alex1324575/snake-pcb-business-card/fabrication/drill_report.txt

Drill report for SnakeBusinessCard.kicad_pcb
Created on 2026-10-12T01:39:45

Copper Layer Stackup:
    =============================================================
    L1 :  F.Cu                      front
    L2 :  B.Cu                      back

Drill file 'SnakeBusinessCard-PTH.drl' contains
    plated through holes:
    =============================================================
    T1  0.300mm  0.0118"  (175 holes))
    T2  0.300mm  0.0118"  (2 holes))
    T3  0.500mm  0.0197"  (4 holes)  (with 4 slots)

    Total plated holes count 181

Drill file 'SnakeBusinessCard-NPTH.drl' contains
    unplated through holes:
    =============================================================

    Total unplated holes count 0
