alex1324575/snake-pcb-business-card/contact/Example_QR.png

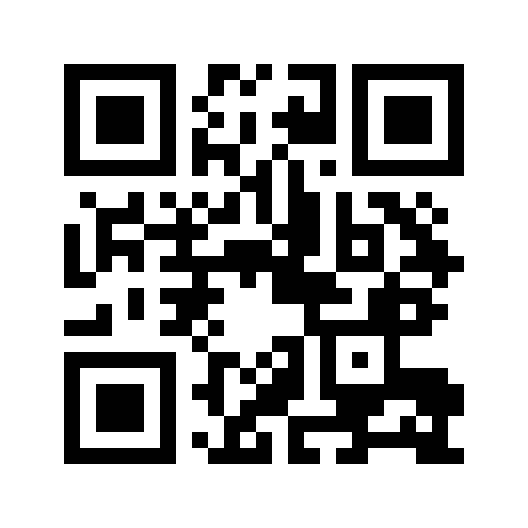
contact/Example_QR.png
