alex1324575/snake-pcb-business-card/docs/images/isometric.png

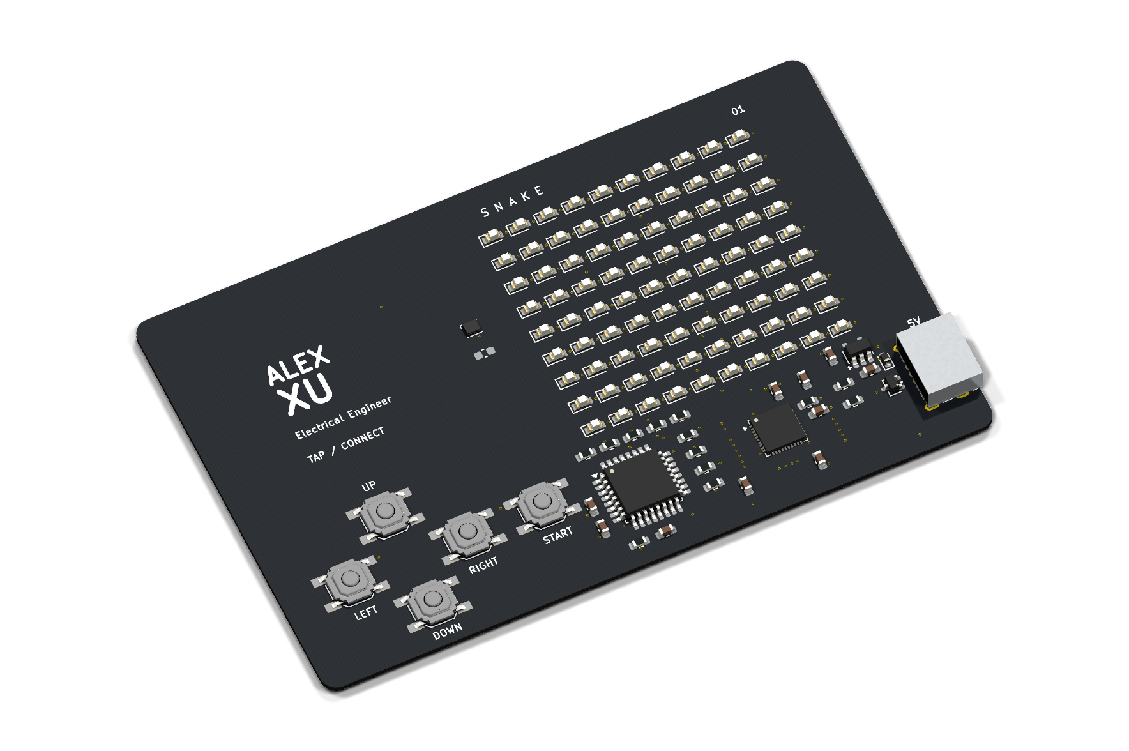
docs/images/isometric.png
