alex1324575/snake-pcb-business-card/docs/images/revc-3d-isometric.png

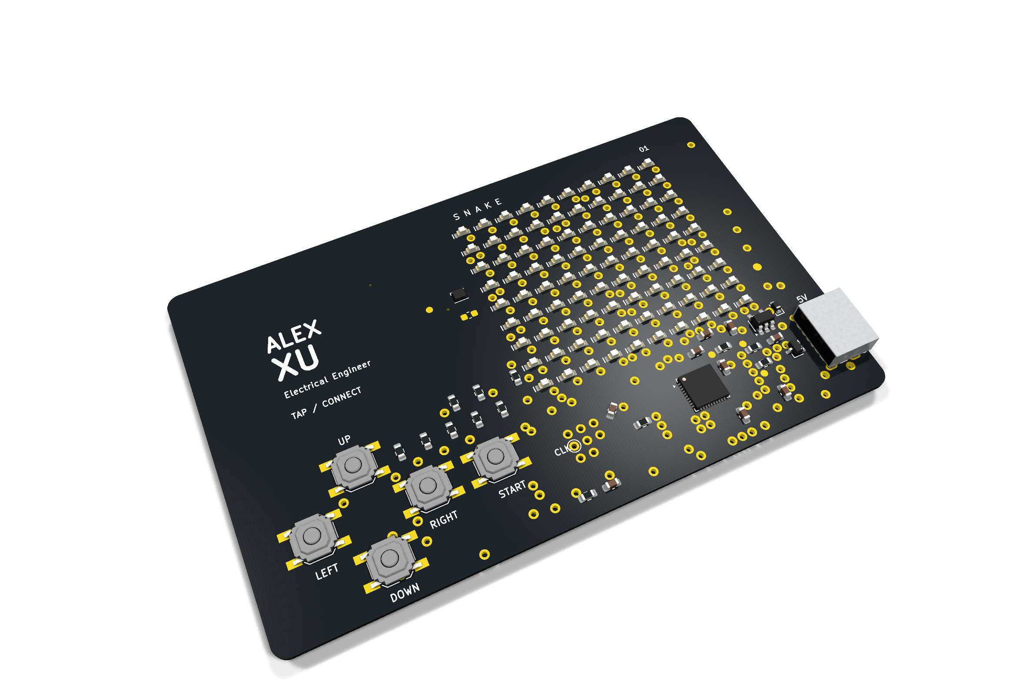
docs/images/revc-3d-isometric.png
