alex1324575/snake-pcb-business-card/docs/images/revc-3d-rotation.gif

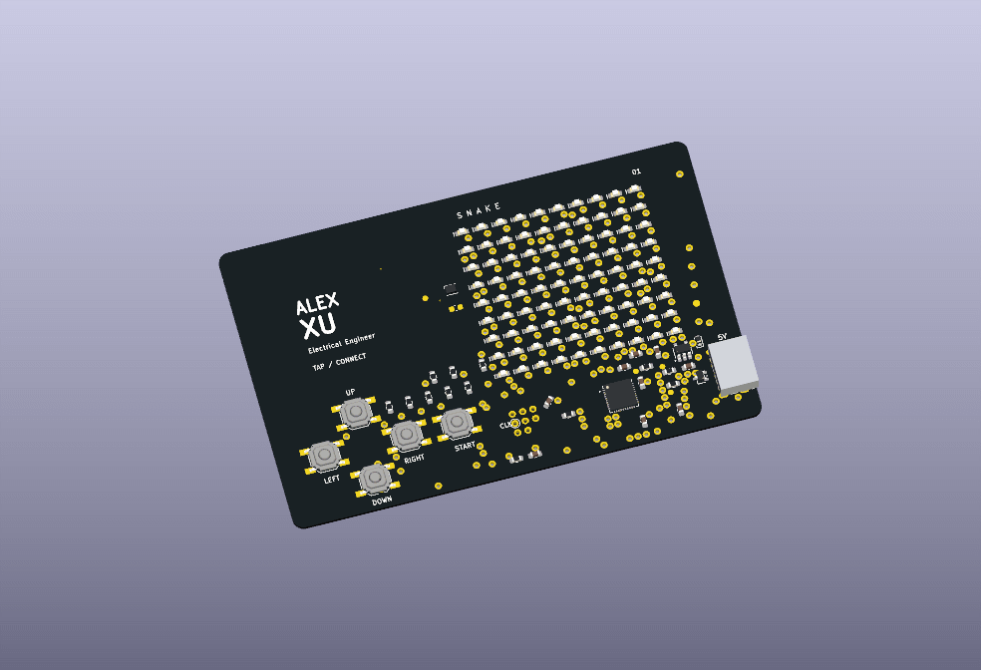
docs/images/revc-3d-rotation.gif
