alex1324575/snake-pcb-business-card/docs/images/revc-bottom.png

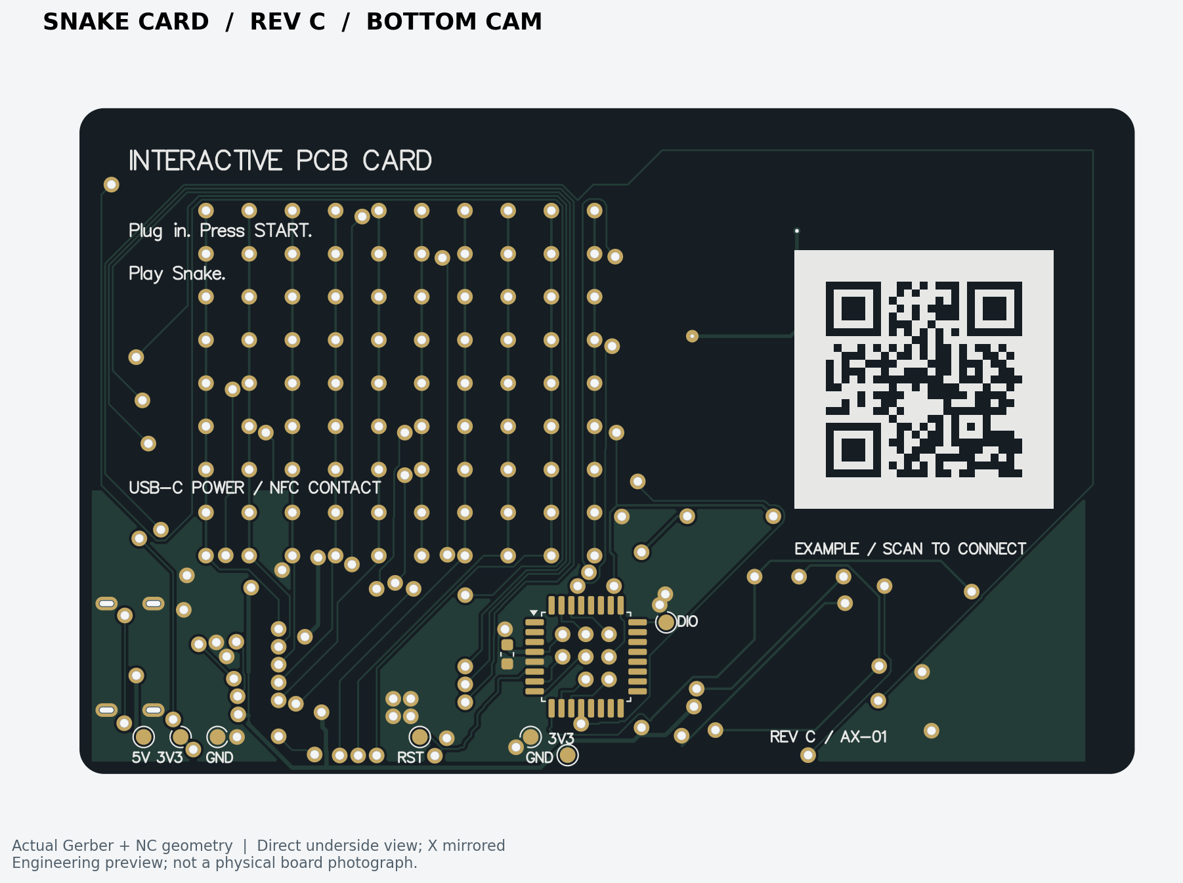
docs/images/revc-bottom.png
