alex1324575/snake-pcb-business-card/docs/images/revc-top.png

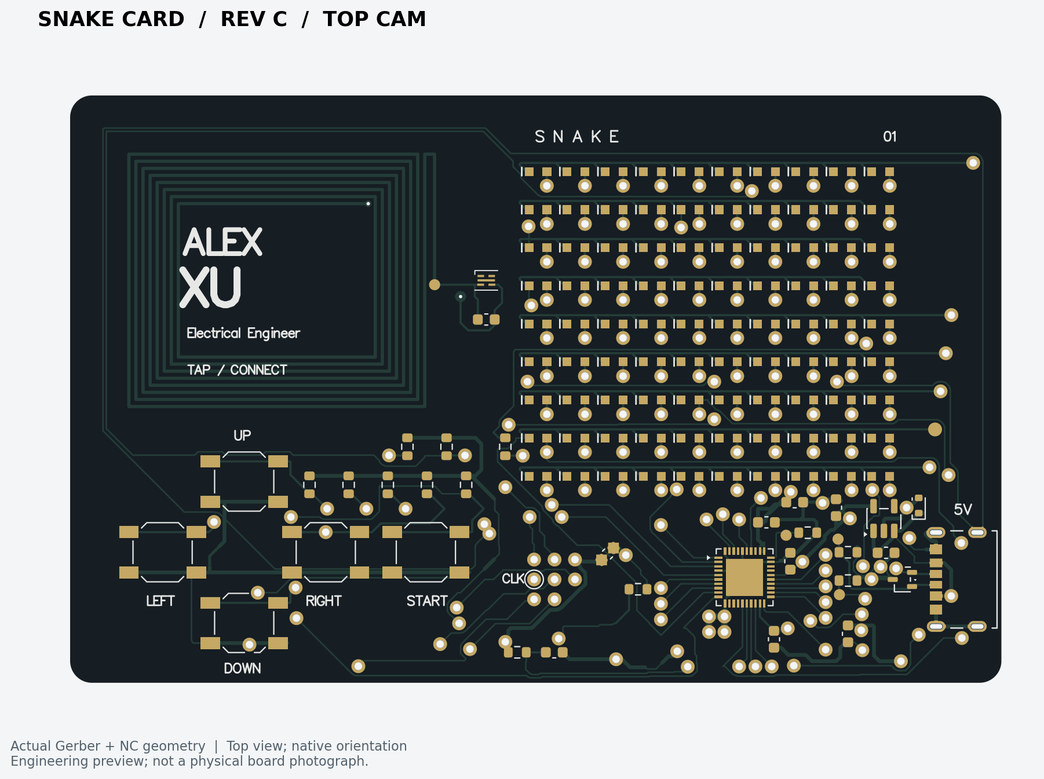
docs/images/revc-top.png
