alex1324575/snake-pcb-business-card/exports/Procurement_BOM.csv

References | Quantity per board | Manufacturer | MPN | Description | Footprint | Datasheet | Review status | Open items
U1 | 1 | STMicroelectronics | STM32G030K8T6 | Cortex-M0+ MCU, 64 KB Flash, 8 KB SRAM, LQFP32 | Package_QFP:LQFP-32_7x7mm_P0.8mm | https://www.st.com/resource/en/datasheet/stm32g030k8.pdf | Document reviewed; assembly and bench open | Assembler acceptance of KiCad lands; power-up, SWD, reset, GPIO and watchdog tests.
U2 | 1 | Lumissil Microsystems | IS31FL3737-QFLS4-TR | 144-channel matrix LED driver, QFN40 with exposed pad | SnakeCard:IS31FL3737_QFN40_5x5mm_P0.4mm_EP3.4mm | https://www.lumissil.com/assets/pdf/core/IS31FL3737_DS.pdf | Document reviewed; assembly and bench open | QFN via/paste process; LED current and thermal measurements; I2C rise/fall <=300 ns at U2.
U3 | 1 | Texas Instruments | TLV75533PDBVR | 3.3 V fixed LDO, DBV SOT-23-5 | Package_TO_SOT_SMD:SOT-23-5 | https://www.ti.com/lit/ds/symlink/tlv755p.pdf | Document reviewed; capacitor and bench open | Effective C1/C2 capacitance; stability, startup and thermal measurement; input transient qualification.
U4 | 1 | STMicroelectronics | ST25TN01K-AFH5 | Passive NFC Type 2 tag, 50 pF option, UFDFPN5 | SnakeCard:ST25TN01K_UFDFPN5_1.7x1.4mm | https://www.st.com/resource/en/datasheet/st25tn01k.pdf | Document reviewed; RF function open | Antenna measurement/tuning; physical tag write/read and phone range tests.
U5 | 1 | Texas Instruments | TPD2E2U06DCKR | Two-channel CC-line ESD protection, DCK SC70-3 | Package_TO_SOT_SMD:SOT-323_SC-70 | https://www.ti.com/lit/ds/symlink/tpd2e2u06.pdf | Document reviewed; transient qualification open | Board-level ESD and hot-plug tests; no DC overvoltage protection claim.
D91 | 1 | Texas Instruments | TPD1E10B06DYAR | Bidirectional VBUS ESD protection, DYA SOD-523 | Diode_SMD:D_SOD-523 | https://www.ti.com/lit/ds/symlink/tpd1e10b06.pdf | Document reviewed; protection coordination open | Published clamp exceeds LDO absolute maximum; measure input transient stress and revise protection if necessary.
J1 | 1 | Same Sky | UJC-HP-3-SMT-TR | USB-C power-only receptacle for 0.8 mm PCB, six contacts and four shell anchors | SnakeCard:CUI_UJC-HP-3-SMT-TR | https://www.sameskydevices.com/product/resource/ujc-hp-3-smt-tr.pdf | Drawing reviewed; mechanical fit open | Finished plated slots, shell protrusion and real plug clearance; assembler process acceptance.
SW1, SW2, SW3, SW4, SW5 | 5 | Alps Alpine | SKQGABE010 | 5.2 mm tactile switch, 1.5 mm height, 1.57 N, with stem | Button_Switch_SMD:SW_SPST_SKQG_WithStem | https://tech.alpsalpine.com/cms.media/SKQGAB_KQG_719_EN_cc4e10226e.pdf | Document reviewed; assembly issue open | Resolve switch-area through-via/flux-ingress restriction before assembly; verify contact and debounce on sample.
D1, D2, D3, D4, D5, D6, D7, D8, D9, D10, D11, D12, D13, D14, D15, D16, D17, D18, D19, D20, D21, D22, D23, D24, D25, D26, D27, D28, D29, D30, D31, D32, D33, D34, D35, D36, D37, D38, D39, D40, D41, D42, D43, D44, D45, D46, D47, D48, D49, D50, D51, D52, D53, D54, D55, D56, D57, D58, D59, D60, D61, D62, D63, D64, D65, D66, D67, D68, D69, D70, D71, D72, D73, D74, D75, D76, D77, D78, D79, D80, D81, D82, D83, D84, D85, D86, D87, D88, D89, D90 | 90 | Kingbright | APT1608SURCK | Red LED, 0603, 1.6 x 0.8 x 0.75 mm | SnakeCard:Kingbright_APT1608SURCK | https://www.kingbrightusa.com/images/catalog/SPEC/APT1608SURCK.pdf | Document reviewed; optical and thermal open | Polarity and reel orientation; MSL/reflow handling; low-rail/cold VF headroom, brightness and ghosting.
C1, C2, C23, C24 | 4 | TDK | C1608X7R1V105K080AC | 1 uF X7R ceramic capacitor, 0603 / 1608 metric, 35 V, +/-10%, paper tape on 180 mm reel | Capacitor_SMD:C_0603_1608Metric | https://product.tdk.com/system/files/dam/doc/product/capacitor/ceramic/mlcc/charasheet/c1608x7r1v105k080ac.pdf | CONDITIONAL_EFFECTIVE_CAPACITANCE | Nominal capacitance and geometry unchanged; rating raised from 10 V. C1 is on VBUS; C2/C23/C24 are on 3.3 V. Exact-part DC-bias characterization is linked but numerical values at 5 V/5.5 V and 3.3 V were not obtained. C1/C2 require more than 0.47 uF effective at regulator pins after bias, tolerance, temperature and aging. Existing IPC lands differ from manufacturer reflow recommendations; assembler process approval remains open.
C10, C12, C20, C21, C22 | 5 | TDK | C1608X7R1H104K080AA | 100 nF X7R ceramic capacitor, 0603 / 1608 metric, 50 V, +/-10%, paper tape on 180 mm reel | Capacitor_SMD:C_0603_1608Metric | https://product.tdk.com/info/en/documents/chara_sheet/C1608X7R1H104K080AA.pdf | CONDITIONAL_BOARD_VALIDATION | Nominal capacitance and geometry unchanged; rating raised from 10 V. Voltage stress is 6.6% of rating at 3.3 V. Biased capacitance not numerically qualified. Verify decoupling and NRST response on first board. Existing IPC lands differ from manufacturer reflow recommendations; assembler process approval remains open.
C11 | 1 | Murata Manufacturing | GRM188Z71C475KE21D | 4.7 uF X7R(Murata) ceramic capacitor, 0603 / 1608 metric, 16 V, +/-10%, D suffix 180 mm paper-tape reel | Capacitor_SMD:C_0603_1608Metric | https://search.murata.co.jp/Ceramy/image/img/A01X/G101/ENG/GRM188Z71C475KE21-01A.pdf | CONDITIONAL_EFFECTIVE_CAPACITANCE | Nominal capacitance and geometry unchanged; rating raised from 10 V. X7R(Murata) uses a temperature characteristic evaluated with half-rated DC bias, not the ordinary EIA X7R condition. Record exact-part effective capacitance at 3.3 V before final qualification. The compact schematic value omits the dielectric, which remains mandatory in this purchasing description.
R1, R2 | 2 | Panasonic Industry | ERJ3EKF5101V | 5.1 kohm precision thick-film resistor, 0603, +/-1%, 0.1 W at 70 C, +/-100 ppm/K, V suffix paper tape | Resistor_SMD:R_0603_1608Metric | https://industrial.panasonic.com/cdbs/www-data/pdf/RDA0000/AOA0000C304.pdf | DOCUMENT_REVIEW_COMPLETE | USB CC pull-downs. At a conservative 5.5 V across each resistor and -1% R, power is 5.99 mW versus 100 mW at 70 C. Initial resistance is 5.049 to 5.151 kohm. Temperature, aging and assembled USB attach behavior remain additional checks.
R10, R11, R12, R13, R14, R15, R23 | 7 | Panasonic Industry | ERJ3EKF1002V | 10 kohm precision thick-film resistor, 0603, +/-1%, 0.1 W at 70 C, +/-100 ppm/K, V suffix paper tape | Resistor_SMD:R_0603_1608Metric | https://industrial.panasonic.com/cdbs/www-data/pdf/RDA0000/AOA0000C304.pdf | DOCUMENT_REVIEW_COMPLETE | Nominal resistance unchanged; tolerance explicitly fixed to 1%. At 3.6 V and -1% R, power is 1.31 mW. Functional reset, button and driver configuration checks remain first-board tasks.
R20, R21 | 2 | Panasonic Industry | ERJ3EKF2201V | 2.2 kohm precision thick-film resistor, 0603, +/-1%, 0.1 W at 70 C, +/-100 ppm/K, V suffix paper tape | Resistor_SMD:R_0603_1608Metric | https://industrial.panasonic.com/cdbs/www-data/pdf/RDA0000/AOA0000C304.pdf | DOCUMENT_REVIEW_COMPLETE | I2C pull-ups. At 3.6 V and -1% R, power is 5.95 mW. Lowest DC working-voltage screening bound sqrt(0.1 W * 2178 ohm) is 14.8 V. Board bus capacitance, sink level and rise/fall timing must be measured.
R22 | 1 | Panasonic Industry | ERJ3EKF1003V | 100 kohm precision thick-film resistor, 0603, +/-1%, 0.1 W at 70 C, +/-100 ppm/K, V suffix paper tape | Resistor_SMD:R_0603_1608Metric | https://industrial.panasonic.com/cdbs/www-data/pdf/RDA0000/AOA0000C304.pdf | DOCUMENT_REVIEW_COMPLETE | LED_EN pull-down. At 3.6 V and -1% R, power is 0.131 mW. Verify the display remains off through reset and power ramps on first board.
R24 | 1 | Panasonic Industry | ERJ3EKF2002V | 20 kohm precision thick-film resistor, 0603, +/-1%, 0.1 W at 70 C, +/-100 ppm/K, V suffix paper tape | Resistor_SMD:R_0603_1608Metric | https://industrial.panasonic.com/cdbs/www-data/pdf/RDA0000/AOA0000C304.pdf | DOCUMENT_REVIEW_COMPLETE | LED-driver current-setting resistor. At a conservative 3.6 V across it and -1% R, power is 0.655 mW. Initial R range 19.8 to 20.2 kohm adds about -0.99%/+1.01% to inverse-R current variation before driver, temperature and aging tolerances. Verify channel current and supply load on first board.
