alex1324575/snake-pcb-business-card/exports/SnakeBusinessCard_BOM.csv

References | Value | Manufacturer | MPN | Footprint | Quantity | DNP | Datasheet
C1,C2,C23,C24 | 1u / 35V X7R | TDK | C1608X7R1V105K080AC | Capacitor_SMD:C_0603_1608Metric | 4 |  | https://product.tdk.com/system/files/dam/doc/product/capacitor/ceramic/mlcc/charasheet/c1608x7r1v105k080ac.pdf
C10,C12,C20-C22 | 100n / 50V X7R | TDK | C1608X7R1H104K080AA | Capacitor_SMD:C_0603_1608Metric | 5 |  | https://product.tdk.com/info/en/documents/chara_sheet/C1608X7R1H104K080AA.pdf
C11 | 4.7u / 16V | Murata Manufacturing | GRM188Z71C475KE21D | Capacitor_SMD:C_0603_1608Metric | 1 |  | https://search.murata.co.jp/Ceramy/image/img/A01X/G101/ENG/GRM188Z71C475KE21-01A.pdf
C30 | DNP / C0G TUNE |  |  | Capacitor_SMD:C_0603_1608Metric | 1 | DNP
D1-D90 | RED | Kingbright | APT1608SURCK | SnakeCard:Kingbright_APT1608SURCK | 90 |  | https://www.kingbrightusa.com/images/catalog/SPEC/APT1608SURCK.pdf
D91 | TPD1E10B06 | Texas Instruments | TPD1E10B06DYAR | Diode_SMD:D_SOD-523 | 1 |  | https://www.ti.com/lit/ds/symlink/tpd1e10b06.pdf
J1 | UJC-HP-3-SMT-TR | Same Sky | UJC-HP-3-SMT-TR | SnakeCard:CUI_UJC-HP-3-SMT-TR | 1 |  | https://www.sameskydevices.com/product/resource/ujc-hp-3-smt-tr.pdf
R1,R2 | 5.1k 1% | Panasonic Industry | ERJ3EKF5101V | Resistor_SMD:R_0603_1608Metric | 2 |  | https://industrial.panasonic.com/cdbs/www-data/pdf/RDA0000/AOA0000C304.pdf
R10-R15,R23 | 10k 1% | Panasonic Industry | ERJ3EKF1002V | Resistor_SMD:R_0603_1608Metric | 7 |  | https://industrial.panasonic.com/cdbs/www-data/pdf/RDA0000/AOA0000C304.pdf
R20,R21 | 2.2k 1% | Panasonic Industry | ERJ3EKF2201V | Resistor_SMD:R_0603_1608Metric | 2 |  | https://industrial.panasonic.com/cdbs/www-data/pdf/RDA0000/AOA0000C304.pdf
R22 | 100k 1% | Panasonic Industry | ERJ3EKF1003V | Resistor_SMD:R_0603_1608Metric | 1 |  | https://industrial.panasonic.com/cdbs/www-data/pdf/RDA0000/AOA0000C304.pdf
R24 | 20k 1% | Panasonic Industry | ERJ3EKF2002V | Resistor_SMD:R_0603_1608Metric | 1 |  | https://industrial.panasonic.com/cdbs/www-data/pdf/RDA0000/AOA0000C304.pdf
SW1 | UP | Alps Alpine | SKQGABE010 | Button_Switch_SMD:SW_SPST_SKQG_WithStem | 1 |  | https://tech.alpsalpine.com/cms.media/SKQGAB_KQG_719_EN_cc4e10226e.pdf
SW2 | DOWN | Alps Alpine | SKQGABE010 | Button_Switch_SMD:SW_SPST_SKQG_WithStem | 1 |  | https://tech.alpsalpine.com/cms.media/SKQGAB_KQG_719_EN_cc4e10226e.pdf
SW3 | LEFT | Alps Alpine | SKQGABE010 | Button_Switch_SMD:SW_SPST_SKQG_WithStem | 1 |  | https://tech.alpsalpine.com/cms.media/SKQGAB_KQG_719_EN_cc4e10226e.pdf
SW4 | RIGHT | Alps Alpine | SKQGABE010 | Button_Switch_SMD:SW_SPST_SKQG_WithStem | 1 |  | https://tech.alpsalpine.com/cms.media/SKQGAB_KQG_719_EN_cc4e10226e.pdf
SW5 | START | Alps Alpine | SKQGABE010 | Button_Switch_SMD:SW_SPST_SKQG_WithStem | 1 |  | https://tech.alpsalpine.com/cms.media/SKQGAB_KQG_719_EN_cc4e10226e.pdf
TP1 | VBUS_5V |  |  | TestPoint:TestPoint_Pad_D1.0mm | 1
TP2,TP4 | +3V3 |  |  | TestPoint:TestPoint_Pad_D1.0mm | 2
TP3,TP5 | GND |  |  | TestPoint:TestPoint_Pad_D1.0mm | 2
TP6 | SWDIO |  |  | TestPoint:TestPoint_Pad_D1.0mm | 1
TP7 | SWCLK |  |  | TestPoint:TestPoint_Pad_D1.0mm | 1
TP8 | NRST |  |  | TestPoint:TestPoint_Pad_D1.0mm | 1
U1 | STM32G030K8T6 | STMicroelectronics | STM32G030K8T6 | Package_QFP:LQFP-32_7x7mm_P0.8mm | 1 |  | https://www.st.com/resource/en/datasheet/stm32g030k8.pdf
U2 | IS31FL3737-QFLS4-TR | Lumissil Microsystems | IS31FL3737-QFLS4-TR | SnakeCard:IS31FL3737_QFN40_5x5mm_P0.4mm_EP3.4mm | 1 |  | https://www.lumissil.com/assets/pdf/core/IS31FL3737_DS.pdf
U3 | TLV75533PDBVR | Texas Instruments | TLV75533PDBVR | Package_TO_SOT_SMD:SOT-23-5 | 1 |  | https://www.ti.com/lit/ds/symlink/tlv755p.pdf
U4 | ST25TN01K-AFH5 | STMicroelectronics | ST25TN01K-AFH5 | SnakeCard:ST25TN01K_UFDFPN5_1.7x1.4mm | 1 |  | https://www.st.com/resource/en/datasheet/st25tn01k.pdf
U5 | TPD2E2U06DCK | Texas Instruments | TPD2E2U06DCKR | Package_TO_SOT_SMD:SOT-323_SC-70 | 1 |  | https://www.ti.com/lit/ds/symlink/tpd2e2u06.pdf
