alex1324575/snake-pcb-business-card/fabrication/revc/README.md

# Rev C manufacturing data

These 11 machine files are the native exports reviewed on 28 October 2026: nine Gerber layers, one plated round-hole file and one plated slot file. They are byte-identical to the verified engineering outputs. There are no NPTH holes in this revision.

Read the [fabrication specification](../../docs/revc/FABRICATION_NOTES.md) and [CAM review](../../verification/revc/CAM_VISUAL_REVIEW.md). The [publication manifest](../../verification/revc/PUBLICATION_MANIFEST.json) binds exact hashes. Upload the 11 machine files together; keep this README outside the manufacturer upload archive.

Use only the matching [Rev C BOM and assembly documents](../../docs/revc/assembly/BOM.md). Supplier acceptance of thickness, plated slots and stencil processing remains pending. Physical qualification is not complete.
