alex1324575/snake-pcb-business-card/docs/revc/assembly/PLACEMENT_REGISTER.md

# Rev C per-reference placement register

Variant SC-REVC-LCSC-P1; 125 fitted references.

**Units: mm.** XY is the native Altium component origin, not a measured package centroid. Native X increases right and Y increases up in Top view. Board-local XY = (native X - 100, native Y). Bottom drawing X is mirrored for a person looking directly at the underside; this table remains in the same unmirrored native frame. Native rotations require assembler-specific zero-angle verification before automated placement.

| Ref | Side | Native X | Native Y | Native angle | Selected MPN |
|---|---|---:|---:|---:|---|
| C1 | Top | 175.0000 | 11.9500 | 0 deg | CL10B105KA8NNNC |
| C2 | Top | 170.4000 | 16.1000 | 90 deg | CL10B105KA8NNNC |
| C10 | Bottom | 150.9000 | 9.7000 | 270 deg | CC0603KRX7R9BB104 |
| C11 | Top | 149.3984 | 11.8408 | 45 deg | GRM188Z71C475KE21D |
| C12 | Top | 144.5000 | 2.8000 | 0 deg | CC0603KRX7R9BB104 |
| C20 | Top | 164.0000 | 14.7500 | 0 deg | CC0603KRX7R9BB104 |
| C21 | Top | 166.2000 | 11.1750 | 90 deg | CC0603KRX7R9BB104 |
| C22 | Top | 164.7000 | 4.0000 | 270 deg | CC0603KRX7R9BB104 |
| C23 | Top | 171.5000 | 4.5000 | 270 deg | CL10B105KA8NNNC |
| C24 | Top | 166.6000 | 16.6000 | 0 deg | CL10B105KA8NNNC |
| D1 | Top | 143.0000 | 47.0000 | 0 deg | KT-0603R |
| D2 | Top | 146.5000 | 47.0000 | 0 deg | KT-0603R |
| D3 | Top | 150.0000 | 47.0000 | 0 deg | KT-0603R |
| D4 | Top | 153.5000 | 47.0000 | 0 deg | KT-0603R |
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
| D83 | Top | 150.0000 | 19.0000 | 0 deg | KT-0603R |
| D84 | Top | 153.5000 | 19.0000 | 0 deg | KT-0603R |
| D85 | Top | 157.0000 | 19.0000 | 0 deg | KT-0603R |
| D86 | Top | 160.5000 | 19.0000 | 0 deg | KT-0603R |
| D87 | Top | 164.0000 | 19.0000 | 0 deg | KT-0603R |
| D88 | Top | 167.5000 | 19.0000 | 0 deg | KT-0603R |
| D89 | Top | 171.0000 | 19.0000 | 0 deg | KT-0603R |
| D90 | Top | 174.5000 | 19.0000 | 0 deg | KT-0603R |
| D91 | Top | 178.0000 | 16.3000 | 90 deg | PESD5Z6.0,115 |
| J1 | Top | 179.6000 | 9.5000 | 90 deg | UJC-HP-3-SMT-TR |
| R1 | Top | 171.5000 | 12.0000 | 0 deg | ERJ3EKF5101V |
| R2 | Top | 171.5000 | 9.4000 | 0 deg | ERJ3EKF5101V |
| R10 | Top | 141.1000 | 2.8000 | 0 deg | ERJ3EKF1002V |
| R11 | Top | 122.0000 | 18.2000 | 270 deg | ERJ3EKF1002V |
| R12 | Top | 125.6000 | 18.2000 | 270 deg | ERJ3EKF1002V |
| R13 | Top | 129.2000 | 18.2000 | 270 deg | ERJ3EKF1002V |
| R14 | Top | 132.8000 | 18.2000 | 270 deg | ERJ3EKF1002V |
| R15 | Top | 136.4000 | 18.2000 | 270 deg | ERJ3EKF1002V |
| R20 | Top | 131.0000 | 21.7000 | 270 deg | ERJ3EKF2201V |
| R21 | Top | 134.6000 | 21.7000 | 270 deg | ERJ3EKF2201V |
| R22 | Top | 152.2000 | 8.6000 | 0 deg | 0603WAF1003T5E |
| R23 | Top | 140.0000 | 21.7000 | 270 deg | ERJ3EKF1002V |
| R24 | Top | 167.8000 | 13.8000 | 0 deg | ERJ3EKF2002V |
| SW1 | Top | 116.0000 | 18.5000 | 0 deg | SKQGABE010 |
| SW2 | Top | 116.0000 | 5.5000 | 0 deg | SKQGABE010 |
| SW3 | Top | 108.5000 | 12.0000 | 0 deg | SKQGABE010 |
| SW4 | Top | 123.5000 | 12.0000 | 0 deg | SKQGABE010 |
| SW5 | Top | 132.7000 | 12.0000 | 0 deg | SKQGABE010 |
| U1 | Bottom | 144.5000 | 9.5000 | 180 deg | STM32G030K8T6 |
| U2 | Top | 162.0000 | 9.7000 | 0 deg | IS31FL3737B-QFLS4-TR |
| U3 | Top | 174.8000 | 15.1000 | 90 deg | TPS7A2433DBVR |
| U4 | Top | 138.2500 | 37.0000 | 0 deg | ST25TN01K-AFH5 |
| U5 | Top | 176.5000 | 9.5000 | 180 deg | TPD2E2U06QDCKRQ1 |

## Orientation-sensitive pad locations

Pad 1 is an orientation reference. It is not a universal cathode or positive terminal. All values below use the native unmirrored frame.

| Ref | Physical side | Pad 1 X | Pad 1 Y | Pad 1 net | Placement check |
|---|---|---:|---:|---|---|
| U1 | Bottom | 148.6750 | 12.3000 | NC | Match package pin-1 mark to marked pad; read Bottom drawing |
| U2 | Top | 159.5925 | 11.5000 | LED_ROW1 | Match package pin-1 mark; exposed pad 41 to GND |
| U3 | Top | 173.8500 | 13.9625 | VBUS_5V | TPS7A2433DBVR: pin 1 IN; pin 2 GND; pin 3 EN; pin 4 NC; pin 5 OUT |
| U4 | Top | 137.7500 | 37.4000 | NC | Pins 1/2/5 NC; center pad 5 is not GND |
| U5 | Top | 177.3875 | 8.8500 | USB_CC1 | Pin 1 CC1; pin 2 CC2; pin 3 GND |
| D91 | Top | 178.0000 | 15.6000 | VBUS_5V | PESD5Z6.0,115: pin 1 cathode K to VBUS_5V; pin 2 anode A to GND; align cathode mark with pad 1 |
| D1 | Top | 142.1750 | 47.0000 | LED_ROW1 | All D1-D90 physical cathodes face left in Top view |
