alex1324575/snake-pcb-business-card/docs/revc/assembly/ASSEMBLY_REFERENCE.html

# Snake Card Rev C Assembly reference

SC-REVC-LCSC-P1 · 27 October 2026 · Public example ALEX XU

125 fitted parts: 123 Top, 2 Bottom. Use Top reflow, then manual Bottom U1/C10 and five switches. C30 remains DNP. This package describes a prototype assembly specification; manufacturing and hardware qualification require separate sign-off.

Assembly procedure · Exact BOM · Placement register · Library update controls

Saved native metadata readback passed; explicit final source hashes are recorded in assembly_validation.json.

## Top view

All 90 LEDs: physical cathode to the left. The red pad and bar identify the PCB cathode, regardless of supplier pin numbering. D91 is polarized: Nexperia PESD5Z6.0,115 pin 1 cathode to VBUS_5V; pin 2 anode to GND. Match its cathode mark to the red pad 1. U3 is TPS7A2433DBVR.

## Top detail

## Bottom view

Turn the board over left-to-right. This drawing shows the actual underside with readable text. Coordinates in the register remain in the native Top-view frame.

## Bottom and programming detail

## Find a component

Native XY is the component origin in millimeters, not a guaranteed package centroid. Native angles are not an automated assembler's rotation convention.

Ref | Side | Exact MPN | X mm | Y mm | Native angle | Process
C1 | Top | CL10B105KA8NNNC | 175.0000 | 11.9500 | 0 | Top reflow
C2 | Top | CL10B105KA8NNNC | 170.4000 | 16.1000 | 90 | Top reflow
C10 | Bottom | CC0603KRX7R9BB104 | 150.9000 | 9.7000 | 270 | Manual after Top reflow
C11 | Top | GRM188Z71C475KE21D | 149.3984 | 11.8408 | 45 | Top reflow
C12 | Top | CC0603KRX7R9BB104 | 144.5000 | 2.8000 | 0 | Top reflow
C20 | Top | CC0603KRX7R9BB104 | 164.0000 | 14.7500 | 0 | Top reflow
C21 | Top | CC0603KRX7R9BB104 | 166.2000 | 11.1750 | 90 | Top reflow
C22 | Top | CC0603KRX7R9BB104 | 164.7000 | 4.0000 | 270 | Top reflow
C23 | Top | CL10B105KA8NNNC | 171.5000 | 4.5000 | 270 | Top reflow
C24 | Top | CL10B105KA8NNNC | 166.6000 | 16.6000 | 0 | Top reflow
D1 | Top | KT-0603R | 143.0000 | 47.0000 | 0 | Top reflow
D2 | Top | KT-0603R | 146.5000 | 47.0000 | 0 | Top reflow
D3 | Top | KT-0603R | 150.0000 | 47.0000 | 0 | Top reflow
D4 | Top | KT-0603R | 153.5000 | 47.0000 | 0 | Top reflow
D5 | Top | KT-0603R | 157.0000 | 47.0000 | 0 | Top reflow
D6 | Top | KT-0603R | 160.5000 | 47.0000 | 0 | Top reflow
D7 | Top | KT-0603R | 164.0000 | 47.0000 | 0 | Top reflow
D8 | Top | KT-0603R | 167.5000 | 47.0000 | 0 | Top reflow
D9 | Top | KT-0603R | 171.0000 | 47.0000 | 0 | Top reflow
D10 | Top | KT-0603R | 174.5000 | 47.0000 | 0 | Top reflow
D11 | Top | KT-0603R | 143.0000 | 43.5000 | 0 | Top reflow
D12 | Top | KT-0603R | 146.5000 | 43.5000 | 0 | Top reflow
D13 | Top | KT-0603R | 150.0000 | 43.5000 | 0 | Top reflow
D14 | Top | KT-0603R | 153.5000 | 43.5000 | 0 | Top reflow
D15 | Top | KT-0603R | 157.0000 | 43.5000 | 0 | Top reflow
D16 | Top | KT-0603R | 160.5000 | 43.5000 | 0 | Top reflow
D17 | Top | KT-0603R | 164.0000 | 43.5000 | 0 | Top reflow
D18 | Top | KT-0603R | 167.5000 | 43.5000 | 0 | Top reflow
D19 | Top | KT-0603R | 171.0000 | 43.5000 | 0 | Top reflow
D20 | Top | KT-0603R | 174.5000 | 43.5000 | 0 | Top reflow
D21 | Top | KT-0603R | 143.0000 | 40.0000 | 0 | Top reflow
D22 | Top | KT-0603R | 146.5000 | 40.0000 | 0 | Top reflow
D23 | Top | KT-0603R | 150.0000 | 40.0000 | 0 | Top reflow
D24 | Top | KT-0603R | 153.5000 | 40.0000 | 0 | Top reflow
D25 | Top | KT-0603R | 157.0000 | 40.0000 | 0 | Top reflow
D26 | Top | KT-0603R | 160.5000 | 40.0000 | 0 | Top reflow
D27 | Top | KT-0603R | 164.0000 | 40.0000 | 0 | Top reflow
D28 | Top | KT-0603R | 167.5000 | 40.0000 | 0 | Top reflow
D29 | Top | KT-0603R | 171.0000 | 40.0000 | 0 | Top reflow
D30 | Top | KT-0603R | 174.5000 | 40.0000 | 0 | Top reflow
D31 | Top | KT-0603R | 143.0000 | 36.5000 | 0 | Top reflow
D32 | Top | KT-0603R | 146.5000 | 36.5000 | 0 | Top reflow
D33 | Top | KT-0603R | 150.0000 | 36.5000 | 0 | Top reflow
D34 | Top | KT-0603R | 153.5000 | 36.5000 | 0 | Top reflow
D35 | Top | KT-0603R | 157.0000 | 36.5000 | 0 | Top reflow
D36 | Top | KT-0603R | 160.5000 | 36.5000 | 0 | Top reflow
D37 | Top | KT-0603R | 164.0000 | 36.5000 | 0 | Top reflow
D38 | Top | KT-0603R | 167.5000 | 36.5000 | 0 | Top reflow
D39 | Top | KT-0603R | 171.0000 | 36.5000 | 0 | Top reflow
D40 | Top | KT-0603R | 174.5000 | 36.5000 | 0 | Top reflow
D41 | Top | KT-0603R | 143.0000 | 33.0000 | 0 | Top reflow
D42 | Top | KT-0603R | 146.5000 | 33.0000 | 0 | Top reflow
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
U1 | Bottom | STM32G030K8T6 | 144.5000 | 9.5000 | 180 | Manual after Top reflow
U2 | Top | IS31FL3737B-QFLS4-TR | 162.0000 | 9.7000 | 0 | Top reflow
U3 | Top | TPS7A2433DBVR | 174.8000 | 15.1000 | 90 | Top reflow
U4 | Top | ST25TN01K-AFH5 | 138.2500 | 37.0000 | 0 | Top reflow
U5 | Top | TPD2E2U06QDCKRQ1 | 176.5000 | 9.5000 | 180 | Top reflow
