alex1324575/snake-pcb-business-card/docs/images/revc-fabrication.png

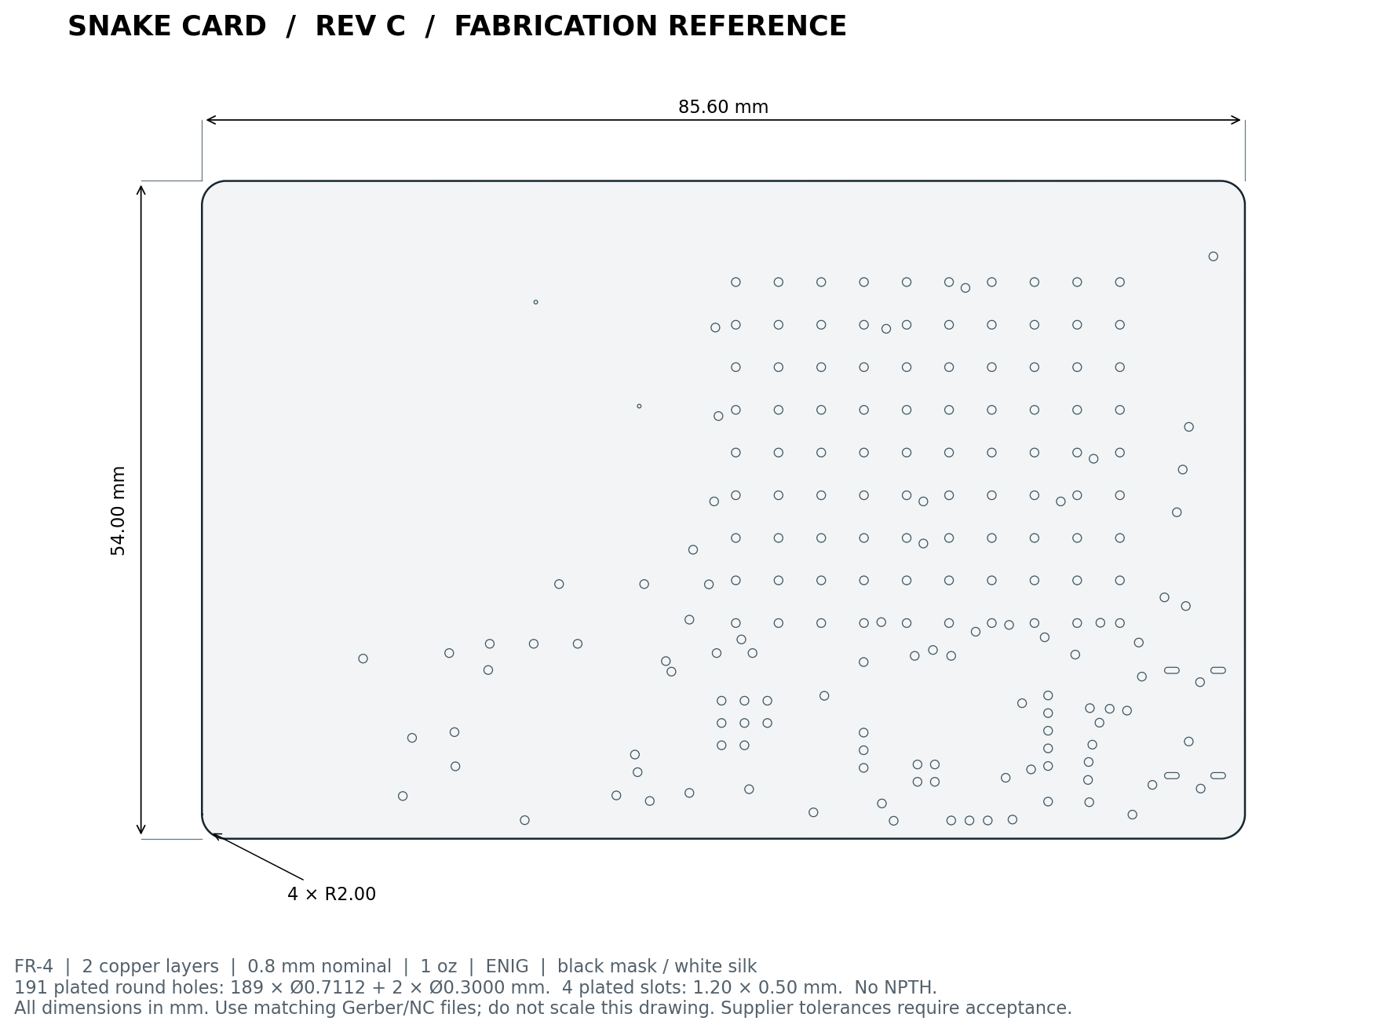
docs/images/revc-fabrication.png
