alex1324575/snake-pcb-business-card/docs/revc/assembly/assembly_bottom.png

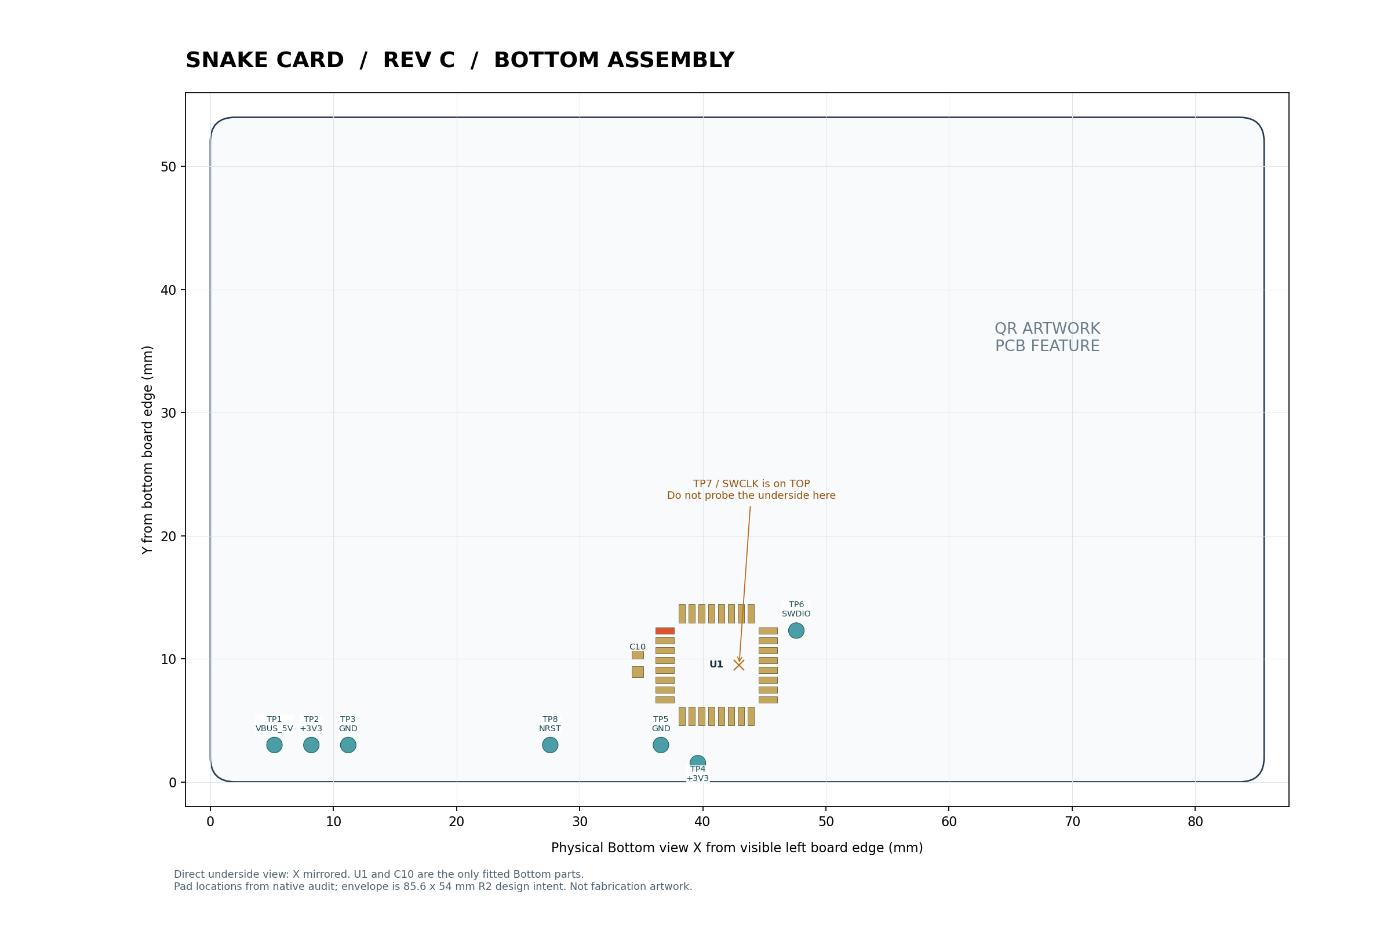
docs/revc/assembly/assembly_bottom.png
