alex1324575/snake-pcb-business-card/verification/revc/CAM_VISUAL_REVIEW.md

# Rev C CAM Visual Review

**PASS — Visual and geometry checks; Gerber and NC export freshness confirmed.**

Source PCB SHA-256: `a3c1bad7ac39c80c9fc90f9bd20d366df778fe45630cac338fb5efb860d3ac84`. All nine inspected Gerbers were exported at **2026-10-28 11:12:59 local**.

## Actual Top CAM inspected

**PASS** — ALEX XU / Electrical Engineer public artwork; NFC coil on left; 10 by 9 LED grid on right; five controls and USB power area below. CLK is readable next to the Top SWCLK test pad, near native TP7 (142.6464,9.4996 mm).

## Actual Bottom CAM inspected

**PASS** — Direct underside view mirrors X only. REV C / AX-01 is readable at lower right. DIO is readable beside Bottom SWDIO pad TP6 (137.9982,12.2936 mm), adjacent to MCU. No stale REV B marking visible.

## Public QR decoded from actual Bottom CAM image

**PASS** — OpenCV QRCodeDetector decoded https://example.com/ from ../../docs/images/revc-bottom.png. This matches the intended ALEX XU public example card; it does not expose a private contact link.

## Both board faces and outline

**PASS** — Both copper/silk faces rendered from their corresponding actual layers; 85.60 by 54.00 mm design envelope with four R2 corners. GM has eight nonzero segments, four valid arcs, closed degree-two topology and zero invalid arcs.

## Fabrication reference inspected

**PASS** — Dimensions, corner callout, 191 round holes and four horizontal USB shell plated slots agree with the independent CAM/native audit. No outlying holes or duplicated profile visible.

## Export generation consistency

**PASS** — All nine Gerbers report 2026-10-28T11:12:59 local modification time and show corrected Rev C/SWD silk. Both NC files were natively re-exported at **2026-10-28 11:14:50 local**. Their hashes are identical to the previously reviewed files, and all 195 geometries match the same final saved PCB. Final native export record, ERC and package manifest are separate evidence.

## Independent measurements

| Check | Top | Bottom |
|---|---:|---:|
| Minimum copper to design edge | 0.3822 mm | 0.33305 mm |
| Copper outside board area | 0 mm² | 0 mm² |
| Minimum paste area ratio at 0.10 mm foil | 0.76419 | 1.94585 |
| Minimum paste aperture web | 0.14998 mm | 0.30000 mm |

The drill audit matched 191 plated round holes and four 1.20 × 0.50 mm plated slots; no NPTH. Maximum matched-center error was 0.00000257 mm. The frozen 43-rule stream hash is unchanged.

## Reviewed previews

- `../../docs/images/revc-top.png`
- `../../docs/images/revc-bottom.png`
- `../../docs/images/revc-fabrication.png`

These derive from the actual Gerber/NC geometry. Full file hashes, review scope and retained limitations are in `CAM_VISUAL_REVIEW.json`. NC re-export freshness is confirmed with identical content hashes. Final native export/validation record and release manifest remain separate evidence; physical qualification remains NOT TESTED.
