alex1324575/snake-pcb-business-card/verification/revc/NATIVE_VALIDATION_REVIEW.md

# Native Rev C schematic validation

Altium project validation at **28 October 2026, 11:16:49**: **compile successful, zero errors and two reviewed warnings**. The complete native message report is [Final_Native_ERC.html](Final_Native_ERC.html); the source-bound machine record is [NATIVE_VALIDATION_REVIEW.json](NATIVE_VALIDATION_REVIEW.json).

| Net | Actual bias | Disposition |
|---|---|---|
| LED_IICRST | R23 10 kohm to GND, U2 pin 39 input | Intentional pull-down. The [driver datasheet](https://www.lumissil.com/assets/pdf/core/IS31FL3737B_DS.pdf), Rev D, requires this active-high reset input low in normal operation. |
| NRST | R10 10 kohm to +3V3, C12 filter, U1 pin 6 input and TP8 | Intentional passive pull-up and reset filter. Programming equipment may pull the reset node low. |

Neither resistor is an active output driver, so the compiler reports both nets. Pin types and connections remain unchanged. No additional No-ERC marker or rule suppression was used. This is a reviewed-warning result, not a zero-warning result.

All original isolated NC markers remain protected by the independent saved-source audit. Physical startup, reset and programming tests remain NOT TESTED.
