alex1324575/snake-pcb-business-card/verification/revc/Final_Native_ERC.html

customize

# Message List

Date: | | 10/28/2026
Time: | | 11:19:43 AM
Elapsed Time: | | 00:00:00

Class | Document | Source | Message | Time | Date | No.
[Warning] | SnakeCard_Native.SchDoc | Compiler | Net LED_IICRST has no driving source (Pin R23-1, Pin U2-39) | 11:16:49 AM | 10/28/2026 | 1
[Warning] | SnakeCard_Native.SchDoc | Compiler | Net NRST has no driving source (Pin C12-1, Pin R10-2, Pin TP8-1, Pin U1-6) | 11:16:49 AM | 10/28/2026 | 2
[Info] | SnakeCard_RevC.PrjPcb | Compiler | Compile successful, no errors found. | 11:16:49 AM | 10/28/2026 | 3

Back to top
