alex1324575/snake-pcb-business-card/verification/revc/Final_Reopened_DRC.html

# Design Rule Verification Report

Date: | | 10/28/2026
Time: | | 1:15:55 AM
Elapsed Time: | | 00:00:01
Filename: | | altium\SnakeCard_Native.PcbDoc

Warnings: | | 0
Rule Violations: | | 0

## Summary

Warnings | Count
Total | 0

Rule Violations | Count
Clearance Constraint (Gap=0mm) (IsFill And IsKeepOut And InComponent('SW1')),(IsPad And InComponent('SW1')) | 0
Clearance Constraint (Gap=0.15mm) (All),(All) | 0
Clearance Constraint (Gap=0.2mm) (InNamedPolygon('B.Cu-GND')),(All) | 0
Clearance Constraint (Gap=0mm) (IsFill And IsKeepOut And InComponent('SW2')),(IsPad And InComponent('SW2')) | 0
Clearance Constraint (Gap=0mm) (IsFill And IsKeepOut And InComponent('SW5')),(IsPad And InComponent('SW5')) | 0
Clearance Constraint (Gap=0mm) (IsFill And IsKeepOut And InComponent('SW4')),(IsPad And InComponent('SW4')) | 0
Clearance Constraint (Gap=0mm) (IsFill And IsKeepOut And InComponent('SW3')),(IsPad And InComponent('SW3')) | 0
Short-Circuit Constraint (Allowed=No) (All),(All) | 0
Un-Routed Net Constraint ( (All) ) | 0
Modified Polygon (Allow modified: No), (Allow shelved: No) | 0
Width Constraint (Min=0.15mm) (Max=10mm) (Preferred=0.2mm) (All) | 0
Routing Topology Rule(Topology=Shortest) (All) | 0
Routing Layers(All) | 0
Routing Via (MinHoleWidth=0.711mm) (MaxHoleWidth=0.711mm) (PreferredHoleWidth=0.711mm) (MinWidth=1.27mm) (MaxWidth=1.27mm) (PreferedWidth=1.27mm) (All) | 0
Differential Pairs Uncoupled Length using the Gap Constraints (Min=0.254mm) (Max=0.254mm) (Prefered=0.254mm) and Width Constraints (Min=0.381mm) (Max=0.381mm) (Prefered=0.381mm) (All) | 0
Power Plane Connect Rule(Relief Connect )(Expansion=0.508mm) (Conductor Width=0.254mm) (Air Gap=0.254mm) (Entries=4) (All) | 0
Fabrication Testpoint Style (Under Component=Yes) (All) | 0
Fabrication Testpoint Usage (Valid =One Required, Allow multiple per net=No) (All) | 0
Assembly Testpoint Style (Under Component=Yes) (All) | 0
Assembly Testpoint Usage (Valid =One Required, Allow multiple per net=No) (All) | 0
Minimum Annular Ring (Minimum=0.1mm) (All) | 0
Hole Size Constraint (Min=0.3mm) (Max=2.54mm) (All) | 0
Pads and Vias to follow the Drill pairs settings | 0
Hole To Hole Clearance (Gap=0.254mm) (All),(All) | 0
Minimum Solder Mask Sliver (Gap=0.13mm) (All),(All) | 0
Silk To Solder Mask (Clearance=0.15mm) (All),(All) | 0
Silk to Silk (Clearance=0mm) (All),(All) | 0
Net Antennae (Tolerance=0mm) (All) | 0
Board Clearance Constraint (Gap=0mm) (All) | 0
Component Clearance Constraint ( Horizontal Gap = 0.254mm, Vertical Gap = 0.254mm ) (All),(All) | 0
Height Constraint (Min=0mm) (Max=25.4mm) (Prefered=12.7mm) (All) | 0
Total | 0
