alex1324575/snake-pcb-business-card/docs/revc/native-plan/revc-swd-silk-stage-result.tsv

Path | altium\SnakeCard_Native.PcbDoc
After | CLK | 33 | 55039370 | 3622047
After | DIO | 34 | 53937008 | 4724409
Errors | 0
NoAutomaticSave | True
