alex1324575/snake-pcb-business-card/docs/revc/native-plan/revc-pcb-metadata-stage-result.tsv

Path | altium\SnakeCard_Native.PcbDoc
ComponentBefore | C1 | C_0603_1608Metric | 1u / 35V X7R | ALWPYDYZ | QHMLXCWI
ComponentBefore | C2 | C_0603_1608Metric | 1u / 35V X7R | ULNUXRKB | GUUAVPPO
ComponentBefore | C10 | C_0603_1608Metric | 100n / 50V X7R | KNQJWXWA | OVWBNCKK
ComponentBefore | C11 | C_0603_1608Metric | 4.7u / 16V | HLVBZTEV | DOTFPVLB
ComponentBefore | C12 | C_0603_1608Metric | 100n / 50V X7R | TRSMTTSR | RJPSLQQJ
ComponentBefore | C20 | C_0603_1608Metric | 100n / 50V X7R | FUBANWEU | BCCKOXFX
ComponentBefore | C21 | C_0603_1608Metric | 100n / 50V X7R | KLTUDAZD | WCJUERCB
ComponentBefore | C22 | C_0603_1608Metric | 100n / 50V X7R | PORABWAB | INIAKVWM
ComponentBefore | C23 | C_0603_1608Metric | 1u / 35V X7R | AMEBRHTV | ROFLCUKA
ComponentBefore | C24 | C_0603_1608Metric | 1u / 35V X7R | IGXEXKPS | OWVIUQXH
ComponentBefore | D1 | Kingbright_APT1608SURCK | RED | ZRFAWLMA | MASVTPTT
ComponentBefore | D2 | Kingbright_APT1608SURCK | RED | HVKLPLIO | XMYWDNGT
ComponentBefore | D3 | Kingbright_APT1608SURCK | RED | NDXIKLJU | PISHBPHS
ComponentBefore | D4 | Kingbright_APT1608SURCK | RED | FNBEEYRK | XGCGSJRP
ComponentBefore | D5 | Kingbright_APT1608SURCK | RED | EOYYSKMI | DCJUOYGC
ComponentBefore | D6 | Kingbright_APT1608SURCK | RED | EOLXAZZD | BQFITBGJ
ComponentBefore | D7 | Kingbright_APT1608SURCK | RED | CZZJRHIY | MQBGNRSH
ComponentBefore | D8 | Kingbright_APT1608SURCK | RED | JRTAZUPN | UIMCIJQH
ComponentBefore | D9 | Kingbright_APT1608SURCK | RED | RZLWLZTO | LHIQRMLU
ComponentBefore | D10 | Kingbright_APT1608SURCK | RED | QYHABMZI | XBPBPIHI
ComponentBefore | D11 | Kingbright_APT1608SURCK | RED | ZCSIDYNM | NEFABFAC
ComponentBefore | D12 | Kingbright_APT1608SURCK | RED | ALWFFNGE | FWQTWLIK
ComponentBefore | D13 | Kingbright_APT1608SURCK | RED | OPYFDJKJ | JAQBQMXT
ComponentBefore | D14 | Kingbright_APT1608SURCK | RED | PYBQNXXG | CBIQKVVO
ComponentBefore | D15 | Kingbright_APT1608SURCK | RED | EUZOVVYZ | RPGEHUAS
ComponentBefore | D16 | Kingbright_APT1608SURCK | RED | TJNRVIKD | JVSCONJO
ComponentBefore | D17 | Kingbright_APT1608SURCK | RED | MBENPWZG | DXSIQOXQ
ComponentBefore | D18 | Kingbright_APT1608SURCK | RED | ISXAHDGW | DISYATJN
ComponentBefore | D19 | Kingbright_APT1608SURCK | RED | QJGUHYOA | NCKLXDCJ
ComponentBefore | D20 | Kingbright_APT1608SURCK | RED | ZAHKWIUN | MRFDABQA
ComponentBefore | D21 | Kingbright_APT1608SURCK | RED | UMVDYPRJ | BWSERWRK
ComponentBefore | D22 | Kingbright_APT1608SURCK | RED | LVXTPGLK | DRQOKVFI
ComponentBefore | D23 | Kingbright_APT1608SURCK | RED | TQQFZPKE | SFWIXILD
ComponentBefore | D24 | Kingbright_APT1608SURCK | RED | KZPVKBTI | FPIFVAOC
ComponentBefore | D25 | Kingbright_APT1608SURCK | RED | LGLIMQMS | PNLBYPBJ
ComponentBefore | D26 | Kingbright_APT1608SURCK | RED | FUDXQGRQ | BAOOSNGD
ComponentBefore | D27 | Kingbright_APT1608SURCK | RED | KDDCULJG | UXCTIVTN
ComponentBefore | D28 | Kingbright_APT1608SURCK | RED | VPQYBOLC | LGCRMFBK
ComponentBefore | D29 | Kingbright_APT1608SURCK | RED | YMFHXWCY | VMAFBHYC
ComponentBefore | D30 | Kingbright_APT1608SURCK | RED | IEHHLEQG | AKGBITTW
ComponentBefore | D31 | Kingbright_APT1608SURCK | RED | BWYJUOTY | PIGAQTCP
ComponentBefore | D32 | Kingbright_APT1608SURCK | RED | OSFMJPAE | OVAEKBNY
ComponentBefore | D33 | Kingbright_APT1608SURCK | RED | JTIWPUVT | EFRHOXYQ
ComponentBefore | D34 | Kingbright_APT1608SURCK | RED | DWLNVMYN | KXVTNQSF
ComponentBefore | D35 | Kingbright_APT1608SURCK | RED | DMXIXQMY | FFBENJYP
ComponentBefore | D36 | Kingbright_APT1608SURCK | RED | CACOZTJU | MDPTNKYX
ComponentBefore | D37 | Kingbright_APT1608SURCK | RED | YACYIWMM | SDNUHNTF
ComponentBefore | D38 | Kingbright_APT1608SURCK | RED | ZFAENLOE | EMIRMRKX
ComponentBefore | D39 | Kingbright_APT1608SURCK | RED | YVRAAPLR | SBYXJKDK
ComponentBefore | D40 | Kingbright_APT1608SURCK | RED | ZNYTQYOE | NIMQXPYP
ComponentBefore | D41 | Kingbright_APT1608SURCK | RED | HTMOFOOB | MECINPLR
ComponentBefore | D42 | Kingbright_APT1608SURCK | RED | ZMVWEPWZ | LNTHJTUG
ComponentBefore | D43 | Kingbright_APT1608SURCK | RED | QAZALFQD | TYSIVXGC
ComponentBefore | D44 | Kingbright_APT1608SURCK | RED | IUOPIUGQ | WTDJJSDW
ComponentBefore | D45 | Kingbright_APT1608SURCK | RED | TTJUGCHO | SFVIQWLQ
ComponentBefore | D46 | Kingbright_APT1608SURCK | RED | IJFCVOAD | CAPESPDK
ComponentBefore | D47 | Kingbright_APT1608SURCK | RED | HOXKYLGW | KRUGRNBB
ComponentBefore | D48 | Kingbright_APT1608SURCK | RED | ECXNGQEF | WVFDKQNO
ComponentBefore | D49 | Kingbright_APT1608SURCK | RED | TMMYKWOP | MJLUKUBV
ComponentBefore | D50 | Kingbright_APT1608SURCK | RED | OADPHHML | RCXNBBEK
ComponentBefore | D51 | Kingbright_APT1608SURCK | RED | IVJULFRC | HPKJKAAO
ComponentBefore | D52 | Kingbright_APT1608SURCK | RED | QQRNIXRW | RKHFGLKS
ComponentBefore | D53 | Kingbright_APT1608SURCK | RED | VJJRYOZT | UQXEQPTE
ComponentBefore | D54 | Kingbright_APT1608SURCK | RED | YIDITJWT | QDGFXCFU
ComponentBefore | D55 | Kingbright_APT1608SURCK | RED | JOGKIVQJ | IKXQNBKQ
ComponentBefore | D56 | Kingbright_APT1608SURCK | RED | SEQWOQST | XEXLVKWB
ComponentBefore | D57 | Kingbright_APT1608SURCK | RED | ENISNVHA | NTMTKMVH
ComponentBefore | D58 | Kingbright_APT1608SURCK | RED | GYHRIYPE | QQXMRWVX
ComponentBefore | D59 | Kingbright_APT1608SURCK | RED | ZAOEXTEC | XKPULHWT
ComponentBefore | D60 | Kingbright_APT1608SURCK | RED | ATBJJQVZ | MHXWMUMF
ComponentBefore | D61 | Kingbright_APT1608SURCK | RED | KVFYNFNX | TLLOWWTY
ComponentBefore | D62 | Kingbright_APT1608SURCK | RED | TINNBWUO | CHRDJMWC
ComponentBefore | D63 | Kingbright_APT1608SURCK | RED | VWWTZHGC | MCJKAMRK
ComponentBefore | D64 | Kingbright_APT1608SURCK | RED | NAVAUQHF | ILNYJAWT
ComponentBefore | D65 | Kingbright_APT1608SURCK | RED | BZWIGETQ | FEIEYPYD
ComponentBefore | D66 | Kingbright_APT1608SURCK | RED | KKXIIQDW | HKCOGMFE
ComponentBefore | D67 | Kingbright_APT1608SURCK | RED | LYKJIOGZ | QYXPUVUP
ComponentBefore | D68 | Kingbright_APT1608SURCK | RED | QVGMCTQP | FLHJMXQT
ComponentBefore | D69 | Kingbright_APT1608SURCK | RED | FSDWXCDD | MDAYJFVW
ComponentBefore | D70 | Kingbright_APT1608SURCK | RED | SPIVJJWB | TVMKHBYE
ComponentBefore | D71 | Kingbright_APT1608SURCK | RED | PHOFELKD | CGOUQXLJ
ComponentBefore | D72 | Kingbright_APT1608SURCK | RED | QWPSSBKL | HFFAIHRN
ComponentBefore | D73 | Kingbright_APT1608SURCK | RED | SBOSBSOG | ICWQNBSL
ComponentBefore | D74 | Kingbright_APT1608SURCK | RED | HJSBWGVA | GFWVEEMC
ComponentBefore | D75 | Kingbright_APT1608SURCK | RED | HLENZPMX | FDGGAHLI
ComponentBefore | D76 | Kingbright_APT1608SURCK | RED | YDXXCZYA | LJWVVKLS
ComponentBefore | D77 | Kingbright_APT1608SURCK | RED | KFVDZXHP | JLTPYBPL
ComponentBefore | D78 | Kingbright_APT1608SURCK | RED | SXOMIYSD | ANXRTAMF
ComponentBefore | D79 | Kingbright_APT1608SURCK | RED | VKDRIYBT | UUGRLDVU
ComponentBefore | D80 | Kingbright_APT1608SURCK | RED | HNQVTFNW | PYUXCGUX
ComponentBefore | D81 | Kingbright_APT1608SURCK | RED | LRHIVLKU | IIBOIPQD
ComponentBefore | D82 | Kingbright_APT1608SURCK | RED | LQULVABL | HACCMROM
ComponentBefore | D83 | Kingbright_APT1608SURCK | RED | GDGOWBMC | VVQGUGOW
ComponentBefore | D84 | Kingbright_APT1608SURCK | RED | VQKAPTQF | PGXWVFUQ
ComponentBefore | D85 | Kingbright_APT1608SURCK | RED | UNYLZHFG | CJLMWJVW
ComponentBefore | D86 | Kingbright_APT1608SURCK | RED | PKVBGUWR | RXGECQRH
ComponentBefore | D87 | Kingbright_APT1608SURCK | RED | OAYNMSNB | NWQOCUGX
ComponentBefore | D88 | Kingbright_APT1608SURCK | RED | XHFNBTVM | QWDGDVFB
ComponentBefore | D89 | Kingbright_APT1608SURCK | RED | GHKYFAZO | IWJMPXOP
ComponentBefore | D90 | Kingbright_APT1608SURCK | RED | UBZHMNDK | QPDRLPCA
ComponentBefore | D91 | D_SOD-523 | TPD1E10B06 | ZPUKQNNU | LIPFANPS
ComponentBefore | J1 | CUI_UJC-HP-3-SMT-TR | UJC-HP-3-SMT-TR | HMRPJFRG | LOPDEMTD
ComponentBefore | R1 | R_0603_1608Metric | 5.1k 1% | KRARIHNB | YWQPSLPK
ComponentBefore | R2 | R_0603_1608Metric | 5.1k 1% | YUWUHCWW | CEHRLUHU
ComponentBefore | R10 | R_0603_1608Metric | 10k 1% | GHWECDCU | FACXEUIR
ComponentBefore | R11 | R_0603_1608Metric | 10k 1% | YHLGWSYB | JDQSJKAB
ComponentBefore | R12 | R_0603_1608Metric | 10k 1% | GDTEAVAV | GORVOMWR
ComponentBefore | R13 | R_0603_1608Metric | 10k 1% | ZMVDJLEH | QBTRPRGH
ComponentBefore | R14 | R_0603_1608Metric | 10k 1% | DTHDJSBP | FCQQASLW
ComponentBefore | R15 | R_0603_1608Metric | 10k 1% | UFKPAPDR | CAEXJXOO
ComponentBefore | R20 | R_0603_1608Metric | 2.2k 1% | KWUQKSAY | XEWAWSGX
ComponentBefore | R21 | R_0603_1608Metric | 2.2k 1% | DSSSJRXH | HBPQBNHQ
ComponentBefore | R22 | R_0603_1608Metric | 100k 1% | TSOOJSJD | LLDOXHOK
ComponentBefore | R23 | R_0603_1608Metric | 10k 1% | AXJZNGTR | JAMHBIGD
ComponentBefore | R24 | R_0603_1608Metric | 20k 1% | HAHXIQGN | TTMUKSMQ
ComponentBefore | SW1 | SW_SPST_SKQG_WithStem__HAND_SOLDER_NOPASTE | UP | CKVIUVGM | CDLNVNUY
ComponentBefore | SW2 | SW_SPST_SKQG_WithStem__HAND_SOLDER_NOPASTE | DOWN | GLJERXKH | FRWDLTMV
ComponentBefore | SW3 | SW_SPST_SKQG_WithStem__HAND_SOLDER_NOPASTE | LEFT | IOLGXEOR | VWOJLUYI
ComponentBefore | SW4 | SW_SPST_SKQG_WithStem__HAND_SOLDER_NOPASTE | RIGHT | VLTOFXOO | EEVPFHLX
ComponentBefore | SW5 | SW_SPST_SKQG_WithStem__HAND_SOLDER_NOPASTE | START | XPYACGDP | HXOFMJQW
ComponentBefore | U1 | LQFP-32_7x7mm_P0.8mm | STM32G030K8T6 | GYLMFYZW | TLKOJJVD
ComponentBefore | U2 | IS31FL3737_QFN40_5x5mm_P0.4mm_EP3.4mm | IS31FL3737-QFLS4-TR | UGKTIBJN | HJXRVMCO
ComponentBefore | U3 | SOT-23-5 | TLV75533PDBVR | RRVSKYJO | REHOPUYB
ComponentBefore | U4 | ST25TN01K_UFDFPN5_1.7x1.4mm | ST25TN01K-AFH5 | AOIRBZXS | BRTFIXAA
ComponentBefore | U5 | SOT-323_SC-70 | TPD2E2U06DCK | LKSJCEHV | OBFADPEK
ComponentBefore | C30 | C_0603_1608Metric__DNP_NOPASTE | DNP / C0G TUNE | GEOMNDKI | YLTVOUSX
ComponentBefore | L1 | NFC_PRINTED_COIL_8T_UNTUNED | NFC_PRINTED_COIL_8T_UNTUNED | KVXYUQSH | RTVTHECU
ComponentBefore | TP1 | TestPoint_Pad_D1.0mm | VBUS_5V | SLPMXKUF | STCOPCKL
ComponentBefore | TP2 | TestPoint_Pad_D1.0mm | +3V3 | QQILYRDD | FOWAFTPO
ComponentBefore | TP3 | TestPoint_Pad_D1.0mm | GND | XWFJFZMK | SWWXNTWO
ComponentBefore | TP4 | TestPoint_Pad_D1.0mm | +3V3 | NPXTSNUP | SCJGLMOH
ComponentBefore | TP5 | TestPoint_Pad_D1.0mm | GND | ZYNMJEOQ | WGQTRFNI
ComponentBefore | TP6 | TestPoint_Pad_D1.0mm | SWDIO | SWNNWGHF | LYICHPLY
ComponentBefore | TP7 | TestPoint_Pad_D1.0mm | SWCLK | VTTQCXTT | NSIDDYLN
ComponentBefore | TP8 | TestPoint_Pad_D1.0mm | NRST | GOQVGTHS | RWVNHNFF
SilkAfter | REV C / AX-01 | 34 | 50964568 | 1030864 | 1
SilkAfter | CLK | 33 | 55708661 | 2972441 | 0
SilkAfter | DIO | 34 | 54842520 | 5590551 | 1
Errors | 0
NoAutomaticSave | True
