alex1324575/snake-pcb-business-card/verification/altium/PublicNativeBoardQR.png

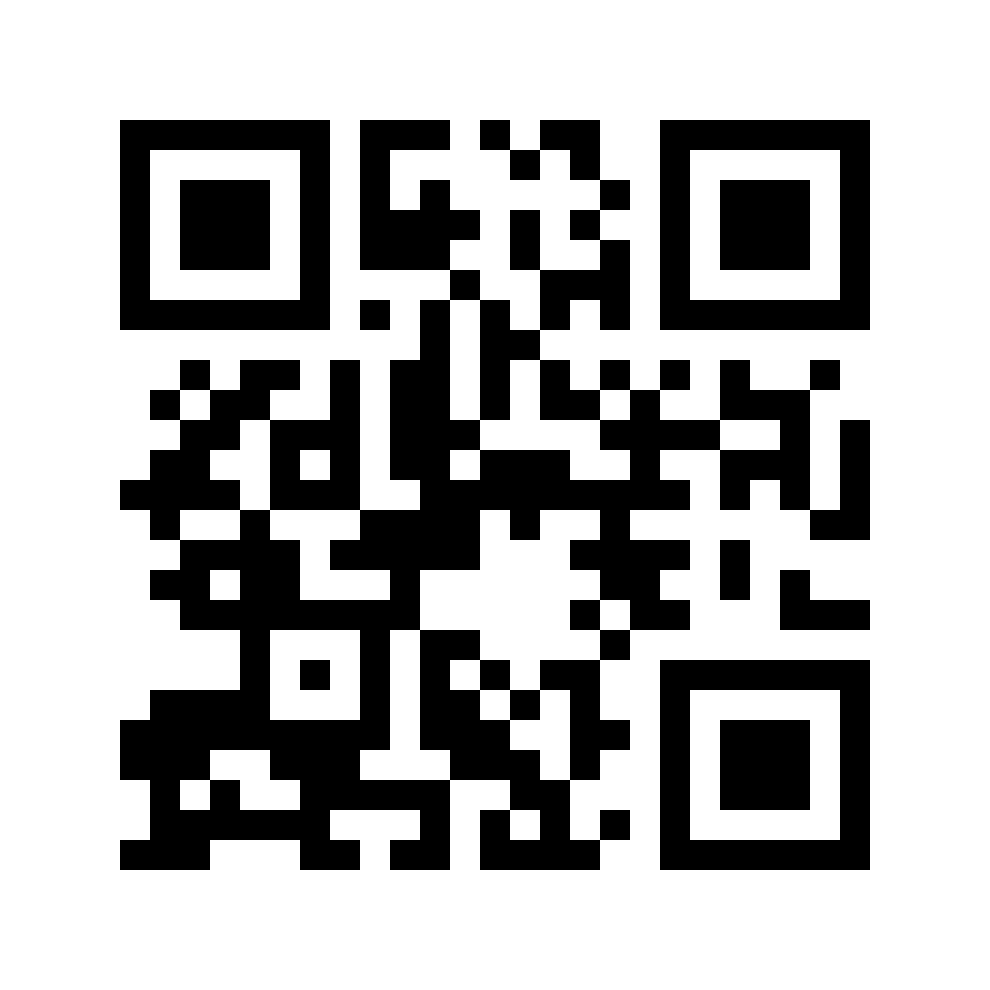
verification/altium/PublicNativeBoardQR.png
