alex1324575/snake-pcb-business-card/verification/altium/PublicNativeLibraryQR.png

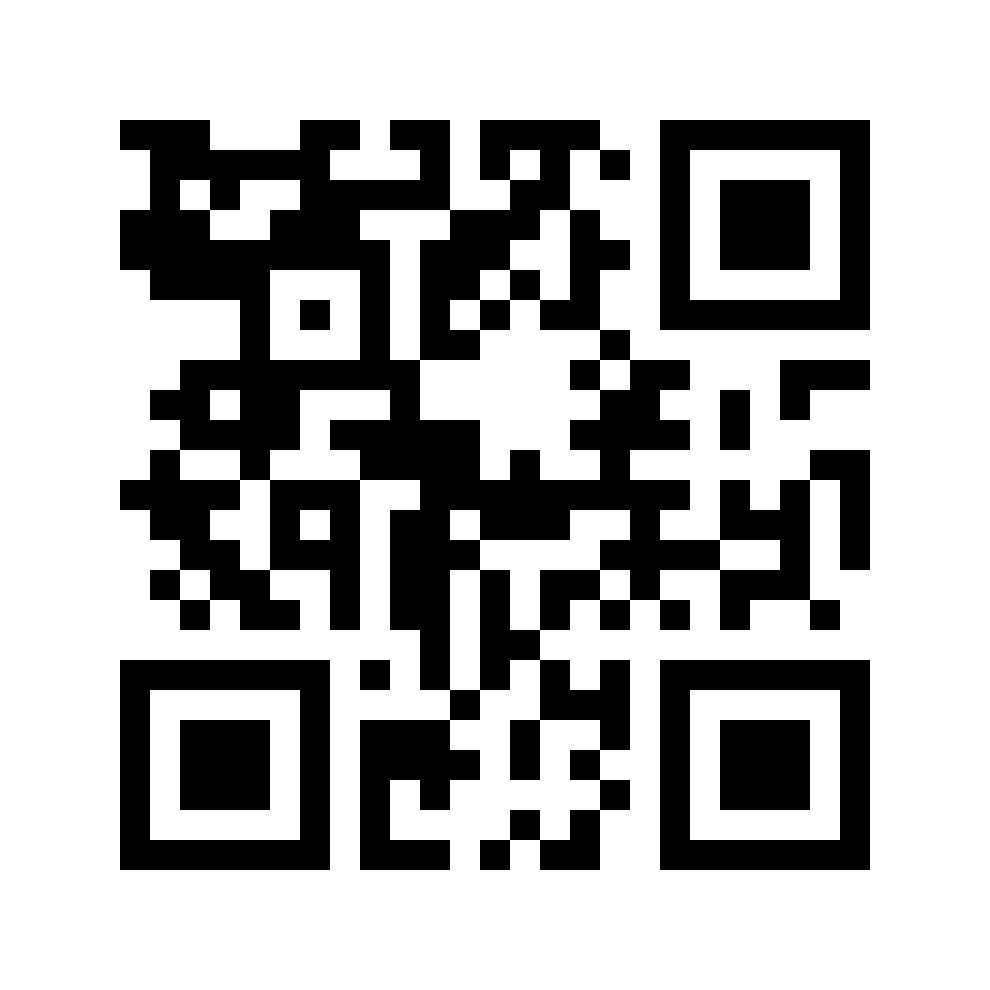
verification/altium/PublicNativeLibraryQR.png
