alex1324575/snake-pcb-business-card/exports/SnakeCard_RevC_Schematic.pdf

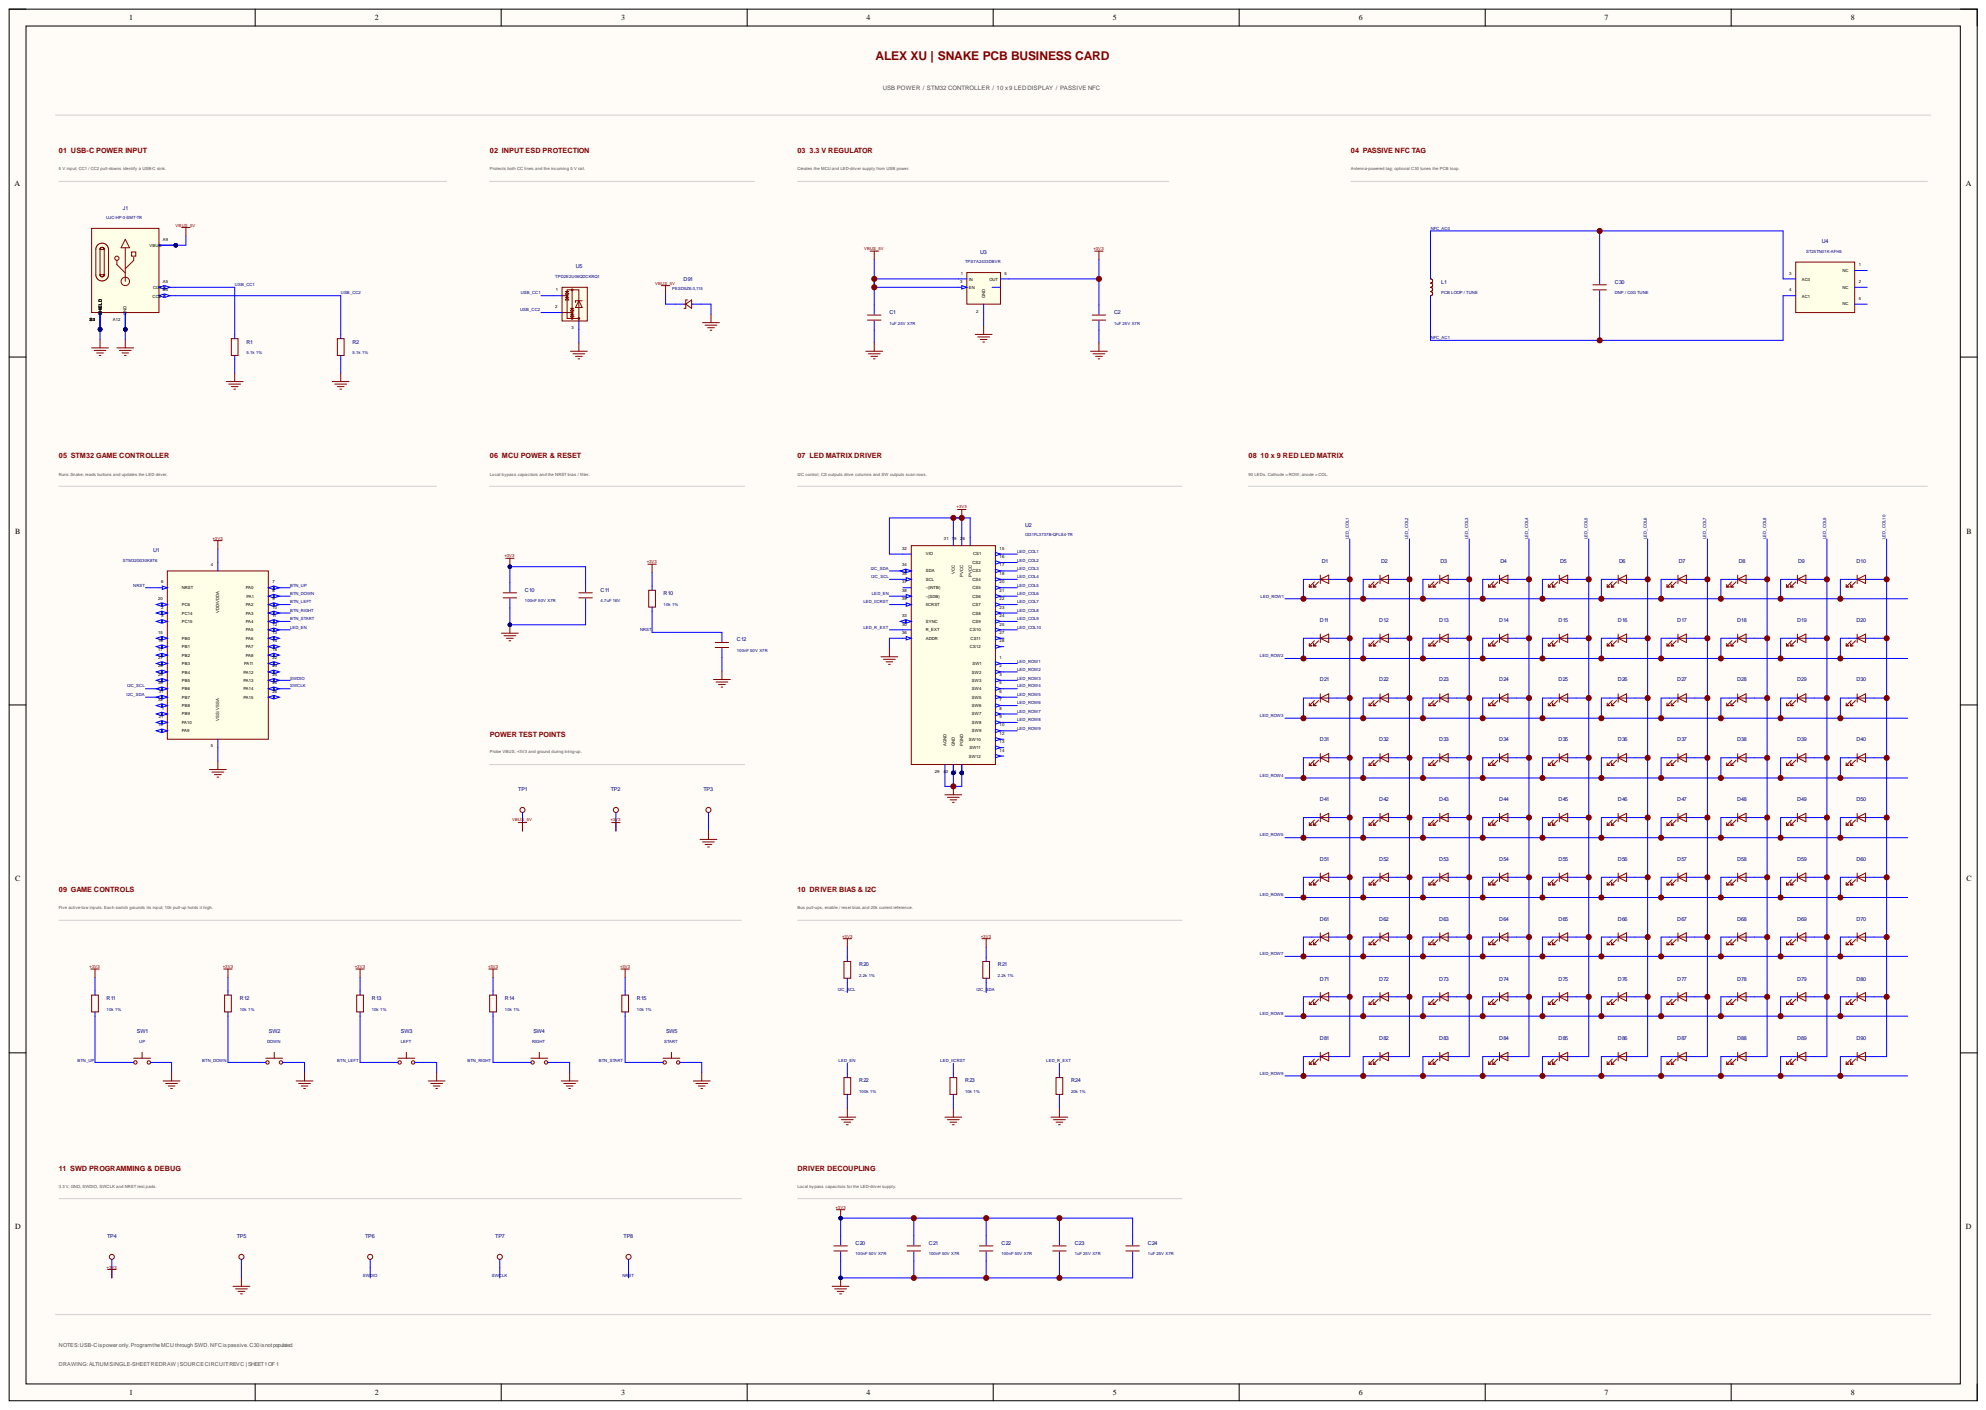
[picture p17: page 1]

ALEX XU | SNAKE PCB BUSINESS CARD

USB POWER / STM32 CONTROLLER / 10 x 9 LED DISPLAY / PASSIVE NFC

5 V input; CC1 / CC2 pull-downs identify a USB-C sink.

Protects both CC lines and the incoming 5 V rail.

Creates the MCU and LED-driver supply from USB power.

Antenna-powered tag; optional C30 tunes the PCB loop.

UJC-HP-3-SMT-TR

Runs Snake; reads buttons and updates the LED driver.

Local bypass capacitors and the NRST bias / filter.

I2C control; CS outputs drive columns and SW outputs scan rows.

90 LEDs. Cathode = ROW; anode = COL.

Probe VBUS, +3V3 and ground during bring-up.

Five active-low inputs. Each switch grounds its input; 10k pull-up holds it high.

Bus pull-ups, enable / reset bias and 20k current reference.

3.3 V, GND, SWDIO, SWCLK and NRST test pads.

Local bypass capacitors for the LED-driver supply.

NOTES:USB-Cispower only.Programthe MCU through SWD. NFC is passive.C30 is not populated.

DRAWING:ALTIUM SINGLE-SHEETREDRAW | SOURCE CIRCUIT: REV C | SHEET1 OF 1
