alex1324575/snake-pcb-business-card/exports/SnakeBusinessCard_Schematic.pdf

1 | 2 | 3 | 4 | 5 | 6 | 7 | 8

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
Size: A3 | Rev: B-PUBLIC | F Date: 2026-09-15
KiCad E.D.A. 10.0.6 | Id: 1/6

# Title: System overview and implementation notes

## File: SnakeBusinessCard.kicad_sch

## Sheet: /

## Snake Interactive PCB Business Card

## USB-C 5V | 10x9 red LED | passive NFC

## Public reference design - hardware validation pending

## 01 Power USB

File: 01_Power_USB.kicad_sch | 02 MCU Inputs Debug
File: 02_MCU_Inputs_Debug.kicad_sch | 03 LED Driver File: 03_LED_Driver.kicad_sch 04 LED Matrix

File: 04_LED_Matrix.kicad_sch 05 NFC

# File: 05_NFC.kicad_sch SNAKE / INTERACTIVE PCB CARD

## Rev B-PUBLIC | 85.6 x 54 mm | USB-C powered | 10 x 9 red LEDs

5 V input / CC resistors ESD / LDO / power test pads | MCU / 4-way + START SWD / reset / decoupling

## I2C address 0x50

10 CS sources / 9 SW scans D1-D90, row-major order Anode = COL / cathode = ROW

# INTERCONNECTS

+3V3 and GND: power, MCU and driver
I2C_SCL / I2C_SDA / LED_EN: MCU to driver LED_COL1..10 / LED_ROW1..9: driver to array NFC_AC0 / NFC_AC1: isolated passive RF circuit ST25TN01K-AFH5 No USB / MCU power connection BUILD NOTES

USB supplies power only. Program through SWD with target powered by USB. Driver firmware: R_EXT = 20k, GCC = 0x20 (32); unused channels off. NFC L1 is a printed loop; the routed antenna still requires measured tuning. C30 is DNP initially. No battery, charger, USB data or USB-PD negotiation. QR and appearance belong to PCB artwork. All circuits are native editable KiCad symbols and wires. Engineering checks accompany exports.

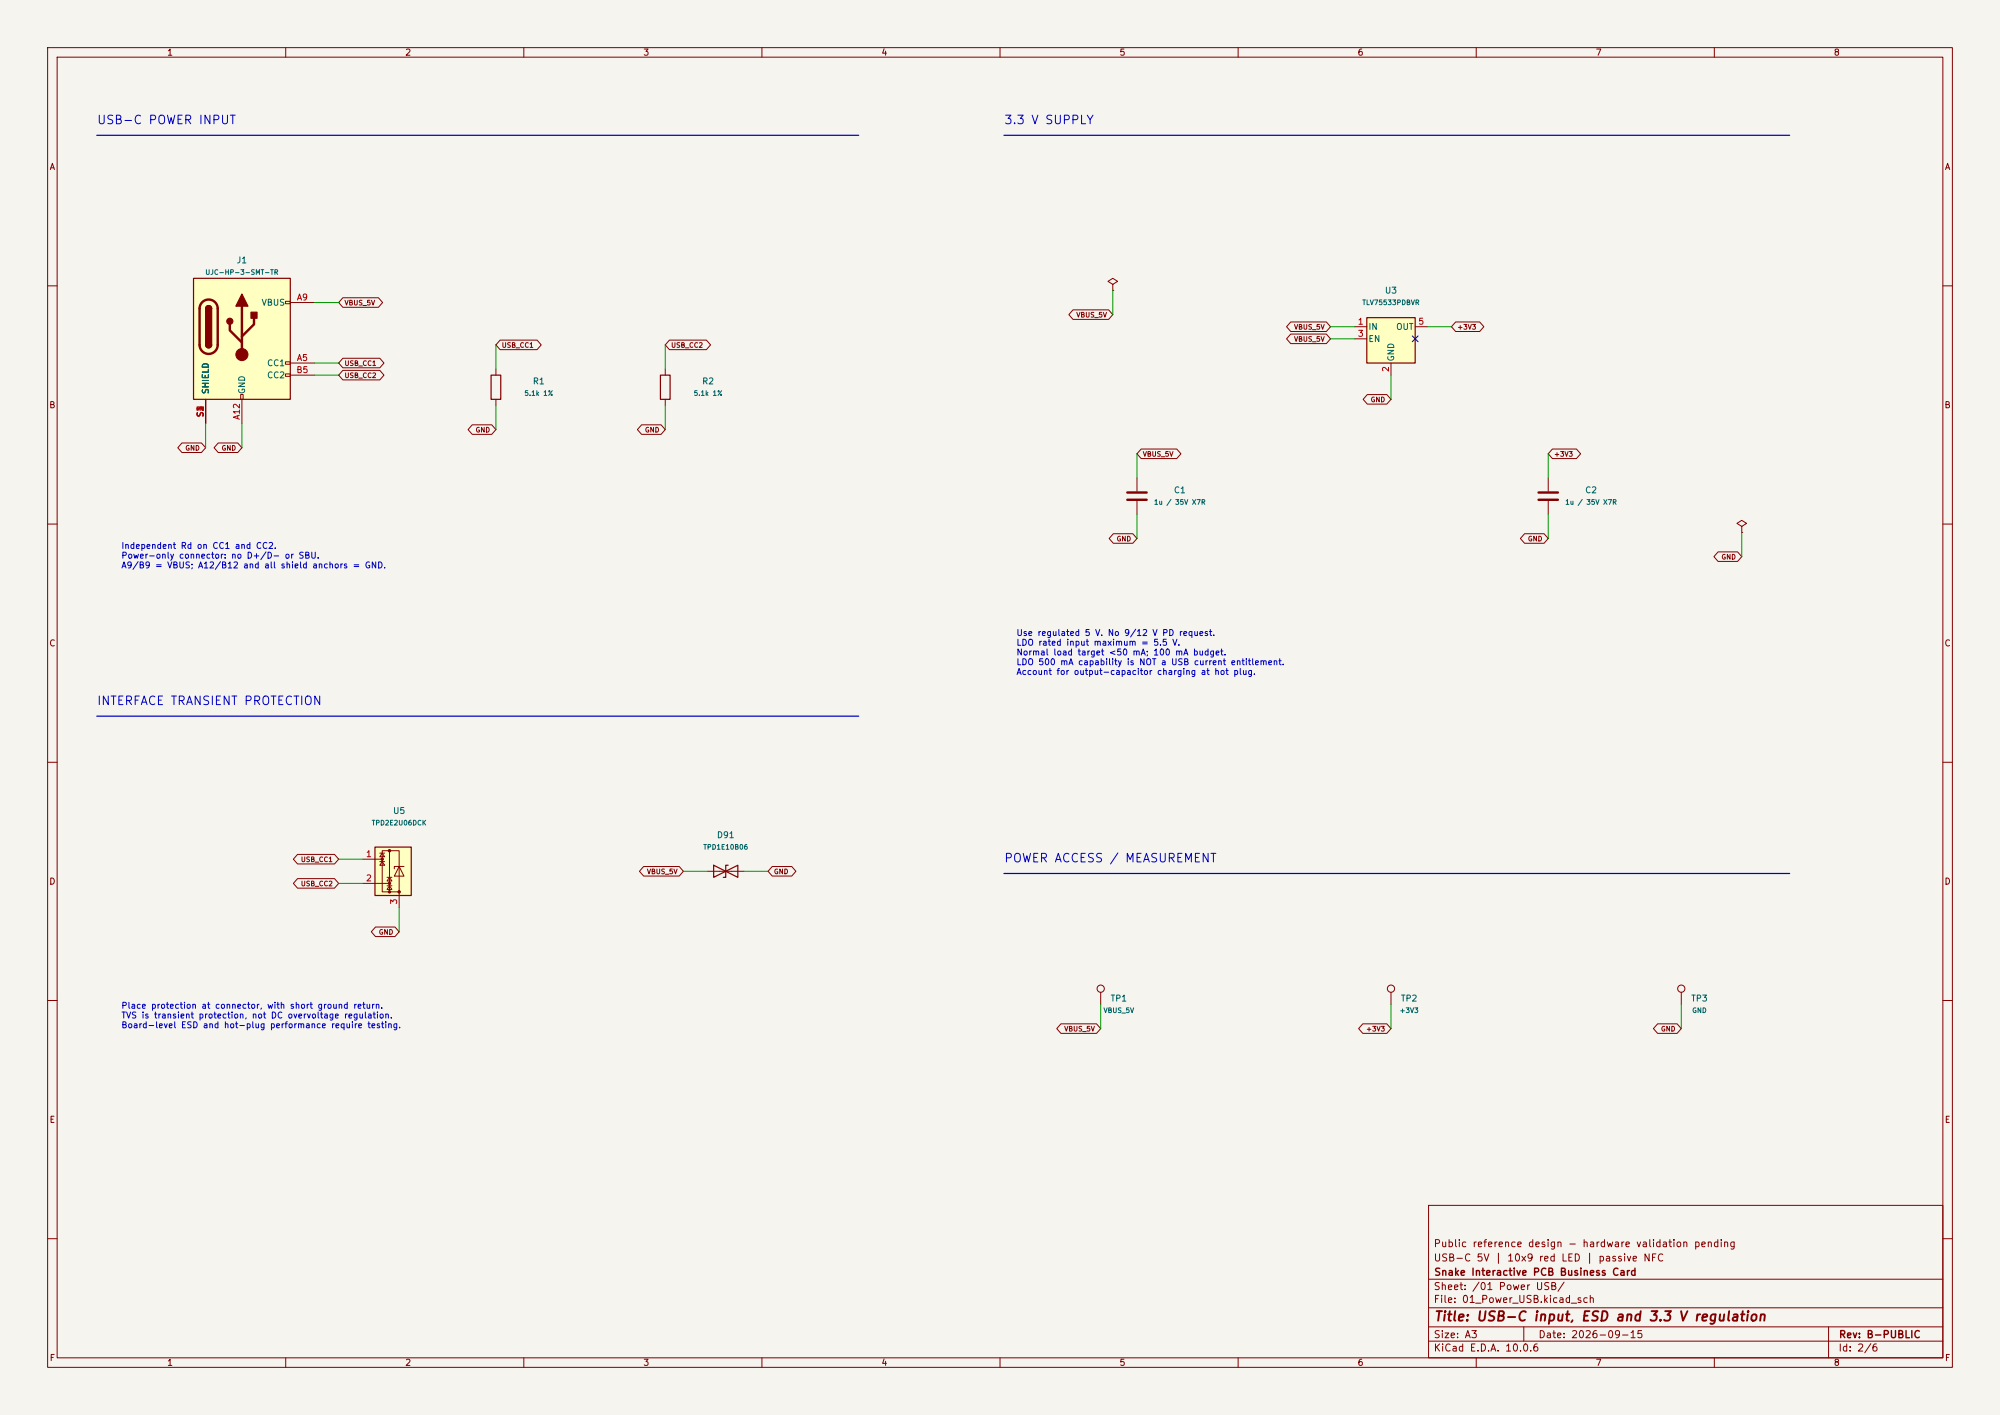
[picture p18: page 2]

Independent Rd on CC1 and CC2. Power-only connector: no D+/D- or SBU. A9/B9 = VBUS; A12/B12 and all shield anchors = GND. INTERFACE TRANSIENT PROTECTION

Use regulated 5 V. No 9/12 V PD request. LDO rated input maximum = 5.5 V. Normal load target <50 mA; 100 mA budget. LDO 500 mA capability is NOT a USB current entitlement. Account for output-capacitor charging at hot plug. Place protection at connector, with short ground return. TVS is transient protection, not DC overvoltage regulation. Board-level ESD and hot-plug performance require testing.

Public reference design - hardware validation pending
USB-C 5V | 10x9 red LED | passive NFC
Snake Interactive PCB Business Card
Sheet: /01 Power USB/
File: 01_Power_USB.kicad_sch
Title: USB-C input, ESD and 3.3 V regulation

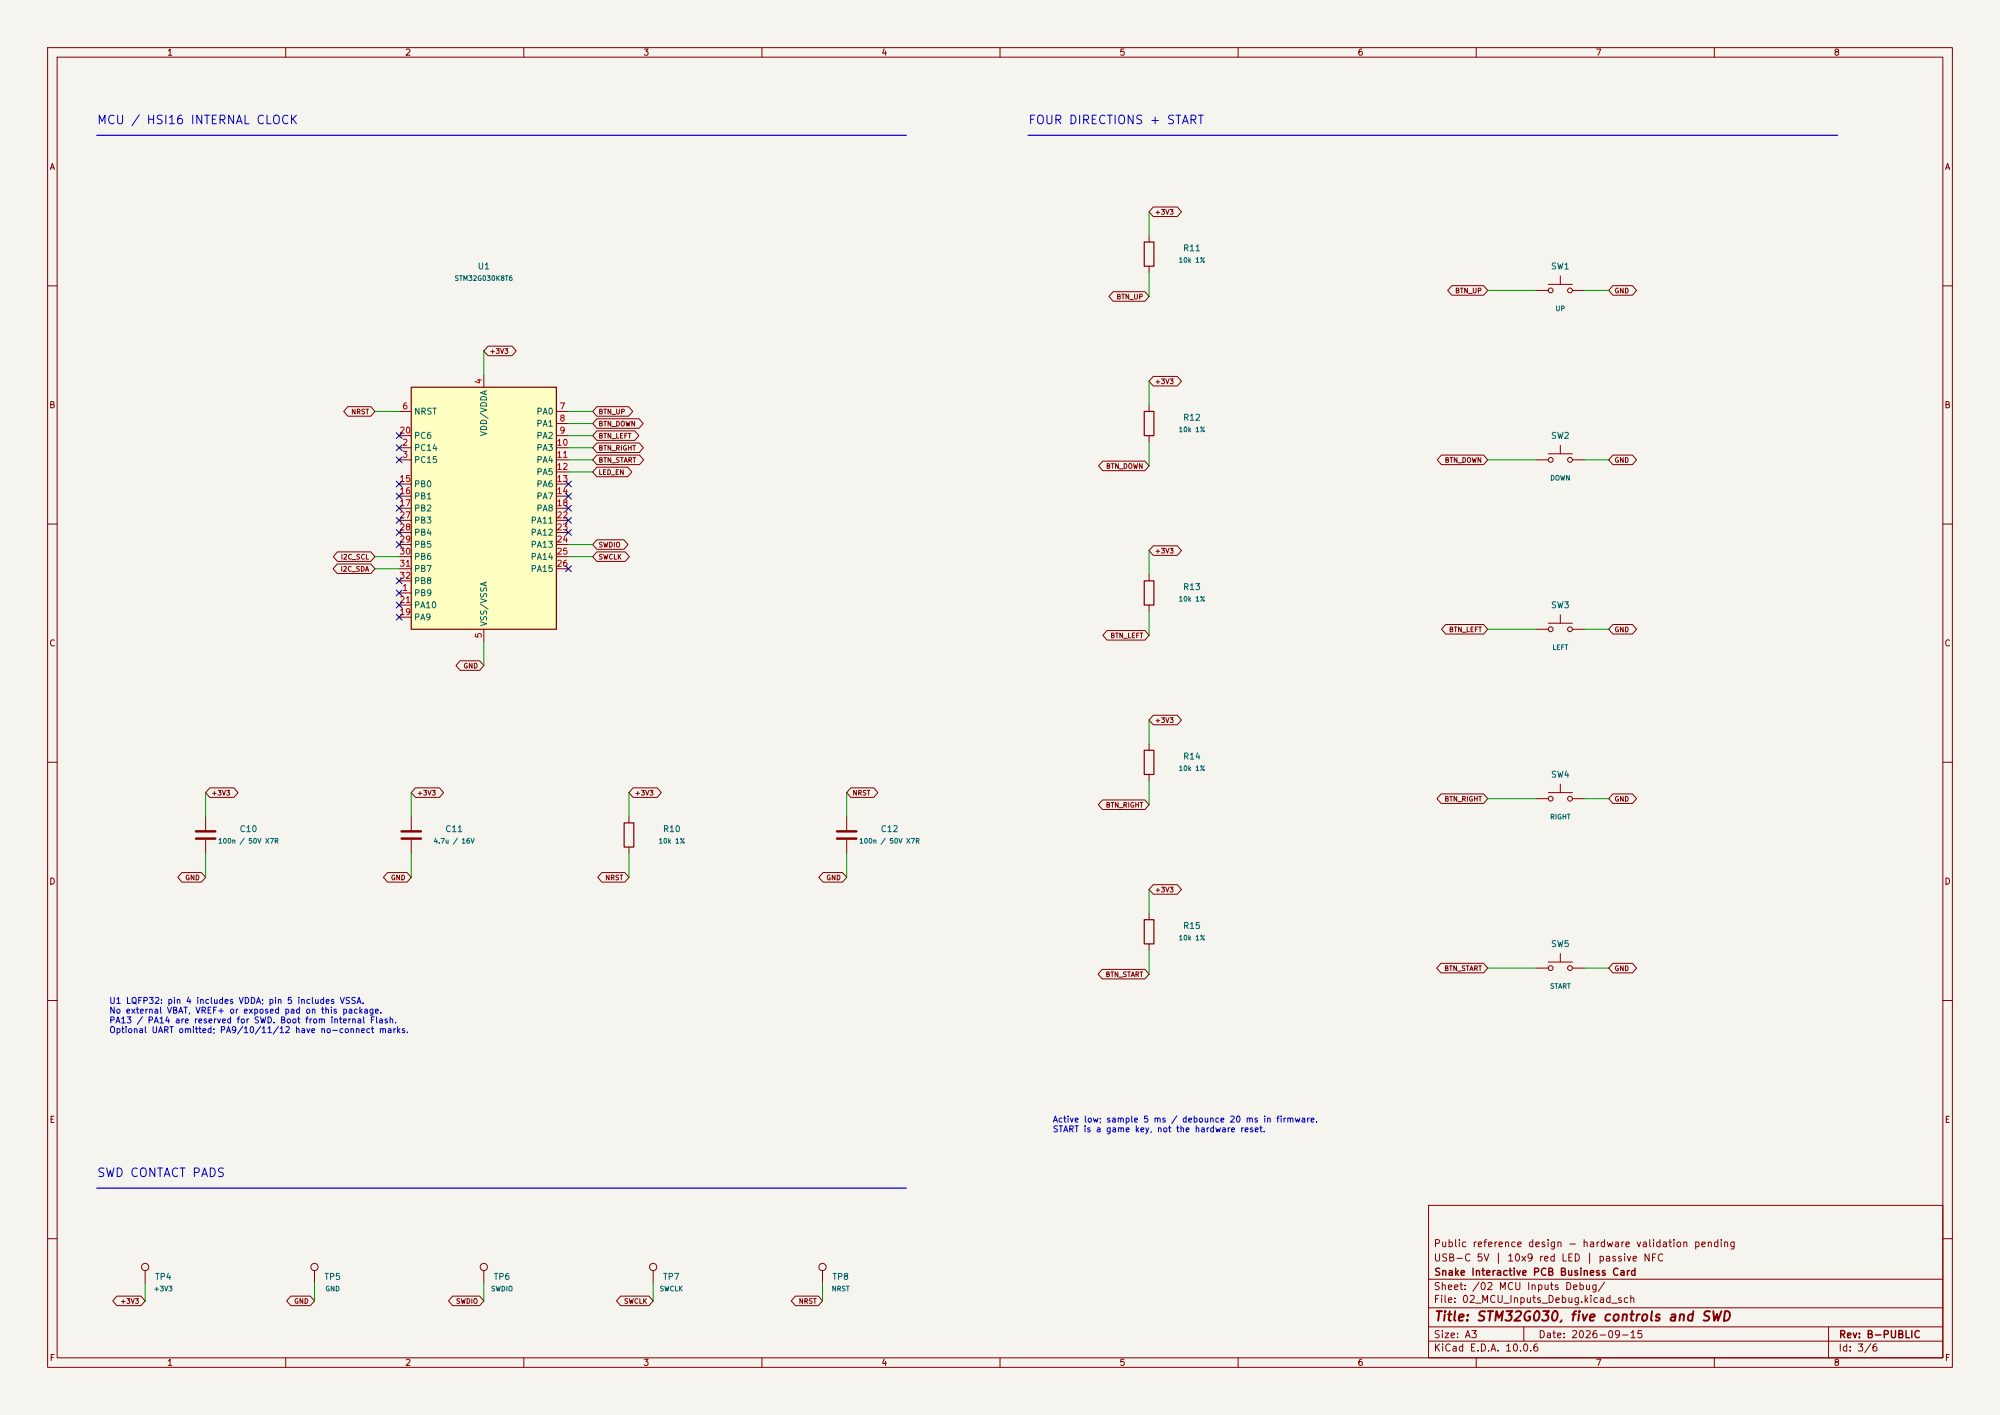
[picture p19: page 3]

Public reference design - hardware validation pending
USB-C 5V | 10x9 red LED | passive NFC
Snake Interactive PCB Business Card
Sheet: /02 MCU Inputs Debug/
File: 02_MCU_Inputs_Debug.kicad_sch
Title: STM32G030, five controls and SWD

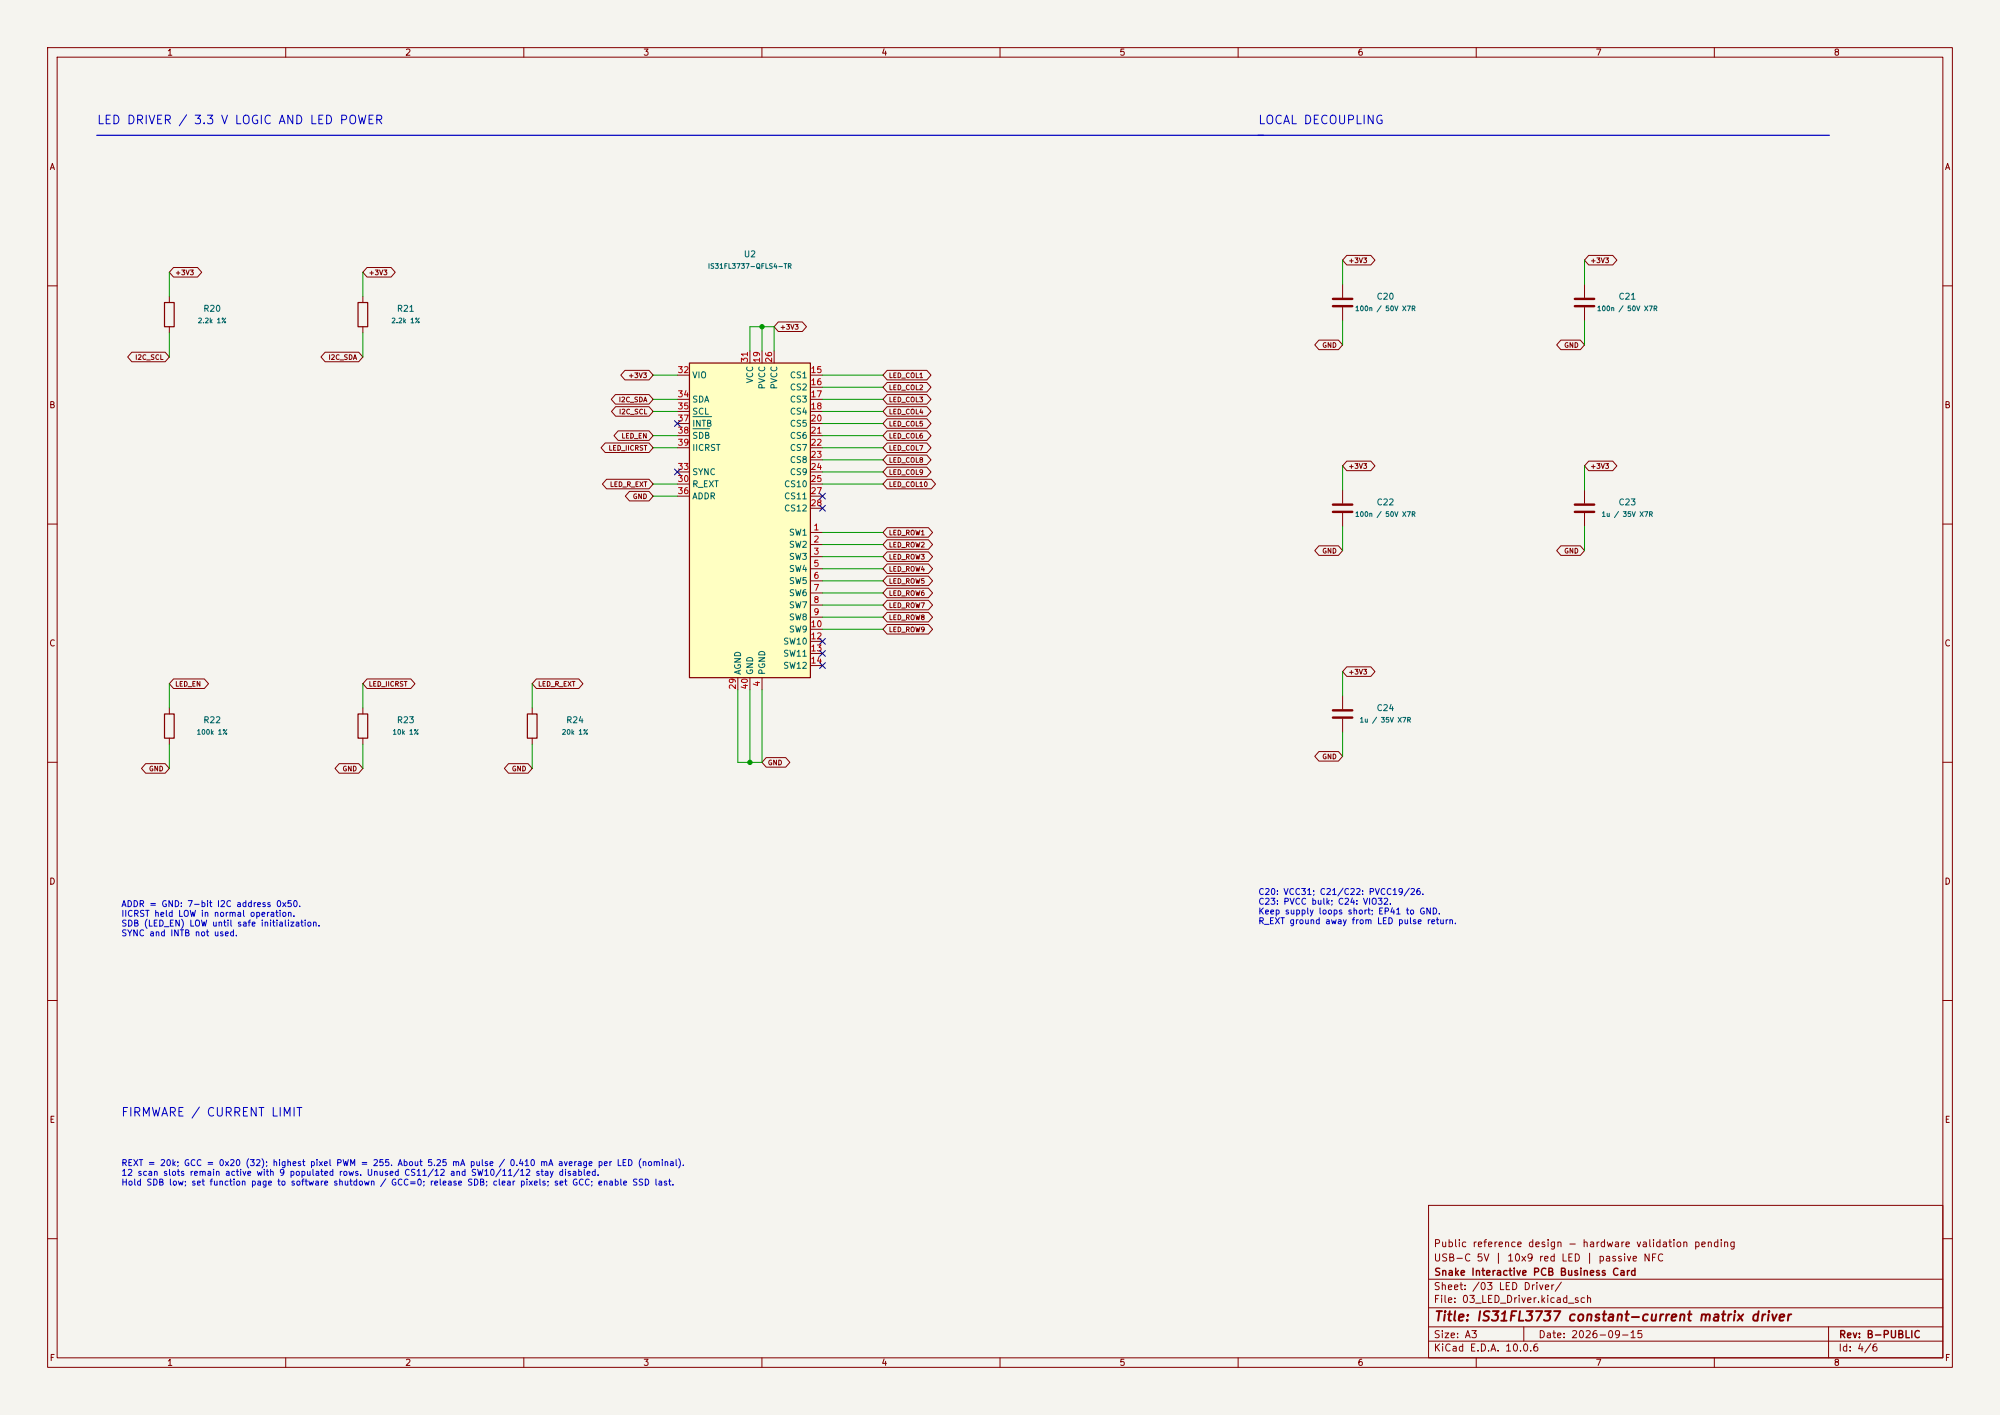
[picture p20: page 4]

LED DRIVER / 3.3 V LOGIC AND LED POWER

C20: VCC31; C21/C22: PVCC19/26. C23: PVCC bulk; C24: VIO32. Keep supply loops short; EP41 to GND. R_EXT ground away from LED pulse return. REXT = 20k; GCC = 0x20 (32); highest pixel PWM = 255. About 5.25 mA pulse / 0.410 mA average per LED (nominal). 12 scan slots remain active with 9 populated rows. Unused CS11/12 and SW10/11/12 stay disabled. Hold SDB low; set function page to software shutdown / GCC=0; release SDB; clear pixels; set GCC; enable SSD last. ADDR = GND: 7-bit I2C address 0x50.

IICRST held LOW in normal operation. SDB (LED_EN) LOW until safe initialization. SYNC and INTB not used. FIRMWARE / CURRENT LIMIT

Public reference design - hardware validation pending
USB-C 5V | 10x9 red LED | passive NFC
Snake Interactive PCB Business Card
Sheet: /03 LED Driver/
File: 03_LED_Driver.kicad_sch
Title: IS31FL3737 constant-current matrix driver

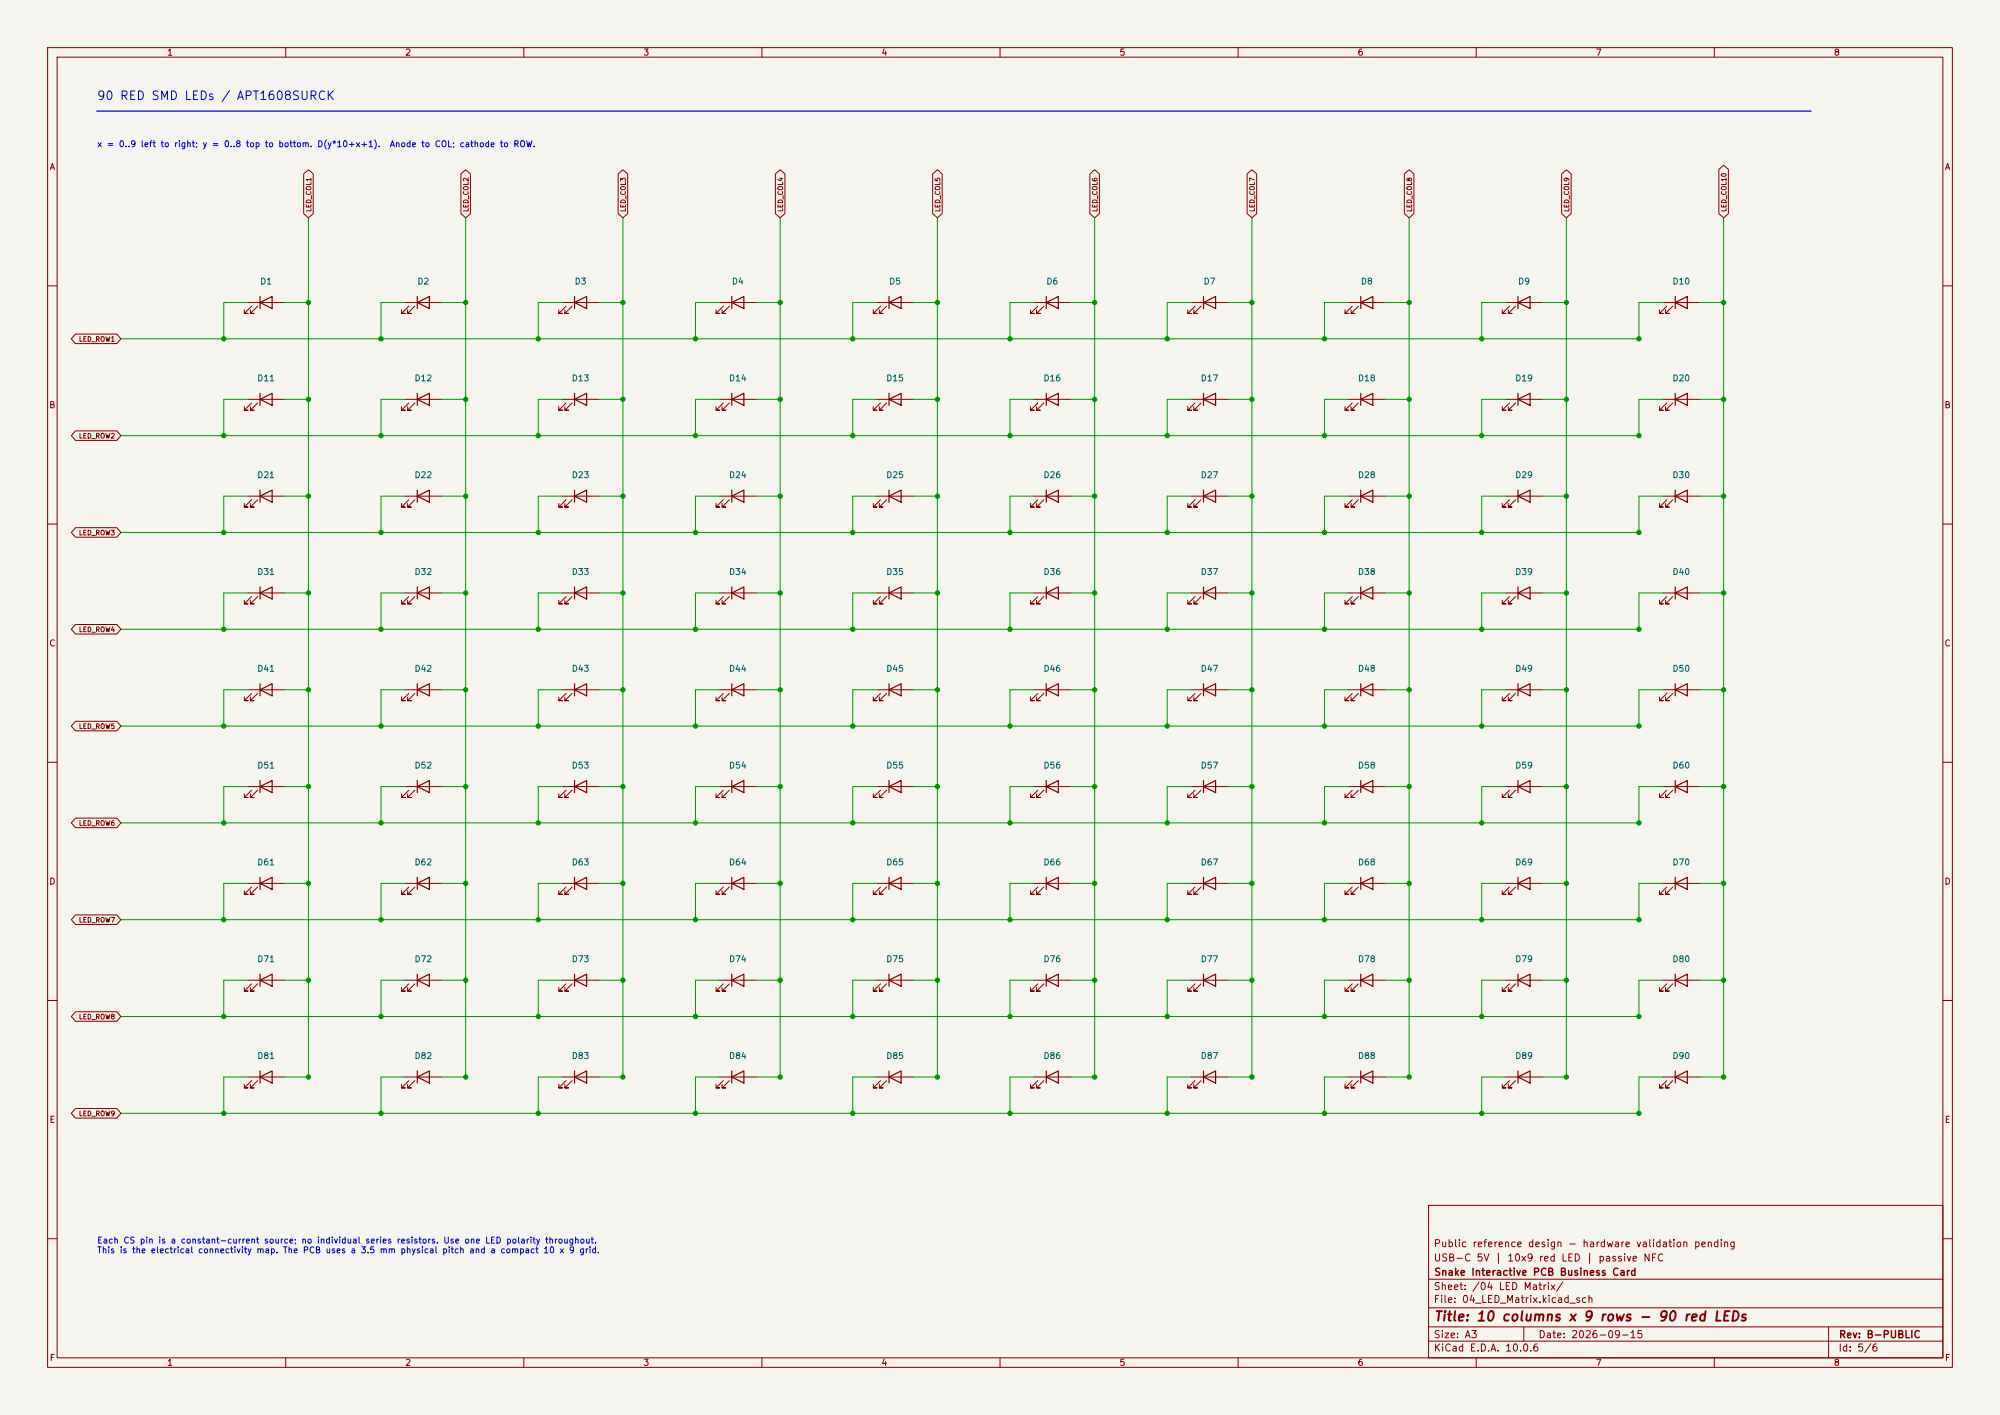
[picture p21: page 5]

LED_ROW7 Each CS pin is a constant-current source; no individual series resistors. Use one LED polarity throughout. This is the electrical connectivity map. The PCB uses a 3.5 mm physical pitch and a compact 10 x 9 grid.

Public reference design - hardware validation pending
USB-C 5V | 10x9 red LED | passive NFC
Snake Interactive PCB Business Card
Sheet: /04 LED Matrix/
File: 04_LED_Matrix.kicad_sch
Title: 10 columns x 9 rows - 90 red LEDs

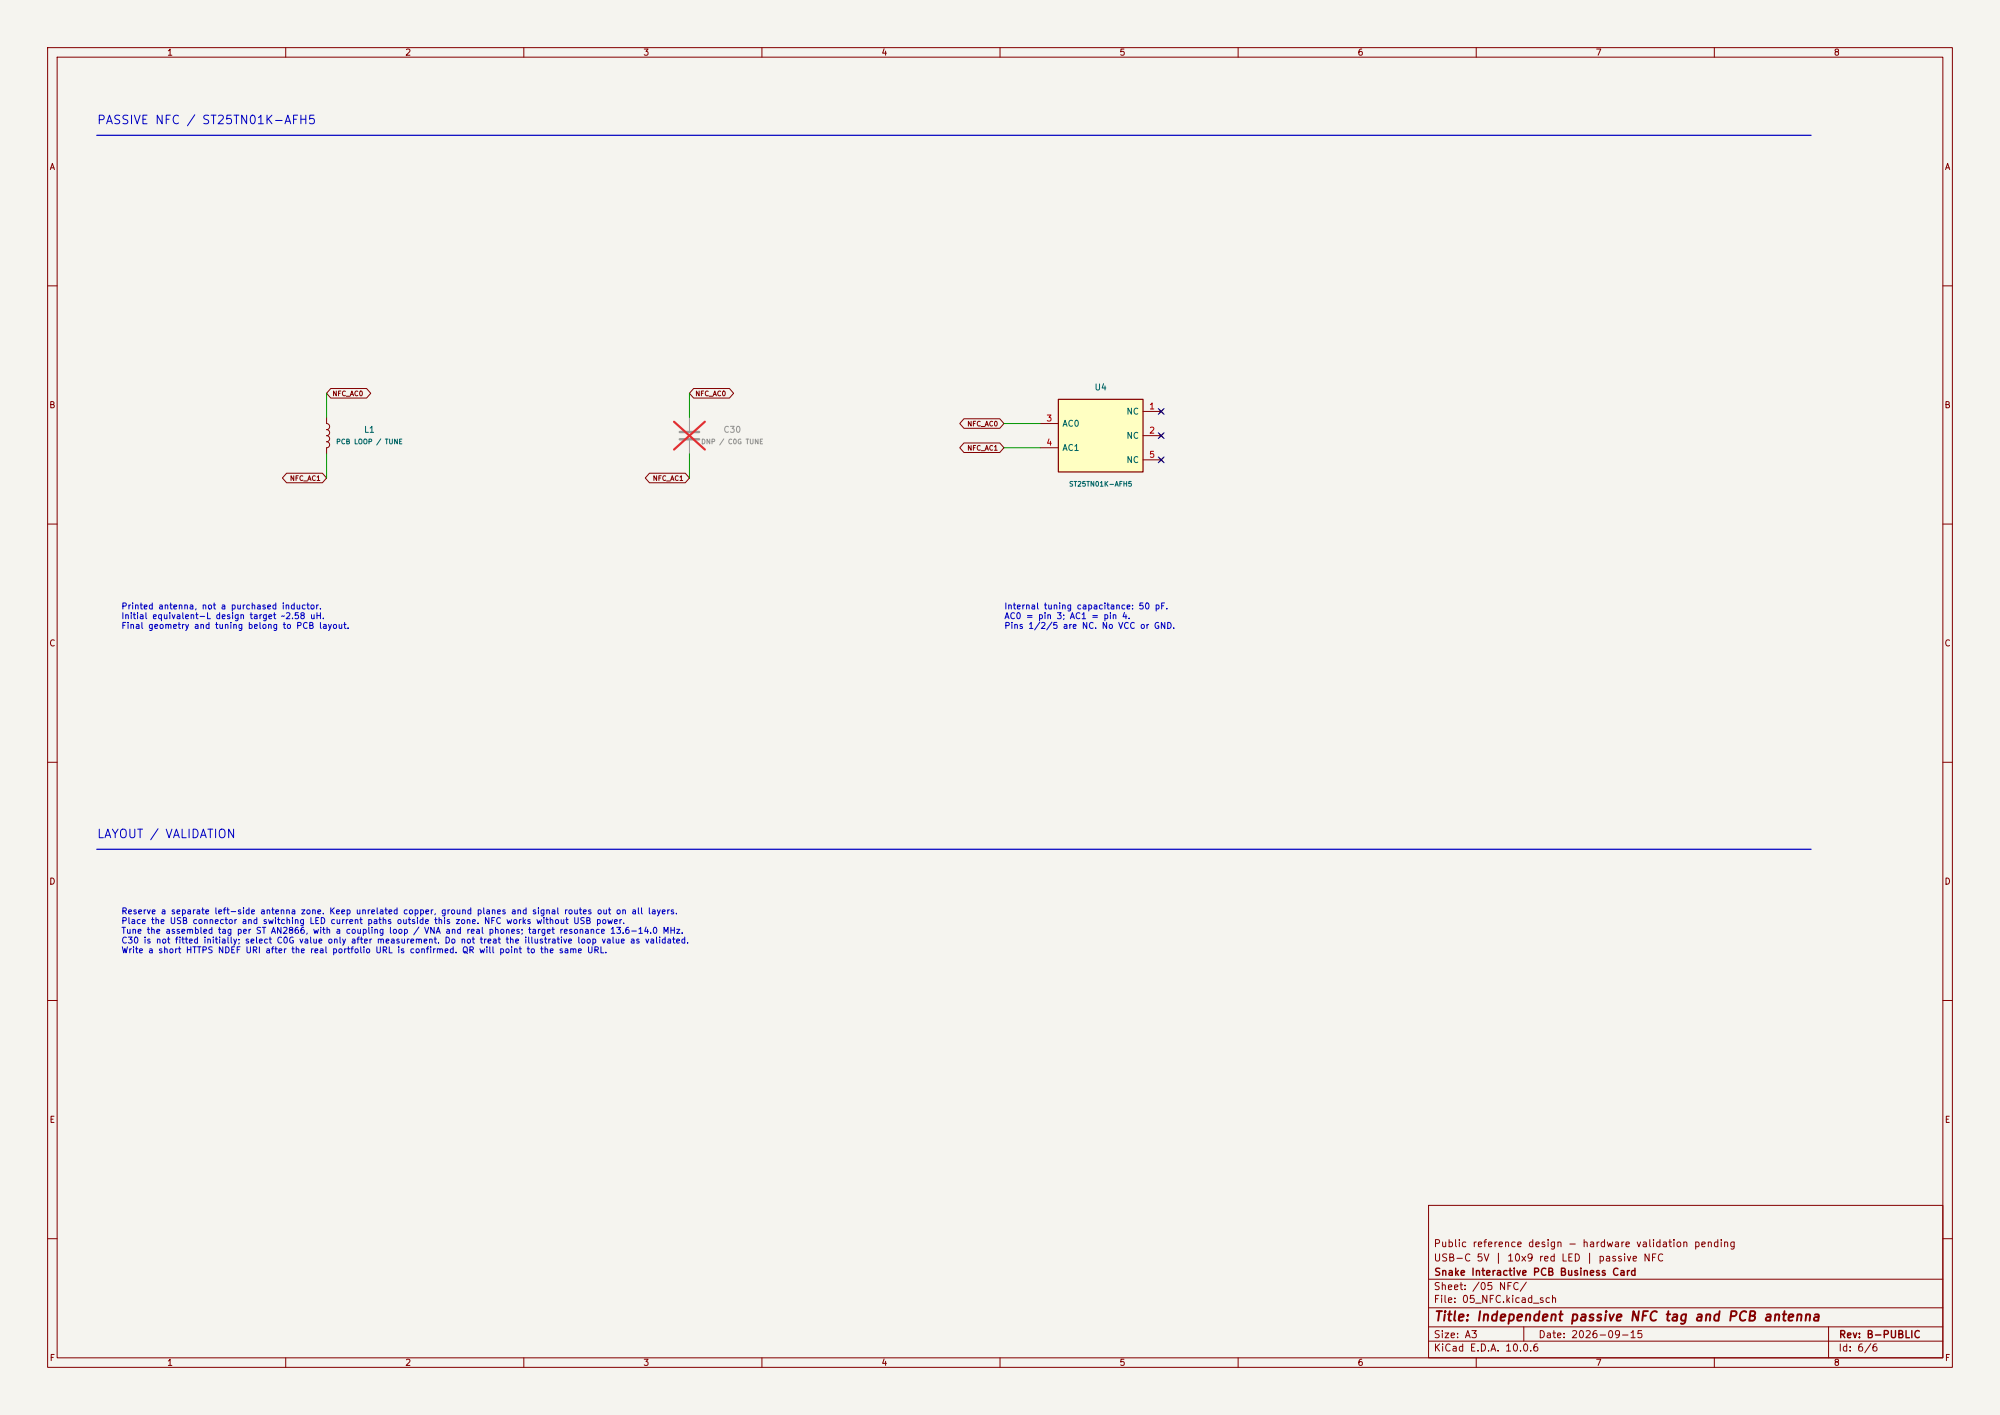
[picture p22: page 6]

Printed antenna, not a purchased inductor.
Initial equivalent-L design target ~2.58 uH. Final geometry and tuning belong to PCB layout.

Internal tuning capacitance: 50 pF. AC0 = pin 3; AC1 = pin 4. Pins 1/2/5 are NC. No VCC or GND. Reserve a separate left-side antenna zone. Keep unrelated copper, ground planes and signal routes out on all layers. Place the USB connector and switching LED current paths outside this zone. NFC works without USB power. Tune the assembled tag per ST AN2866, with a coupling loop / VNA and real phones; target resonance 13.6-14.0 MHz. C30 is not fitted initially; select C0G value only after measurement. Do not treat the illustrative loop value as validated. Write a short HTTPS NDEF URI after the real portfolio URL is confirmed. QR will point to the same URL.

Public reference design - hardware validation pending
USB-C 5V | 10x9 red LED | passive NFC
Snake Interactive PCB Business Card
Sheet: /05 NFC/
File: 05_NFC.kicad_sch
Title: Independent passive NFC tag and PCB antenna
