alex1324575/snake-pcb-business-card/(list of files, drawings)

Other design files:
altium/SnakeCard_Native.PcbDoc
altium/SnakeCard_Native.PrjPcb
altium/SnakeCard_Native.SchDoc
altium/SnakeCard_RevC.PrjPcb
altium/SnakeCardNative.PcbLib
altium/SnakeCardNative.SchLib
verification/hardware/pcb_drc.json
verification/hardware/schematic_annotation_audit.json
verification/revc/PCB_METADATA_AUDIT.json
verification/revc/SCHEMATIC_PDF_REVIEW.json
