alex1324575/snake-pcb-business-card/SnakeBusinessCard.kicad_pcb

## KiCad design SnakeBusinessCard.kicad_pcb (2026-10-12)

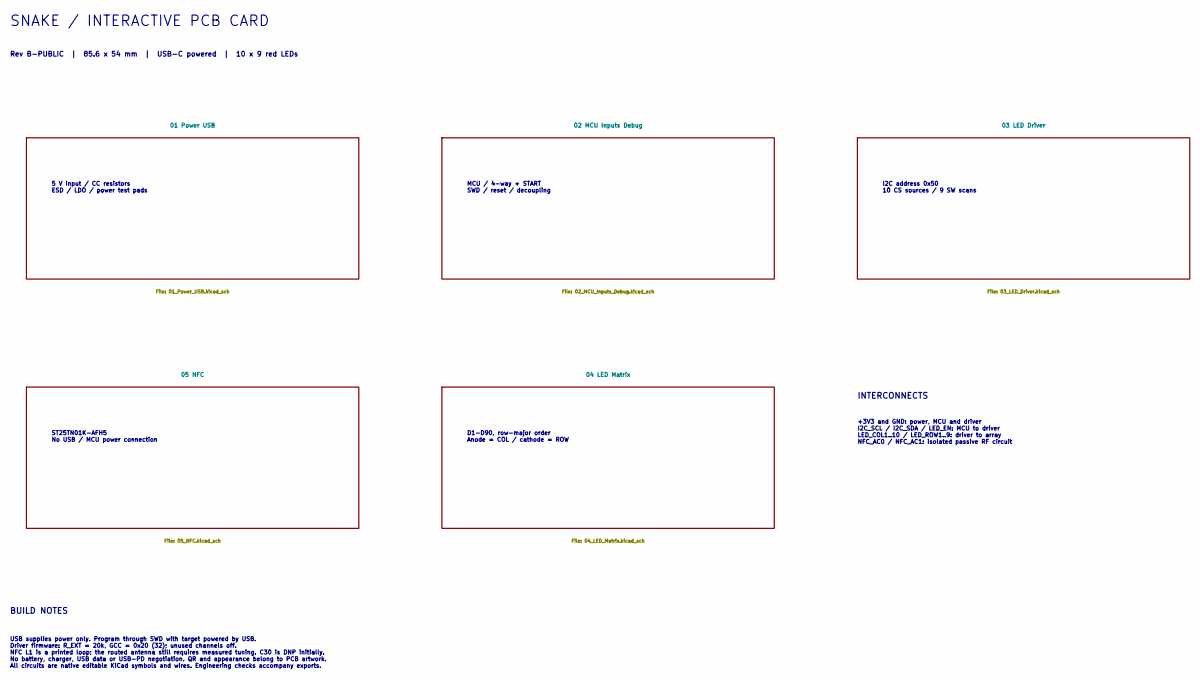
[picture p23: schematic SnakeBusinessCard.kicad_sch, System overview and implementation notes]

Notes on the sheet:
SNAKE / INTERACTIVE PCB CARD
Rev B-PUBLIC | 85.6 x 54 mm | USB-C powered | 10 x 9 red LEDs
5 V input / CC resistors ESD / LDO / power test pads
MCU / 4-way + START SWD / reset / decoupling
I2C address 0x50 10 CS sources / 9 SW scans
D1-D90, row-major order Anode = COL / cathode = ROW
ST25TN01K-AFH5 No USB / MCU power connection
INTERCONNECTS
+3V3 and GND: power, MCU and driver I2C_SCL / I2C_SDA / LED_EN: MCU to driver LED_COL1..10 / LED_ROW1..9: driver to array NFC_AC0 / NFC_AC1: isolated passive RF circuit
BUILD NOTES
USB supplies power only. Program through SWD with target powered by USB. Driver firmware: R_EXT = 20k, GCC = 0x20 (32); unused channels off. NFC L1 is a printed loop; the routed antenna still requires measured tuning. C30 is DNP initially. No battery, charger, USB data or USB-PD negotiation. QR and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

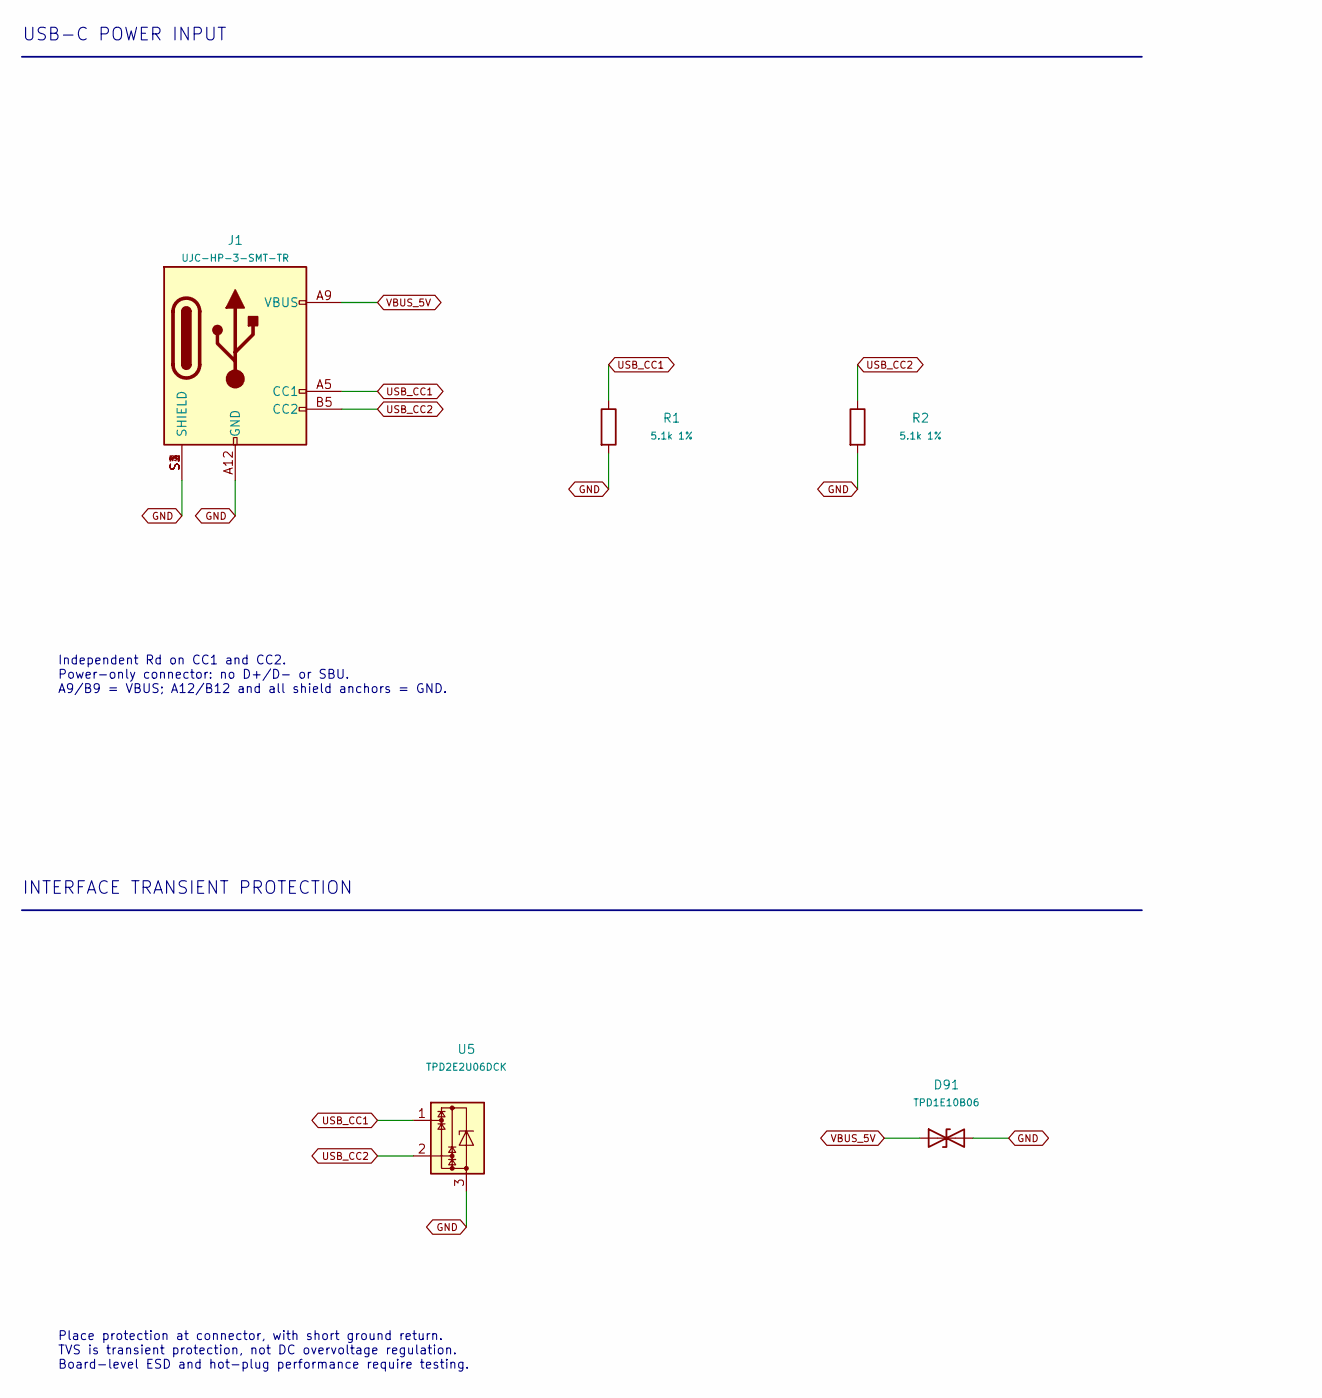
[picture p24: schematic 01_Power_USB.kicad_sch, USB-C input, ESD and 3.3 V regulation, part in row 1, column 1]

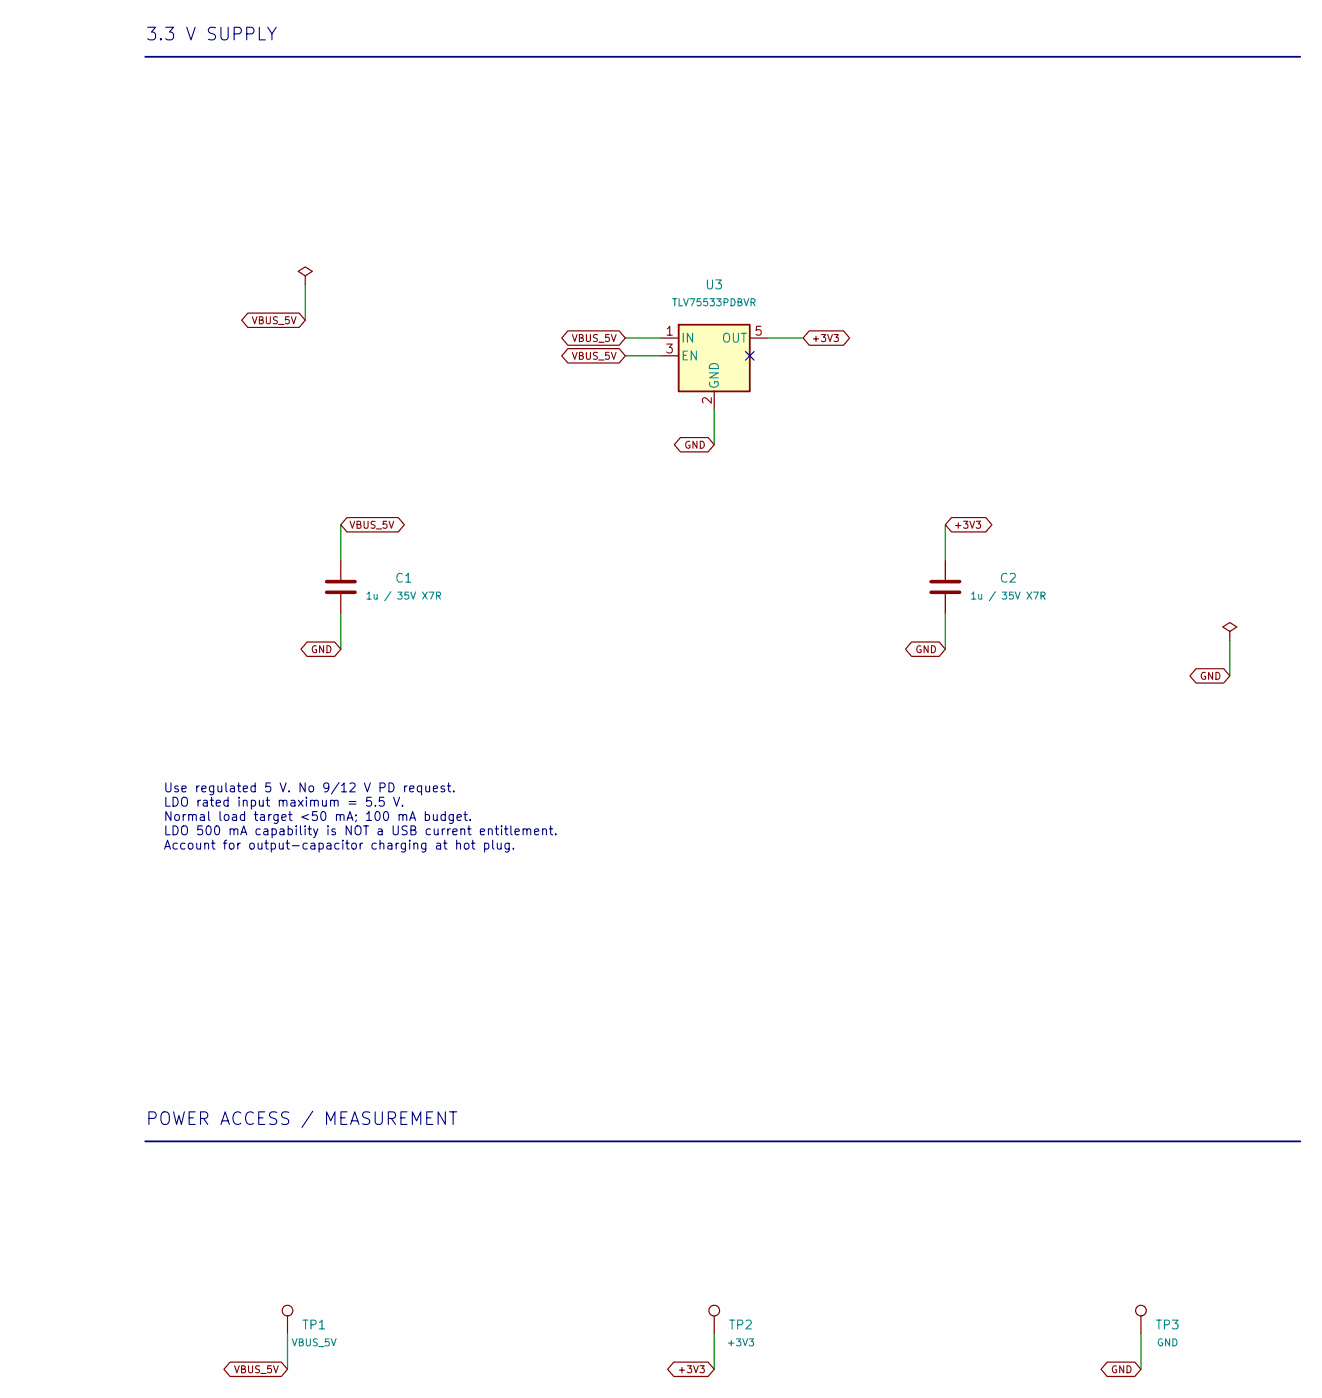
[picture p25: schematic 01_Power_USB.kicad_sch, USB-C input, ESD and 3.3 V regulation, part in row 1, column 2]

Parts:
C1, C2: 1u / 35V X7R; C_0603_1608Metric; MPN C1608X7R1V105K080AC
D91: TPD1E10B06; D_SOD-523; MPN TPD1E10B06DYAR
J1: UJC-HP-3-SMT-TR; CUI_UJC-HP-3-SMT-TR; MPN UJC-HP-3-SMT-TR
R1, R2: 5.1k 1%; R_0603_1608Metric; MPN ERJ3EKF5101V
TP1: VBUS_5V; TestPoint_Pad_D1.0mm
TP2: +3V3; TestPoint_Pad_D1.0mm
TP3: GND; TestPoint_Pad_D1.0mm
U3: TLV75533PDBVR; SOT-23-5; MPN TLV75533PDBVR
U5: TPD2E2U06DCK; SOT-323_SC-70; MPN TPD2E2U06DCKR

Connections:
+3V3: C2.1, TP2.1, U3.5 (OUT); also elsewhere on the board
GND: C1.2, C2.2, D91.2 (A2), J1.A12 (GND), J1.B12 (GND), J1.S1 (SHIELD), J1.S2 (SHIELD), J1.S3 (SHIELD), J1.S4 (SHIELD), R1.2, R2.2, TP3.1, U3.2 (GND), U5.3; also elsewhere on the board
USB_CC1: J1.A5 (CC1), R1.1, U5.1
USB_CC2: J1.B5 (CC2), R2.1, U5.2
VBUS_5V: C1.1, D91.1 (A1), J1.A9 (VBUS), J1.B9 (VBUS), TP1.1, U3.1 (IN), U3.3 (EN)

Notes on the sheet:
USB-C POWER INPUT
Independent Rd on CC1 and CC2. Power-only connector: no D+/D- or SBU. A9/B9 = VBUS; A12/B12 and all shield anchors = GND.
INTERFACE TRANSIENT PROTECTION
Place protection at connector, with short ground return. TVS is transient protection, not DC overvoltage regulation. Board-level ESD and hot-plug performance require testing.
3.3 V SUPPLY
Use regulated 5 V. No 9/12 V PD request. LDO rated input maximum = 5.5 V. Normal load target <50 mA; 100 mA budget. LDO 500 mA capability is NOT a USB current entitlement. Account for output-capacitor charging at hot plug.
POWER ACCESS / MEASUREMENT

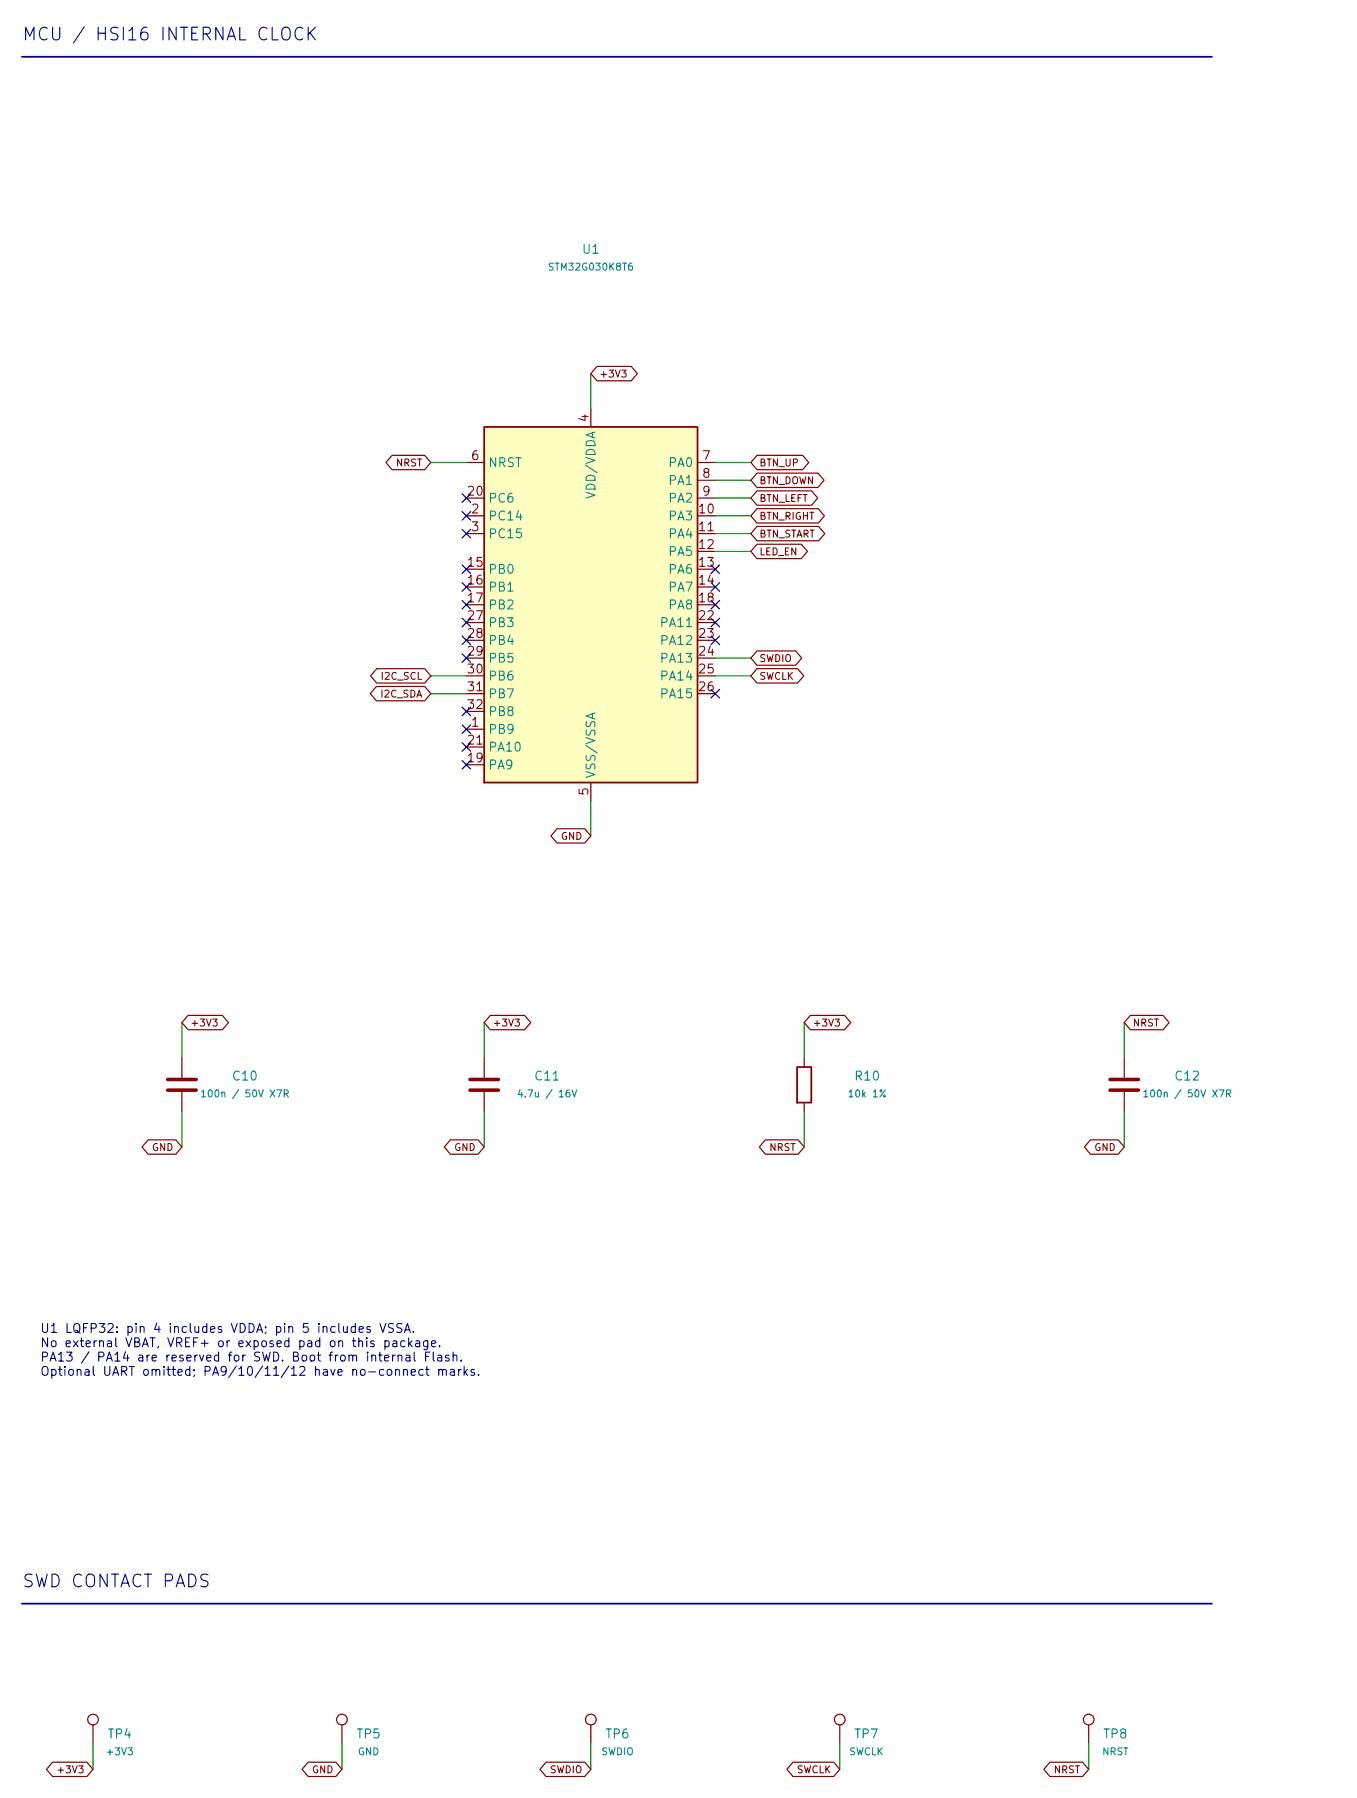
[picture p26: schematic 02_MCU_Inputs_Debug.kicad_sch, STM32G030, five controls and SWD, part in row 1, column 1]

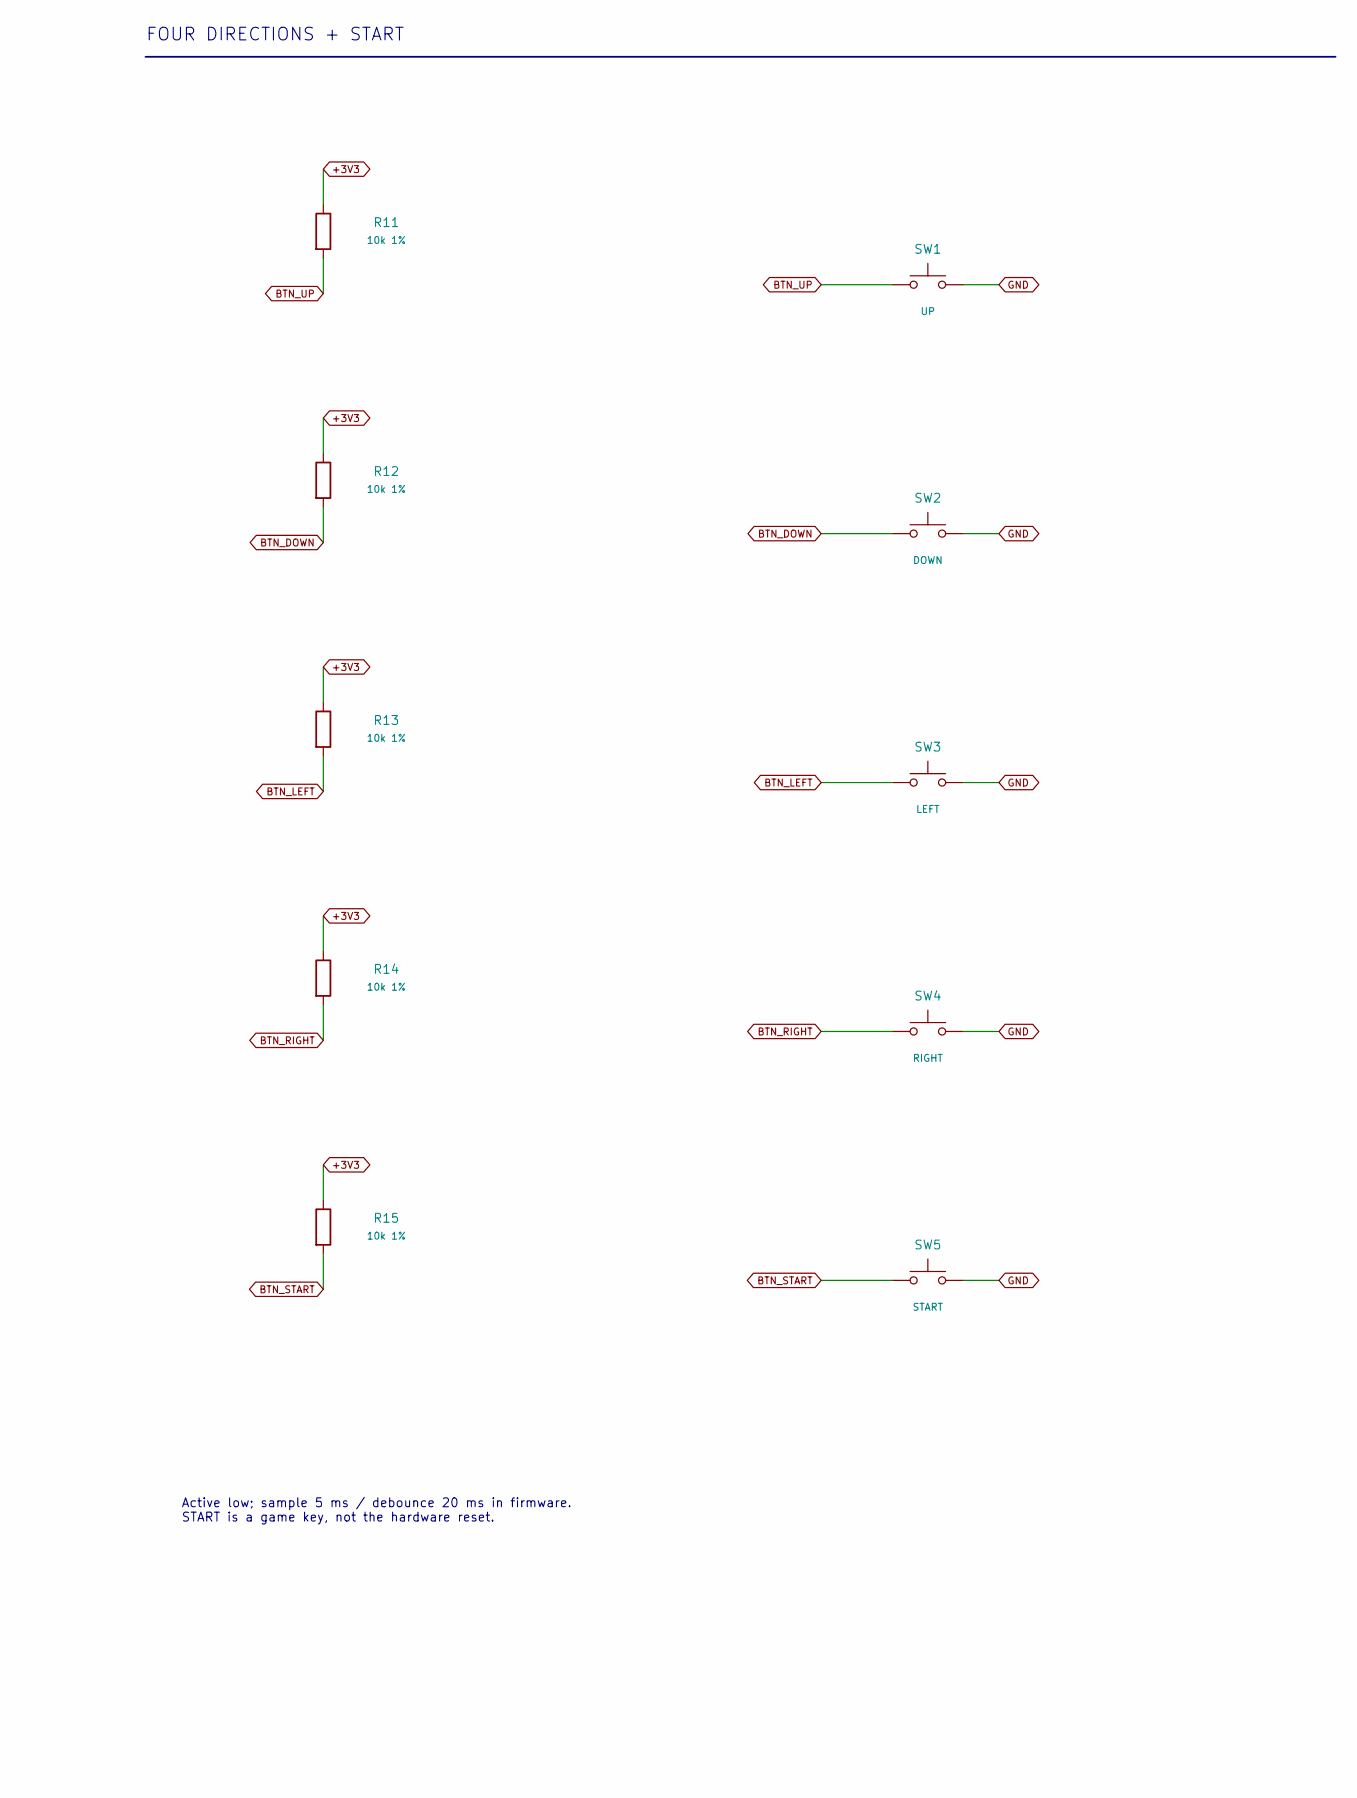
[picture p27: schematic 02_MCU_Inputs_Debug.kicad_sch, STM32G030, five controls and SWD, part in row 1, column 2]

Parts:
C10, C12: 100n / 50V X7R; C_0603_1608Metric; MPN C1608X7R1H104K080AA
C11: 4.7u / 16V; C_0603_1608Metric; MPN GRM188Z71C475KE21D
R10, R11, R12, R13, R14, R15: 10k 1%; R_0603_1608Metric; MPN ERJ3EKF1002V
SW1: UP; SW_SPST_SKQG_WithStem; MPN SKQGABE010
SW2: DOWN; SW_SPST_SKQG_WithStem; MPN SKQGABE010
SW3: LEFT; SW_SPST_SKQG_WithStem; MPN SKQGABE010
SW4: RIGHT; SW_SPST_SKQG_WithStem; MPN SKQGABE010
SW5: START; SW_SPST_SKQG_WithStem; MPN SKQGABE010
TP4: +3V3; TestPoint_Pad_D1.0mm
TP5: GND; TestPoint_Pad_D1.0mm
TP6: SWDIO; TestPoint_Pad_D1.0mm
TP7: SWCLK; TestPoint_Pad_D1.0mm
TP8: NRST; TestPoint_Pad_D1.0mm
U1: STM32G030K8T6; LQFP-32_7x7mm_P0.8mm; MPN STM32G030K8T6

Connections:
+3V3: C10.1, C11.1, R10.1, R11.1, R12.1, R13.1, R14.1, R15.1, TP4.1, U1.4 (VDD/VDDA); also elsewhere on the board
BTN_DOWN: R12.2, SW2.1, U1.8 (PA1)
BTN_LEFT: R13.2, SW3.1, U1.9 (PA2)
BTN_RIGHT: R14.2, SW4.1, U1.10 (PA3)
BTN_START: R15.2, SW5.1, U1.11 (PA4)
BTN_UP: R11.2, SW1.1, U1.7 (PA0)
GND: C10.2, C11.2, C12.2, SW1.2, SW2.2, SW3.2, SW4.2, SW5.2, TP5.1, U1.5 (VSS/VSSA); also elsewhere on the board
I2C_SCL: U1.30 (PB6); also elsewhere on the board
I2C_SDA: U1.31 (PB7); also elsewhere on the board
LED_EN: U1.12 (PA5); also elsewhere on the board
NRST: C12.1, R10.2, TP8.1, U1.6 (NRST)
SWCLK: TP7.1, U1.25 (PA14)
SWDIO: TP6.1, U1.24 (PA13)

Notes on the sheet:
MCU / HSI16 INTERNAL CLOCK
U1 LQFP32: pin 4 includes VDDA; pin 5 includes VSSA. No external VBAT, VREF+ or exposed pad on this package. PA13 / PA14 are reserved for SWD. Boot from internal Flash. Optional UART omitted; PA9/10/11/12 have no-connect marks.
FOUR DIRECTIONS + START
Active low; sample 5 ms / debounce 20 ms in firmware. START is a game key, not the hardware reset.
SWD CONTACT PADS

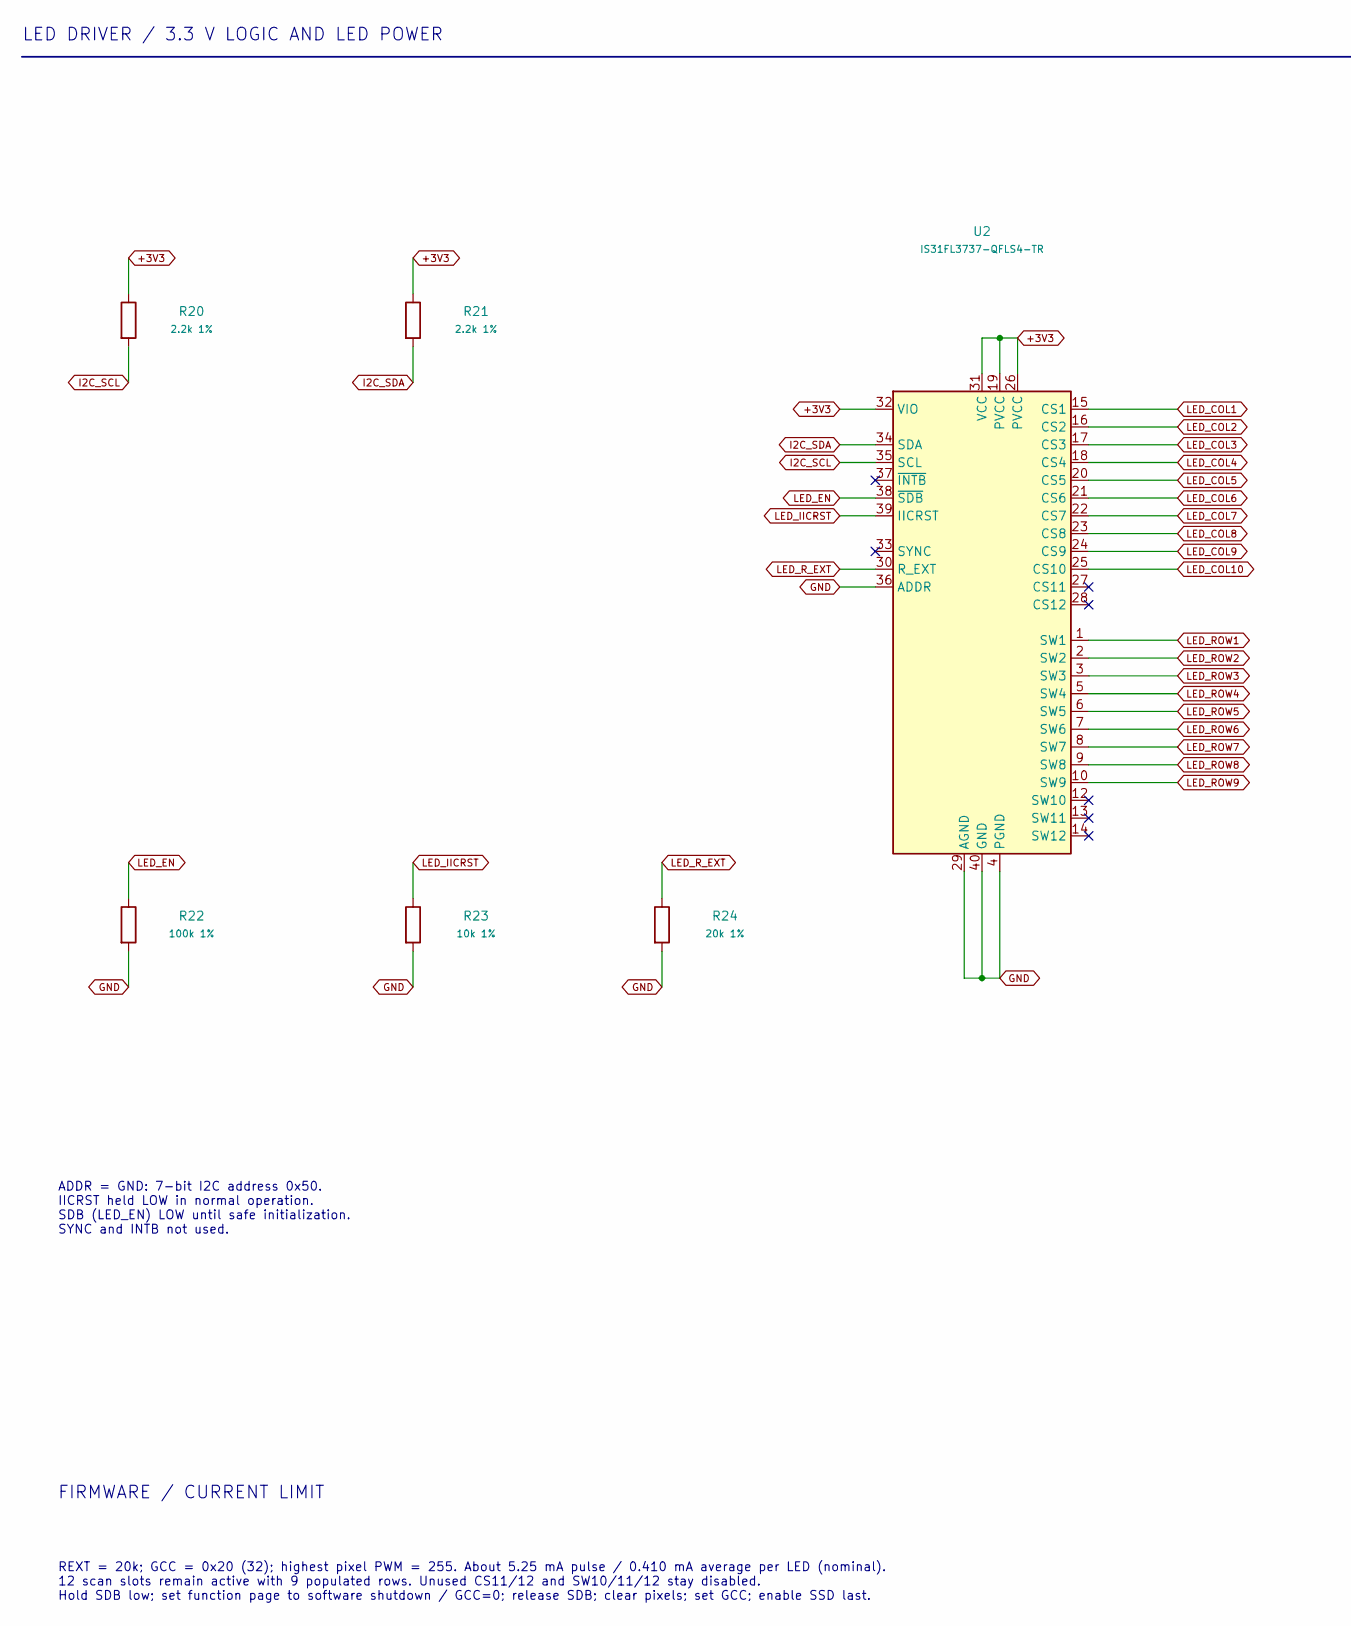
[picture p28: schematic 03_LED_Driver.kicad_sch, IS31FL3737 constant-current matrix driver, part in row 1, column 1]

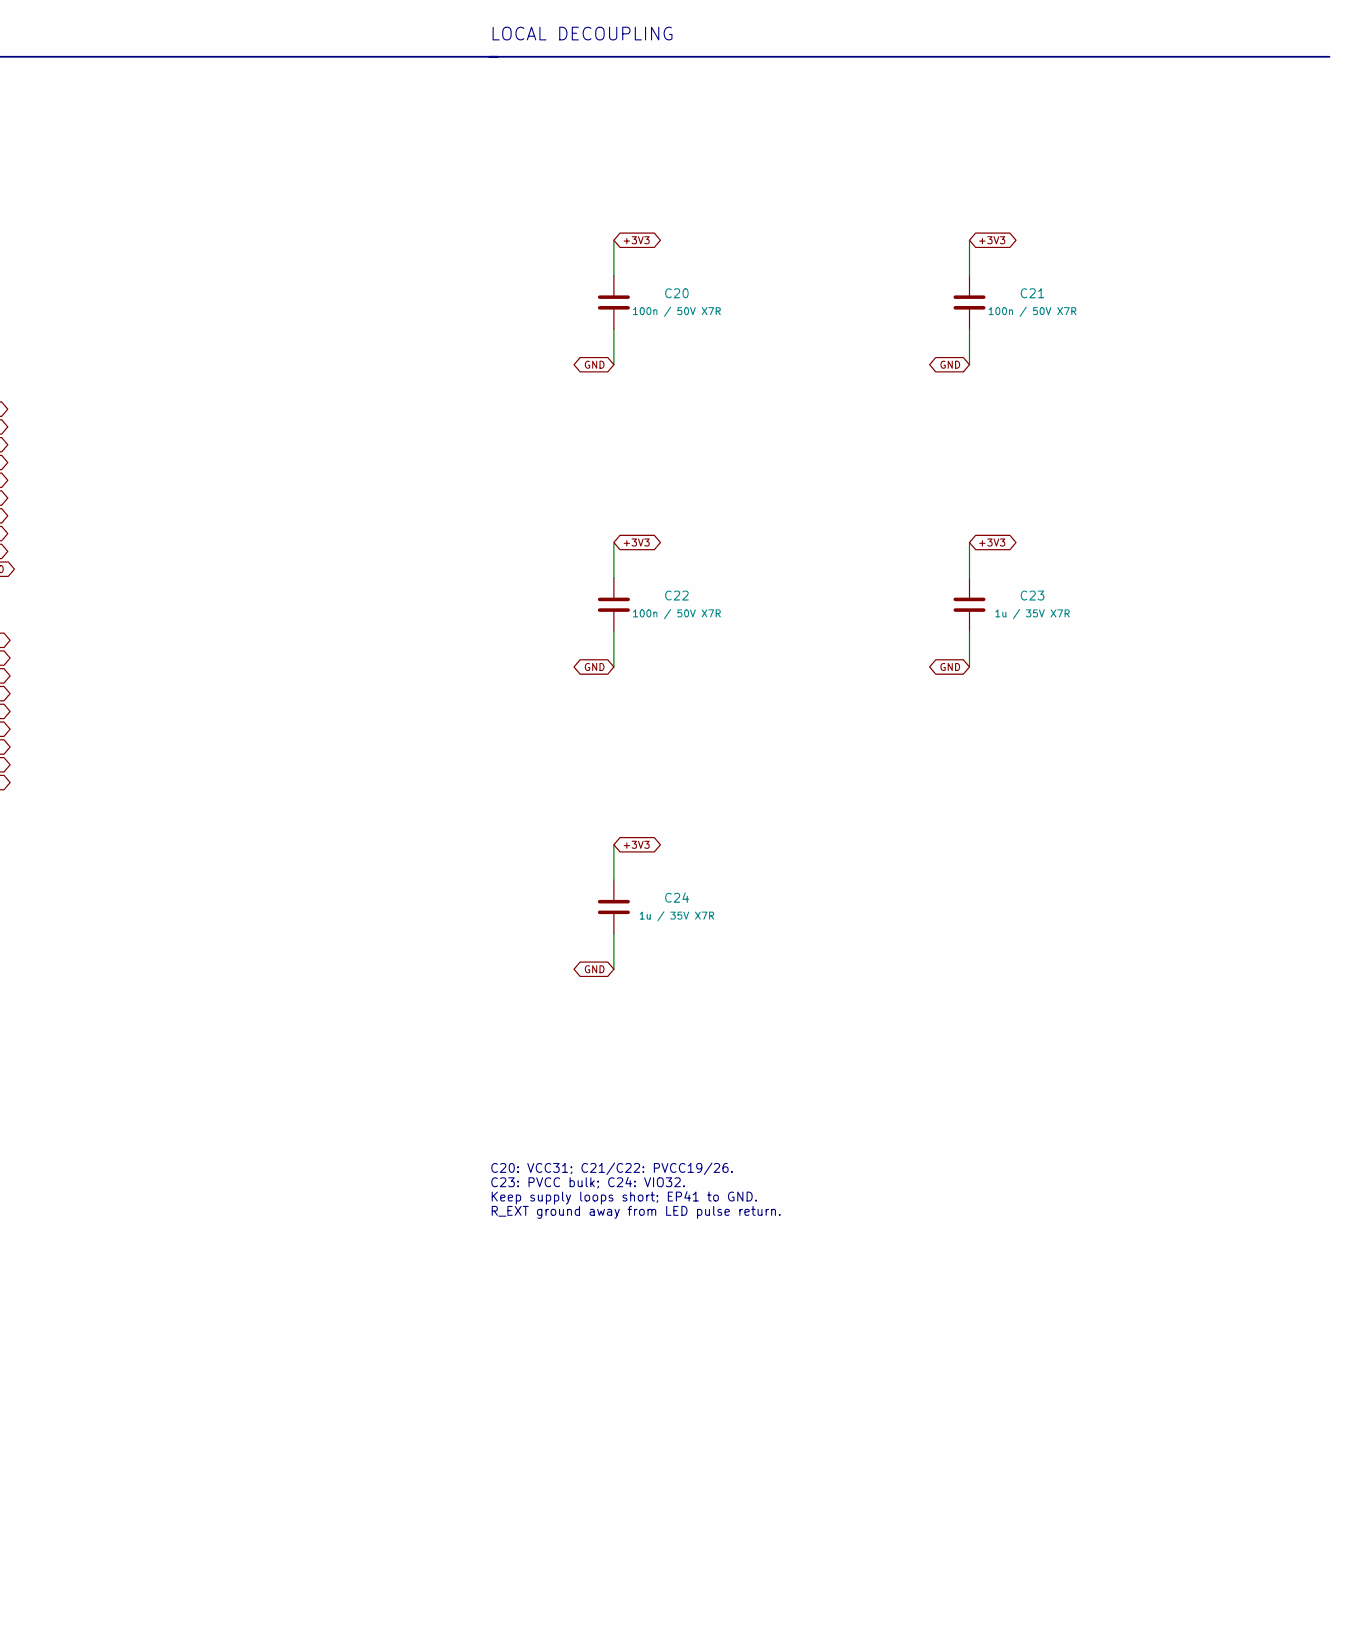
[picture p29: schematic 03_LED_Driver.kicad_sch, IS31FL3737 constant-current matrix driver, part in row 1, column 2]

Parts:
C20, C21, C22: 100n / 50V X7R; C_0603_1608Metric; MPN C1608X7R1H104K080AA
C23, C24: 1u / 35V X7R; C_0603_1608Metric; MPN C1608X7R1V105K080AC
R20, R21: 2.2k 1%; R_0603_1608Metric; MPN ERJ3EKF2201V
R22: 100k 1%; R_0603_1608Metric; MPN ERJ3EKF1003V
R23: 10k 1%; R_0603_1608Metric; MPN ERJ3EKF1002V
R24: 20k 1%; R_0603_1608Metric; MPN ERJ3EKF2002V
U2: IS31FL3737-QFLS4-TR; IS31FL3737_QFN40_5x5mm_P0.4mm_EP3.4mm; MPN IS31FL3737-QFLS4-TR

Connections:
+3V3: C20.1, C21.1, C22.1, C23.1, C24.1, R20.1, R21.1, U2.19 (PVCC), U2.26 (PVCC), U2.31 (VCC), U2.32 (VIO); also elsewhere on the board
GND: C20.2, C21.2, C22.2, C23.2, C24.2, R22.2, R23.2, R24.2, U2.4 (PGND), U2.11 (PGND), U2.29 (AGND), U2.36 (ADDR), U2.40 (GND), U2.41 (GND); also elsewhere on the board
I2C_SCL: R20.2, U2.35 (SCL); also elsewhere on the board
I2C_SDA: R21.2, U2.34 (SDA); also elsewhere on the board
LED_COL1: U2.15 (CS1); also elsewhere on the board
LED_COL2: U2.16 (CS2); also elsewhere on the board
LED_COL3: U2.17 (CS3); also elsewhere on the board
LED_COL4: U2.18 (CS4); also elsewhere on the board
LED_COL5: U2.20 (CS5); also elsewhere on the board
LED_COL6: U2.21 (CS6); also elsewhere on the board
LED_COL7: U2.22 (CS7); also elsewhere on the board
LED_COL8: U2.23 (CS8); also elsewhere on the board
LED_COL9: U2.24 (CS9); also elsewhere on the board
LED_COL10: U2.25 (CS10); also elsewhere on the board
LED_EN: R22.1, U2.38 (~SDB); also elsewhere on the board
LED_IICRST: R23.1, U2.39 (IICRST)
LED_ROW1: U2.1 (SW1); also elsewhere on the board
LED_ROW2: U2.2 (SW2); also elsewhere on the board
LED_ROW3: U2.3 (SW3); also elsewhere on the board
LED_ROW4: U2.5 (SW4); also elsewhere on the board
LED_ROW5: U2.6 (SW5); also elsewhere on the board
LED_ROW6: U2.7 (SW6); also elsewhere on the board
LED_ROW7: U2.8 (SW7); also elsewhere on the board
LED_ROW8: U2.9 (SW8); also elsewhere on the board
LED_ROW9: U2.10 (SW9); also elsewhere on the board
LED_R_EXT: R24.1, U2.30 (R_EXT)

Notes on the sheet:
LED DRIVER / 3.3 V LOGIC AND LED POWER
ADDR = GND: 7-bit I2C address 0x50. IICRST held LOW in normal operation. SDB (LED_EN) LOW until safe initialization. SYNC and INTB not used.
LOCAL DECOUPLING
C20: VCC31; C21/C22: PVCC19/26. C23: PVCC bulk; C24: VIO32. Keep supply loops short; EP41 to GND. R_EXT ground away from LED pulse return.
FIRMWARE / CURRENT LIMIT
REXT = 20k; GCC = 0x20 (32); highest pixel PWM = 255. About 5.25 mA pulse / 0.410 mA average per LED (nominal). 12 scan slots remain active with 9 populated rows. Unused CS11/12 and SW10/11/12 stay disabled. Hold SDB low; set function page to software shutdown / GCC=0; release SDB; clear pixels; se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

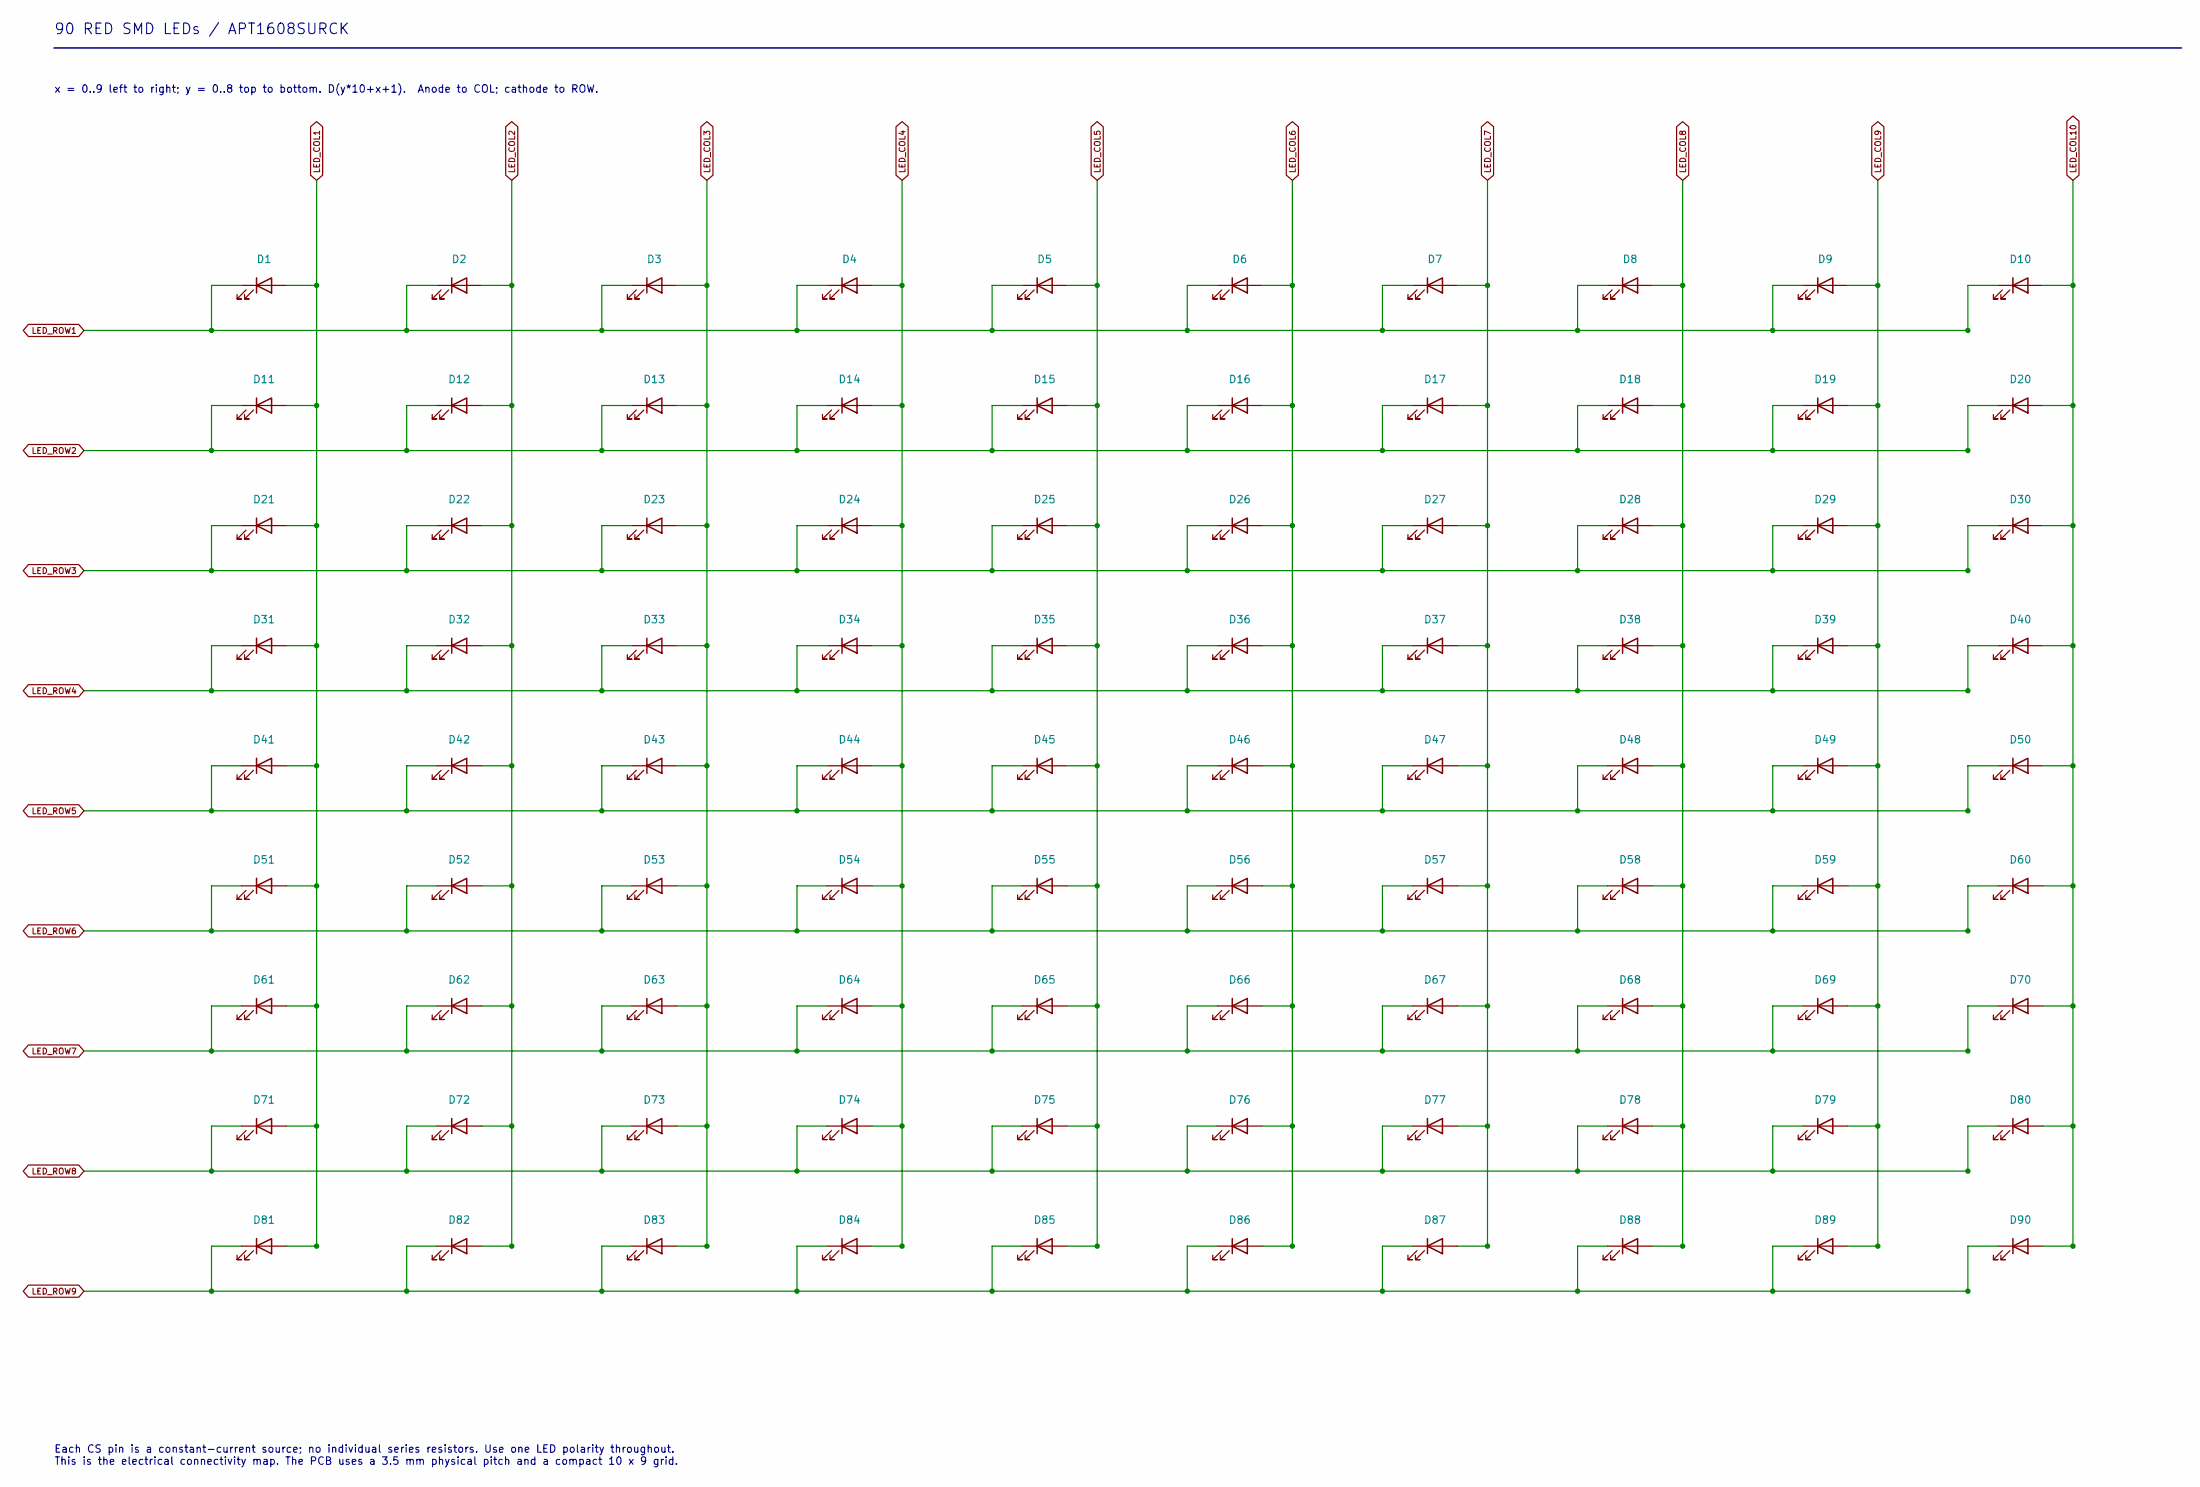
[picture p30: schematic 04_LED_Matrix.kicad_sch, 10 columns x 9 rows - 90 red LEDs]

Parts:
D1, D2, D3, D4, D5, D6, D7, D8, D9, D10, D11, D12, D13, D14, D15, D16, D17, D18, D19, D20, D21, D22, D23, D24, D25, D26, D27, D28, D29, D30, D31, D32, D33, D34, D35, D36, D37, D38, D39, D40, D41, D42, D43, D44, D45, D46, D47, D48, D49, D50, D51, D52, D53, D54, D55, D56, D57, D58, D59, D60, D61, D62, D63, D64, D65, D66, D67, D68, D69, D70, D71, D72, D73, D74, D75, D76, D77, D78, D79, D80, D81, D82, D83, D84, D85, D86, D87, D88, D89, D90: RED; Kingbright_APT1608SURCK; MPN APT1608SURCK

Connections:
LED_COL1: D1.2 (A), D11.2 (A), D21.2 (A), D31.2 (A), D41.2 (A), D51.2 (A), D61.2 (A), D71.2 (A), D81.2 (A); also elsewhere on the board
LED_COL2: D2.2 (A), D12.2 (A), D22.2 (A), D32.2 (A), D42.2 (A), D52.2 (A), D62.2 (A), D72.2 (A), D82.2 (A); also elsewhere on the board
LED_COL3: D3.2 (A), D13.2 (A), D23.2 (A), D33.2 (A), D43.2 (A), D53.2 (A), D63.2 (A), D73.2 (A), D83.2 (A); also elsewhere on the board
LED_COL4: D4.2 (A), D14.2 (A), D24.2 (A), D34.2 (A), D44.2 (A), D54.2 (A), D64.2 (A), D74.2 (A), D84.2 (A); also elsewhere on the board
LED_COL5: D5.2 (A), D15.2 (A), D25.2 (A), D35.2 (A), D45.2 (A), D55.2 (A), D65.2 (A), D75.2 (A), D85.2 (A); also elsewhere on the board
LED_COL6: D6.2 (A), D16.2 (A), D26.2 (A), D36.2 (A), D46.2 (A), D56.2 (A), D66.2 (A), D76.2 (A), D86.2 (A); also elsewhere on the board
LED_COL7: D7.2 (A), D17.2 (A), D27.2 (A), D37.2 (A), D47.2 (A), D57.2 (A), D67.2 (A), D77.2 (A), D87.2 (A); also elsewhere on the board
LED_COL8: D8.2 (A), D18.2 (A), D28.2 (A), D38.2 (A), D48.2 (A), D58.2 (A), D68.2 (A), D78.2 (A), D88.2 (A); also elsewhere on the board
LED_COL9: D9.2 (A), D19.2 (A), D29.2 (A), D39.2 (A), D49.2 (A), D59.2 (A), D69.2 (A), D79.2 (A), D89.2 (A); also elsewhere on the board
LED_COL10: D10.2 (A), D20.2 (A), D30.2 (A), D40.2 (A), D50.2 (A), D60.2 (A), D70.2 (A), D80.2 (A), D90.2 (A); also elsewhere on the board
LED_ROW1: D1.1 (K), D2.1 (K), D3.1 (K), D4.1 (K), D5.1 (K), D6.1 (K), D7.1 (K), D8.1 (K), D9.1 (K), D10.1 (K); also elsewhere on the board
LED_ROW2: D11.1 (K), D12.1 (K), D13.1 (K), D14.1 (K), D15.1 (K), D16.1 (K), D17.1 (K), D18.1 (K), D19.1 (K), D20.1 (K); also elsewhere on the board
LED_ROW3: D21.1 (K), D22.1 (K), D23.1 (K), D24.1 (K), D25.1 (K), D26.1 (K), D27.1 (K), D28.1 (K), D29.1 (K), D30.1 (K); also elsewhere on the board
LED_ROW4: D31.1 (K), D32.1 (K), D33.1 (K), D34.1 (K), D35.1 (K), D36.1 (K), D37.1 (K), D38.1 (K), D39.1 (K), D40.1 (K); also elsewhere on the board
LED_ROW5: D41.1 (K), D42.1 (K), D43.1 (K), D44.1 (K), D45.1 (K), D46.1 (K), D47.1 (K), D48.1 (K), D49.1 (K), D50.1 (K); also elsewhere on the board
LED_ROW6: D51.1 (K), D52.1 (K), D53.1 (K), D54.1 (K), D55.1 (K), D56.1 (K), D57.1 (K), D58.1 (K), D59.1 (K), D60.1 (K); also elsewhere on the board
LED_ROW7: D61.1 (K), D62.1 (K), D63.1 (K), D64.1 (K), D65.1 (K), D66.1 (K), D67.1 (K), D68.1 (K), D69.1 (K), D70.1 (K); also elsewhere on the board
LED_ROW8: D71.1 (K), D72.1 (K), D73.1 (K), D74.1 (K), D75.1 (K), D76.1 (K), D77.1 (K), D78.1 (K), D79.1 (K), D80.1 (K); also elsewhere on the board
LED_ROW9: D81.1 (K), D82.1 (K), D83.1 (K), D84.1 (K), D85.1 (K), D86.1 (K), D87.1 (K), D88.1 (K), D89.1 (K), D90.1 (K); also elsewhere on the board

Notes on the sheet:
90 RED SMD LEDs / APT1608SURCK
x = 0..9 left to right; y = 0..8 top to bottom. D(y*10+x+1). Anode to COL; cathode to ROW.
Each CS pin is a constant-current source; no individual series resistors. Use one LED polarity throughout. This is the electrical connectivity map. The PCB uses a 3.5 mm physical pitch and a compact 10 x 9 grid.
