alex1324575/snake-pcb-business-card/SnakeBusinessCard.kicad_pcb

## KiCad design SnakeBusinessCard.kicad_pcb (continued)

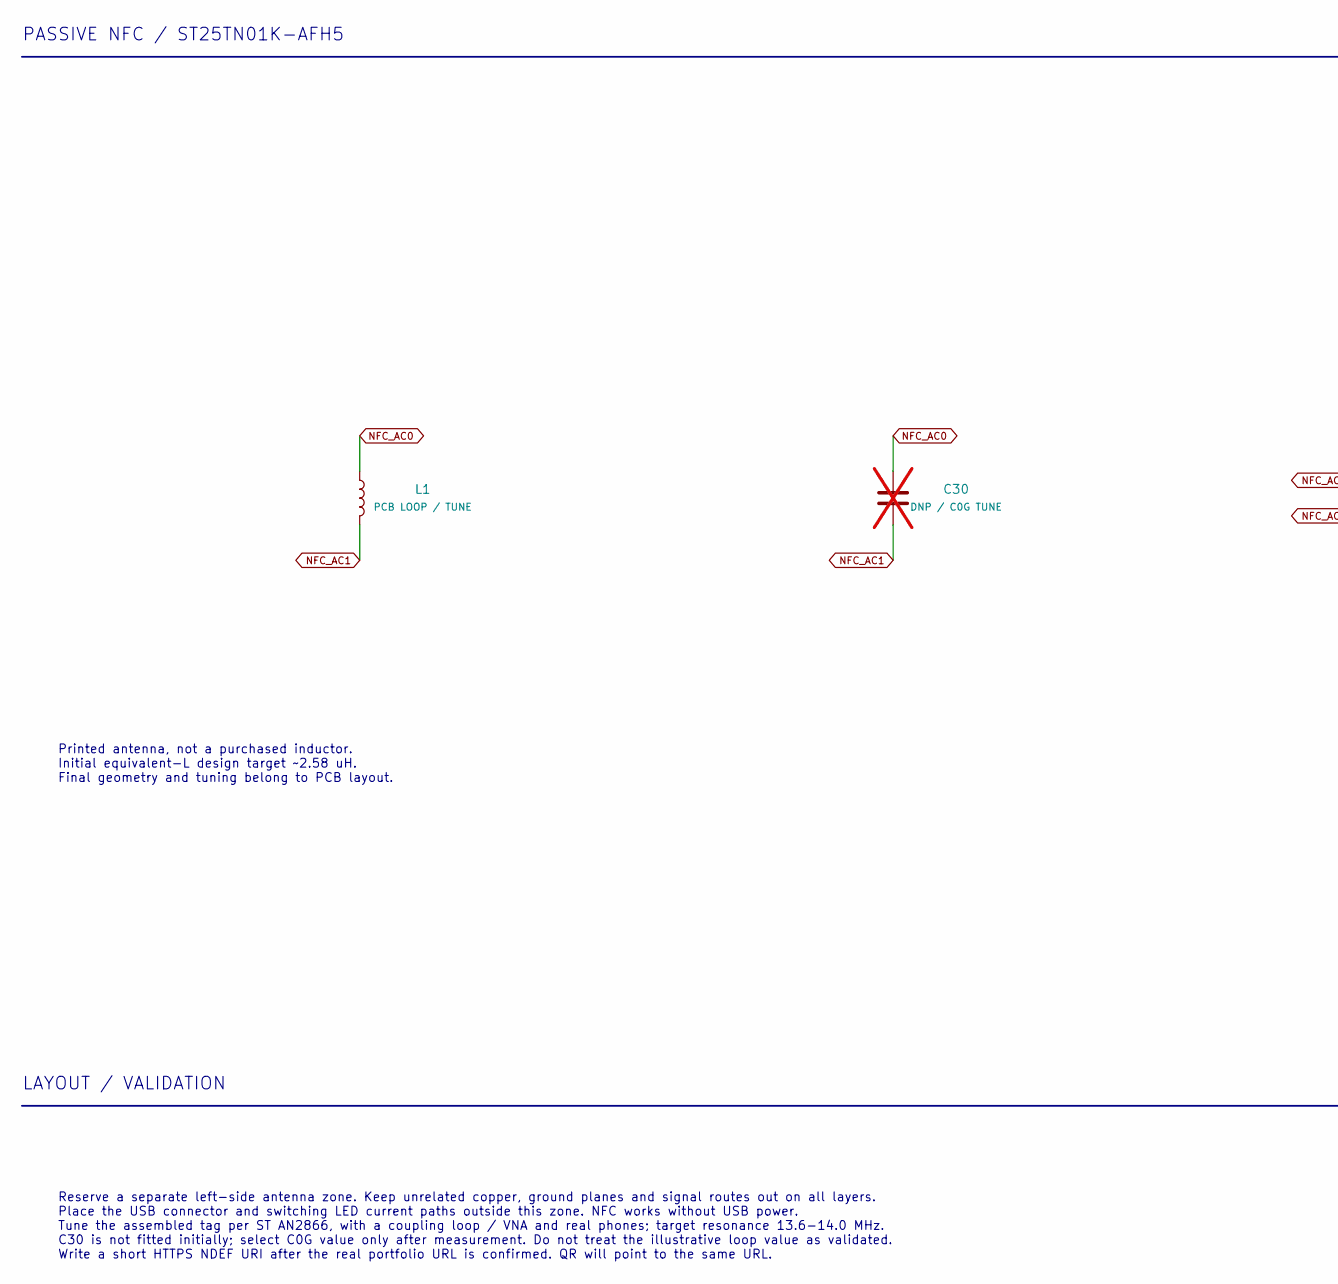
[picture p31: schematic 05_NFC.kicad_sch, Independent passive NFC tag and PCB antenna, part in row 1, column 1]

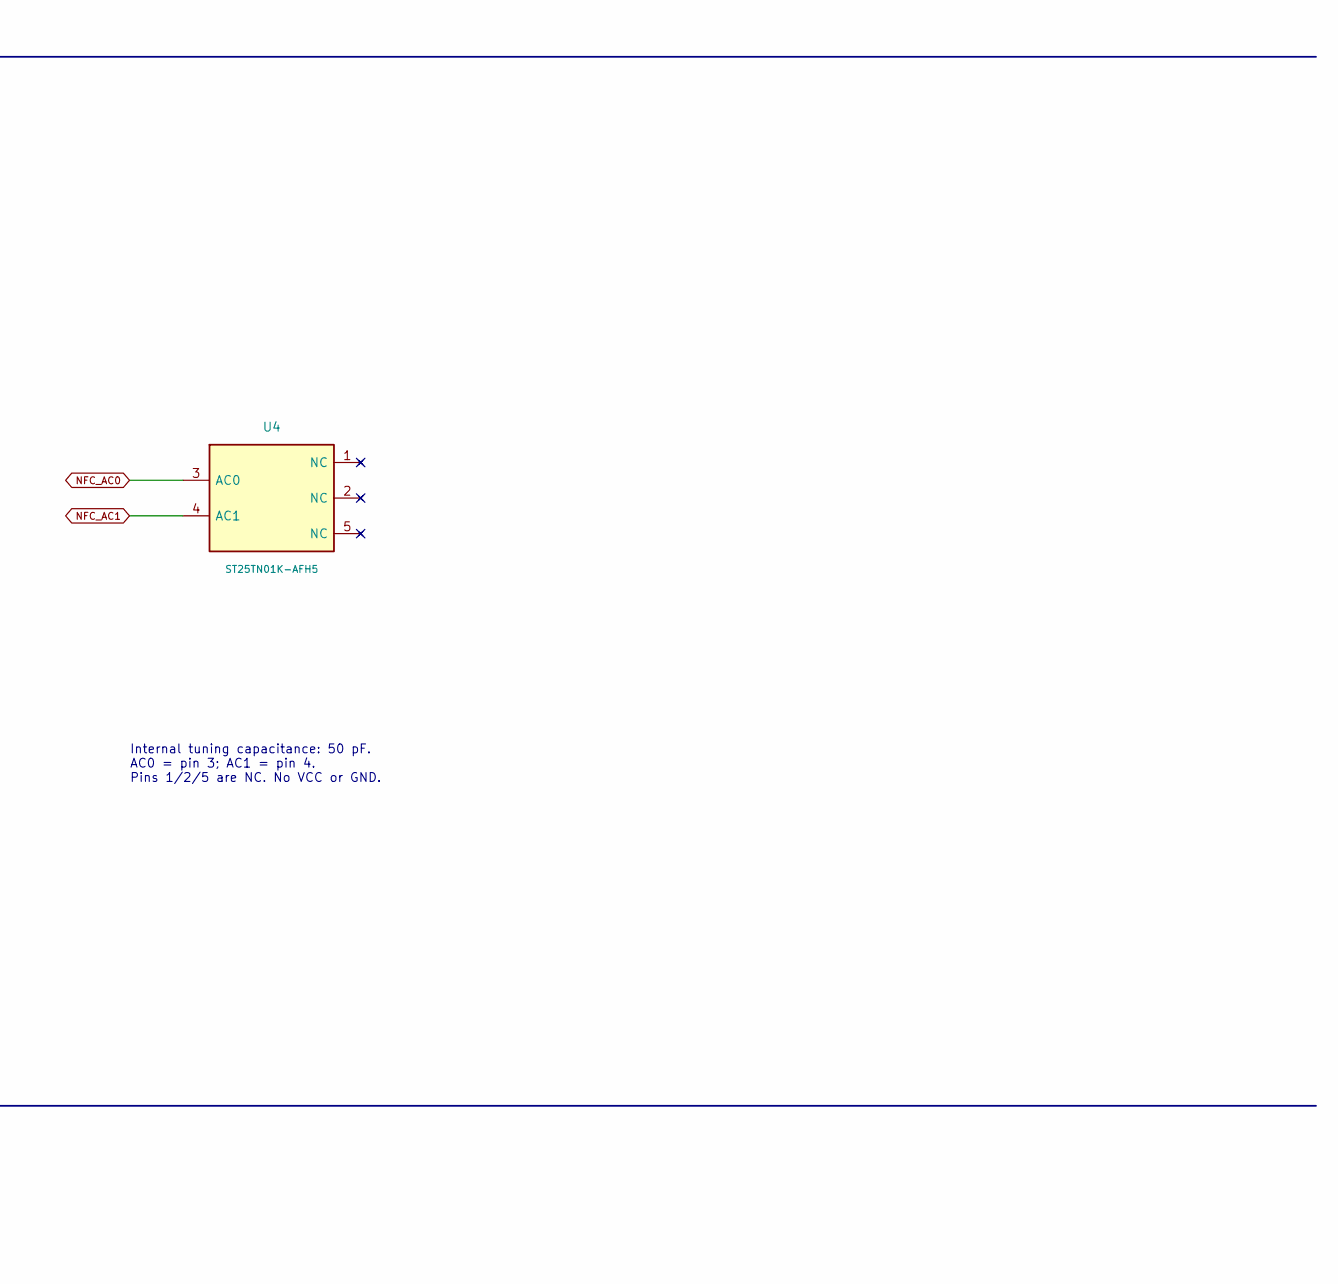
[picture p32: schematic 05_NFC.kicad_sch, Independent passive NFC tag and PCB antenna, part in row 1, column 2]

Parts:
C30: DNP / C0G TUNE; C_0603_1608Metric; not fitted
L1: PCB LOOP / TUNE
U4: ST25TN01K-AFH5; ST25TN01K_UFDFPN5_1.7x1.4mm; MPN ST25TN01K-AFH5

Connections:
NFC_AC0: C30.1, L1.1, U4.3 (AC0); also elsewhere on the board
NFC_AC1: C30.2, L1.2, U4.4 (AC1); also elsewhere on the board

Notes on the sheet:
PASSIVE NFC / ST25TN01K-AFH5
Printed antenna, not a purchased inductor. Initial equivalent-L design target ~2.58 uH. Final geometry and tuning belong to PCB layout.
Internal tuning capacitance: 50 pF. AC0 = pin 3; AC1 = pin 4. Pins 1/2/5 are NC. No VCC or GND.
LAYOUT / VALIDATION
Reserve a separate left-side antenna zone. Keep unrelated copper, ground planes and signal routes out on all layers. Place the USB connector and switching LED current paths outside this zone. NFC works without USB power. Tune the assembled tag per ST AN2866, with a coupling loop / VNA and real phon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

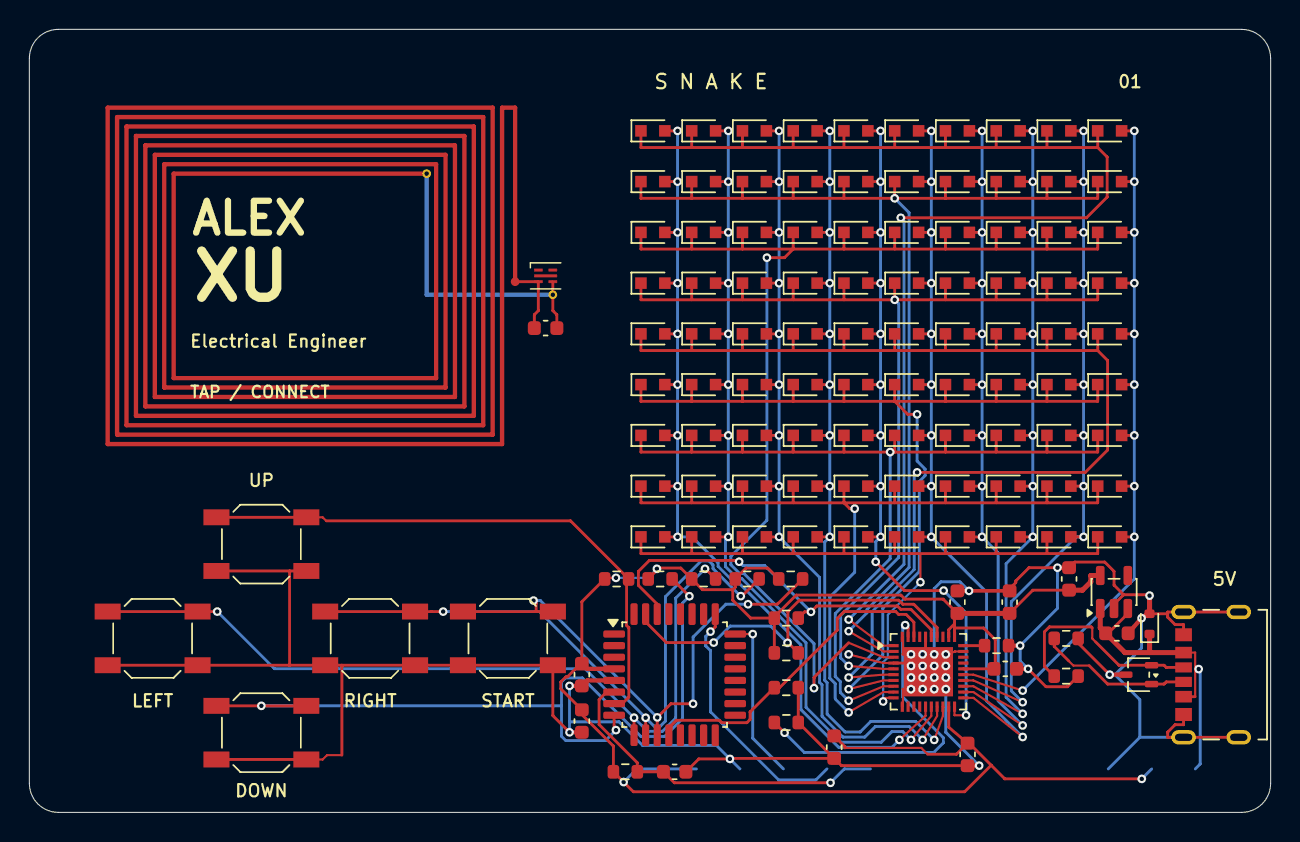
[picture p33: board SnakeBusinessCard.kicad_pcb from above]

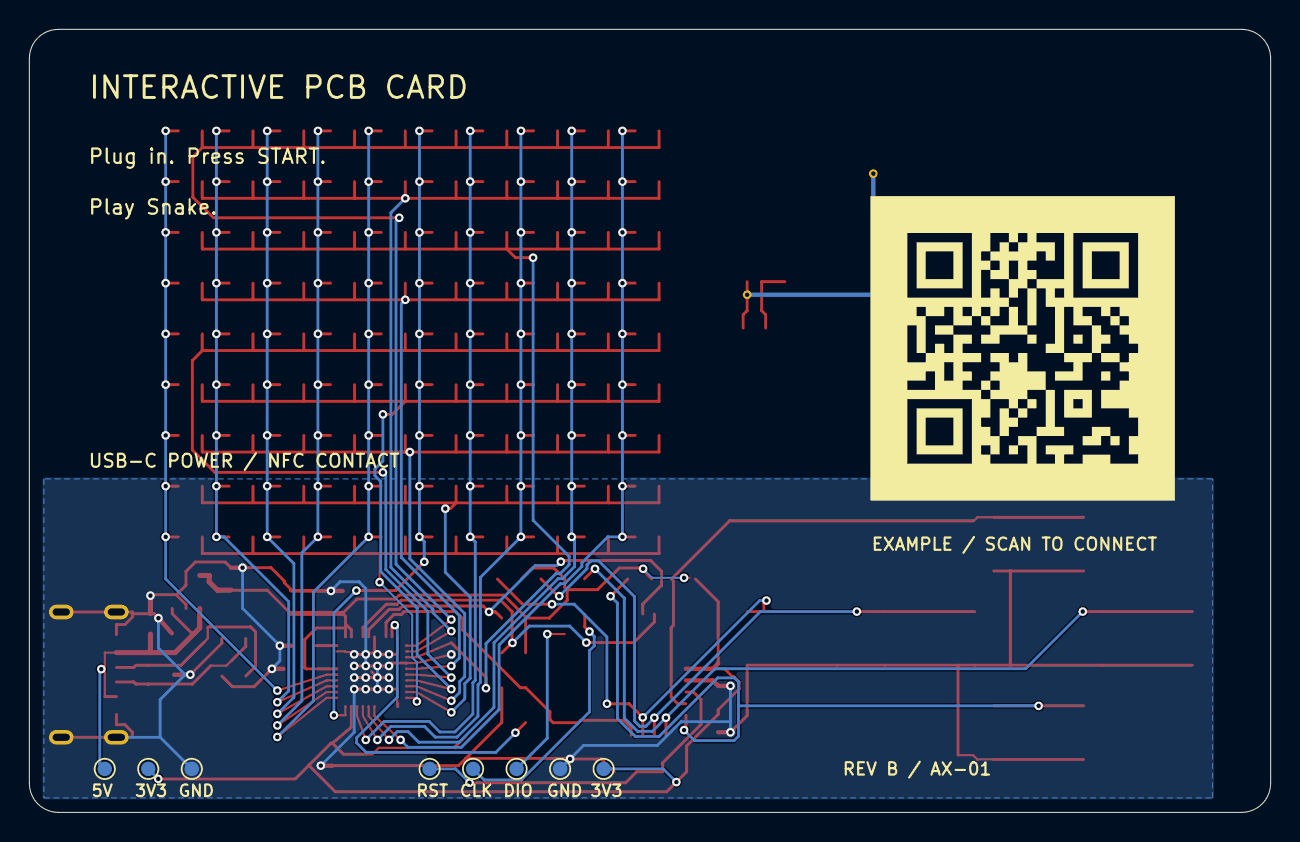
[picture p34: board SnakeBusinessCard.kicad_pcb from below]

Board: 2 copper layers, 85.6 x 54.0 mm, 136 parts (9 on the bottom side), 39 nets.

Other parts of the board:
NT1: NFC_PRINTED_COIL_8T_UNTUNED
QR1: Example QR / https://example.com/; Example_QR_21mm_BSilk

Their connections:
NFC_AC0: NT1.1; also elsewhere on the board
NFC_AC1: NT1.2; also elsewhere on the board
