alex1324575/snake-pcb-business-card/(commit log)

2026-09-26 Add Snake PCB business card hardware and firmware
2026-09-27 Complete procurement BOM and document component review gates
2026-10-11 Add native Altium project and lab assembly documentation
2026-10-28 Add populated Rev C 3D assembly previews
2026-10-29 Add rotating Rev C 3D assembly animation
